ArneAlberts/Bachelorarbeit_Anhang/readme.md

Inhalt:
---------------------------------
Digitale Version der Arbeit
Großen Blockschaltbild
Technische Zeichnung der Platine
Diese Datei

Ordner:
---------------------------------
Schaltung/Layout
Datenblätter
Simulationen
Software
Sonstiges

Software:
---------------------------------
Test-Programm für den MXL7704
Python-Script um Referenzen von Kondensatoren und Widerstände unsichtbar zu schalten

Simulation:
---------------------------------
Eingangsfilter
OPV mit LDO
Schutzschaltungen

Sonstiges:
---------------------------------
Design Rules Multi Circuits Boards

Datenblätter:
---------------------------------
FPGA: User Guides: 470, 471, 475, 480, 482, 483, Foto: Pinout

Schaltkreise:
---------------------------------
USB-Hub: TUSB2046
Ethernet-Phy: KSZ8041
Mikrocontroller: MSP430F5510
FTDI: FT2232H
Current-limiter: TPS2042D
Flash-Speicher: S25FL128SA
DDR3-RAM: MT41K128M16JT
DAC: LTC2627
OPV: OPA2991
Referenzspannung: REF3120
ADC: ADS1115

Diskrete Halbleiter:
---------------------------------
PMOS: Si3421DV
NMOS: BSS127
NMOS: BSS138
Shunt-Regler: TL431
Zener-Diode: KDZVTR10B
HF-NMOS: AFT05MS003N
ESD-Diode: SN65220
BPT: BC847

Spannungsversorgung:
---------------------------------
PMIC: MXL7704
LDO: TPS74012
Boost-Konverter: ABXS002A3X41
LDO: LM1117
LDO: AP2303
LDO: TPS7A470x

Passive Bauteile:
---------------------------------
Sicherungen: NANOASMDCH050F/24-2, MF-USML350/12
Spulen: 74438367022, XEL4030-102, XEL4030-471
Ferrite: 74279224101, 742792043
Gleichtaktdrossel: 744237102

Mechanische Verbinder:
---------------------------------
Doppelte USB-A-Buchse: 61400826021
USB-B-Buchse: 61400416121
uSD-Karte: DM3AT-SF
Ethernet-Buchse: 7499011002
USB-C-Buchse: 632723300011
PCIE-Steckplatz: 10018783-10200TLF
Bias-verbinder: Samtec BSW-104-04-L-S
GPO/SMP: 60114102122403
Spannungsversorgung: TE_171826-4
Spy-By-Wire: TFM-104
Kühlkörper: PR19/20/SE
Buchse-Trigger-Eingang:TE 440054

Sonstiges:
---------------------------------
Takterzeugung: 
830207044109 (100 MHz)
ATS25ASM-1 (25 MHz)
ATS12ASM-1 (12 MHz)
ATS060SM-1 (6 MHz)
ATS040SM-1 (4 MHz)
ECS-.327-7-12-TR (32 kHz)
