ArneAlberts/Bachelorarbeit_Anhang/Datenblätter/Mechanische_Bauteile/PR19_20_SE.pdf

Type: PR19/20/SE | Spezialkühlkörper

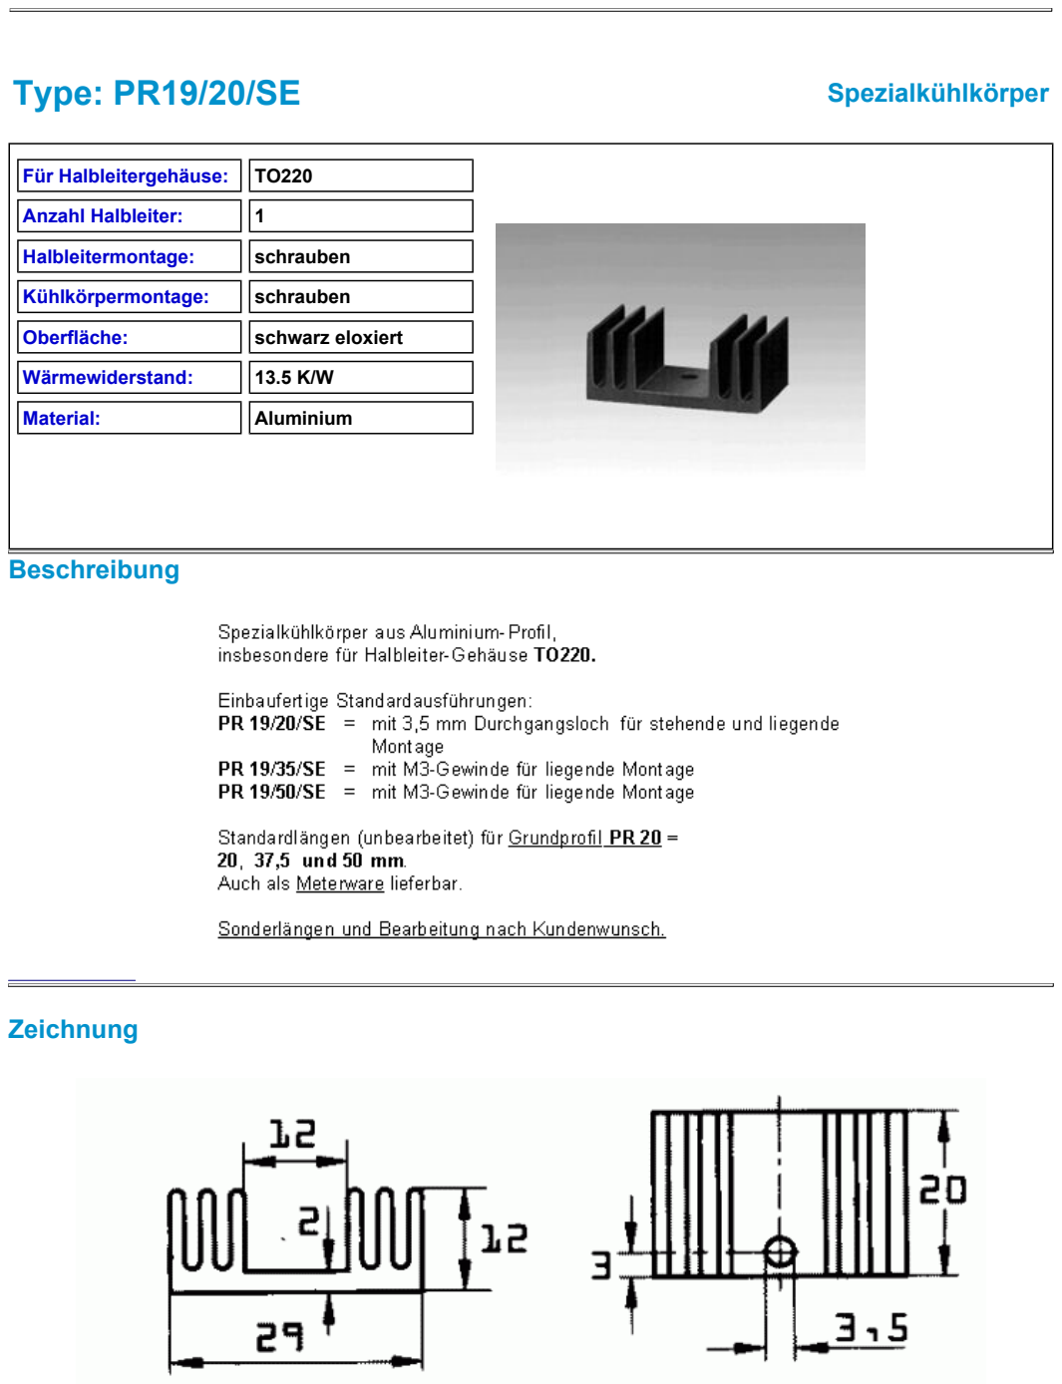
[picture p1: page 1]

## Zeichnung

Für Halbleitergehäuse: | TO220
Anzahl Halbleiter: | 1
Halbleitermontage: | schrauben
Kühlkörpermontage: | schrauben
Oberfläche: | schwarz eloxiert
Wärmewiderstand: | 13.5 K/W
Material: | Aluminium

## Beschreibung
