ArneAlberts/Bachelorarbeit_Anhang/Datenblätter/FPGA/FGG484_IO_OUT.PNG

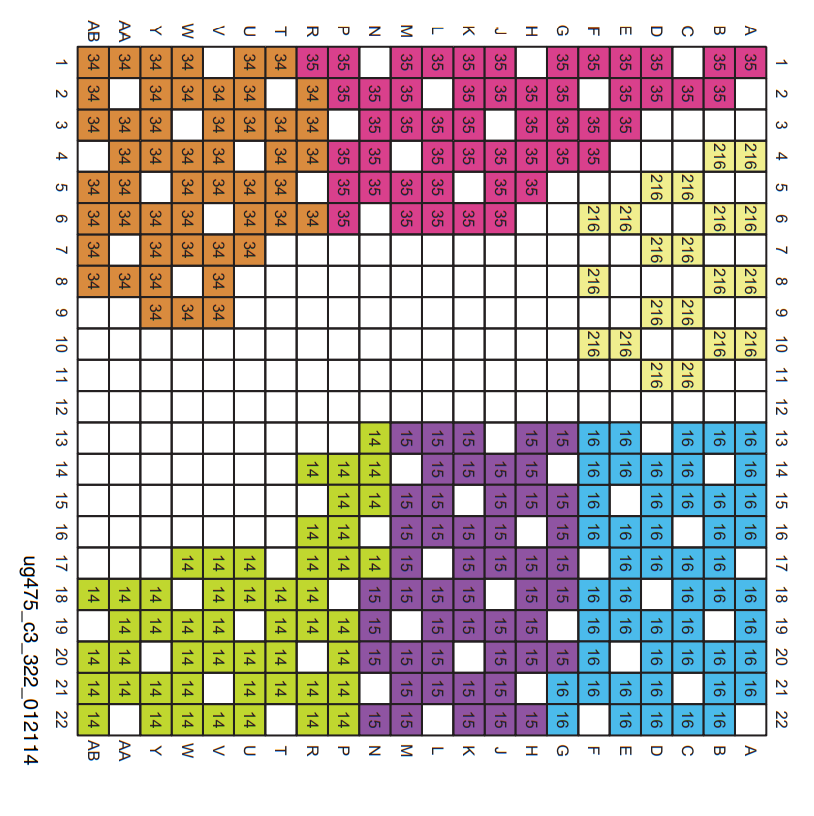
Datenblätter/FPGA/FGG484_IO_OUT.PNG
