ArneAlberts/Bachelorarbeit_Anhang/Schaltung_Layout/3dpackages/i3a_fullfeature_asm.stp

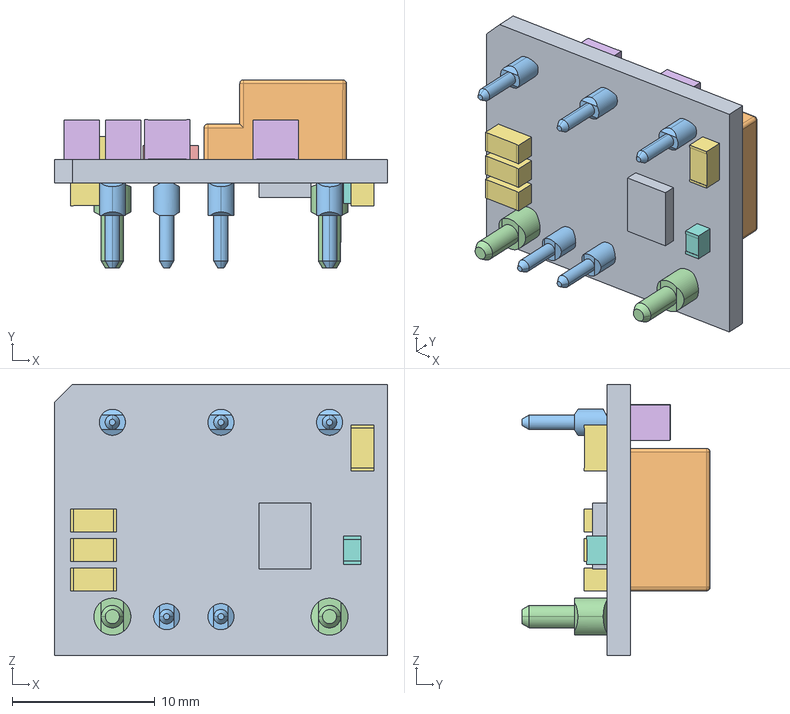
[picture p3: CAD file, 2021-09-20]
Schaltung_Layout/3dpackages/i3a_fullfeature_asm.stp
23.4 x 13.2 x 19.1 mm
I3A_PCB
I3A_OUTPUT_INDUCTOR
ZP00166_01- x 5
ZP00167_01- x 2
I6A_HIGH_SIDE_FET x 2
1210_CAP_COLOR x 4
1206_CAP_COLOR x 6
0805_CAP
I6A_CONTROL_IC2
