ArneAlberts/Bachelorarbeit_Anhang/Schaltung_Layout/3dpackages/modulator-Body_LWL_test.step

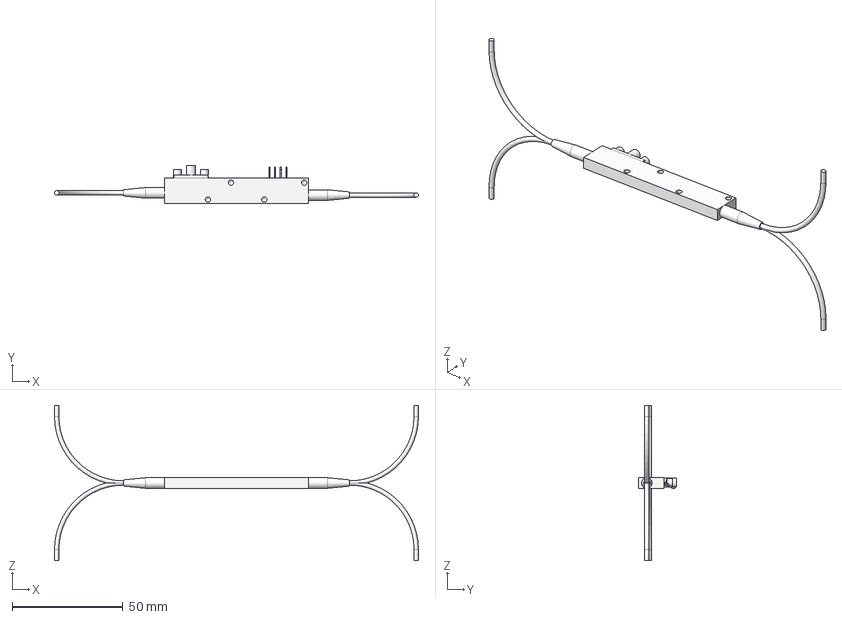
[picture p4: CAD file, 2021-09-20]
Schaltung_Layout/3dpackages/modulator-Body_LWL_test.step
164.0 x 17.2 x 70.0 mm
