ArneAlberts/Bachelorarbeit_Anhang/Schaltung_Layout/Adapter_Modulator/Adapter_Modulator/Adapter_Modulator.step

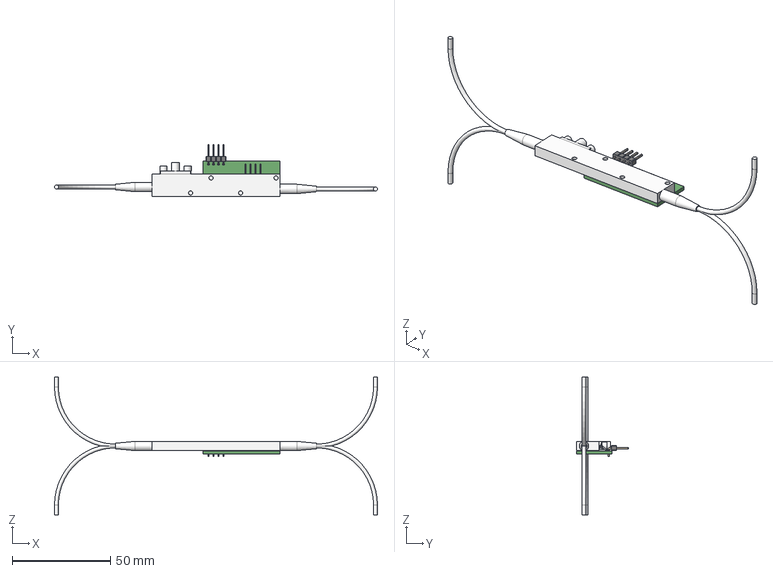
[picture p5: CAD file, 2021-09-20]
Schaltung_Layout/Adapter_Modulator/Adapter_Modulator/Adapter_Modulator.step
164.0 x 26.4 x 70.0 mm
