ArneAlberts/Bachelorarbeit_Anhang/Schaltung_Layout/3dpackages/XEL4030-122MEC.stp

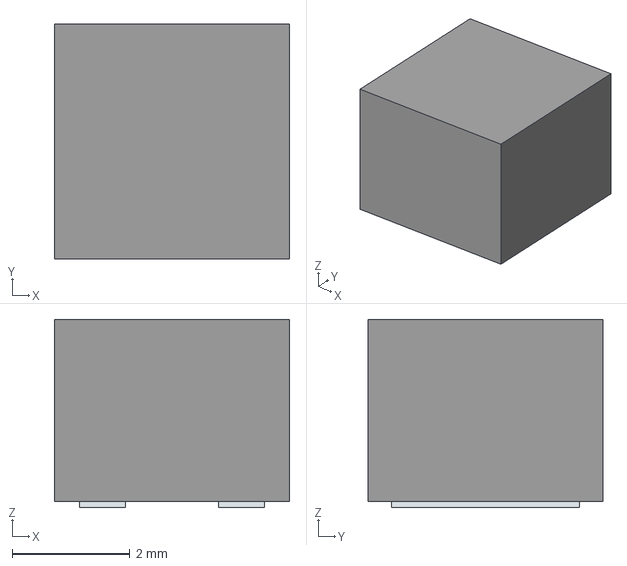
[picture p6: CAD file, 2021-09-20]
Schaltung_Layout/3dpackages/XEL4030-122MEC.stp
4.00 x 4.00 x 3.20 mm
Pins
