ArneAlberts/Bachelorarbeit_Anhang/Schaltung_Layout/3dpackages/ABXS002A3X41-SRZ.stp

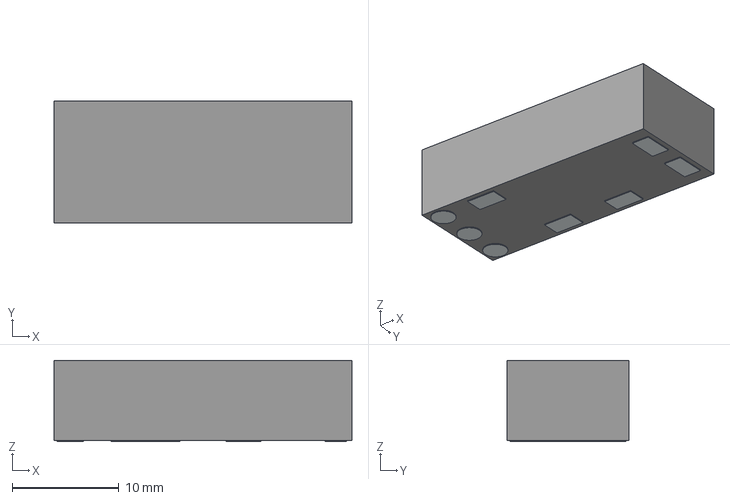
[picture p7: CAD file, 2021-09-20]
Schaltung_Layout/3dpackages/ABXS002A3X41-SRZ.stp
27.9 x 11.4 x 7.60 mm
Pins
