ArneAlberts/Bachelorarbeit_Anhang/Schaltung_Layout/3dpackages/WE-CMDC_744237xxx.stp

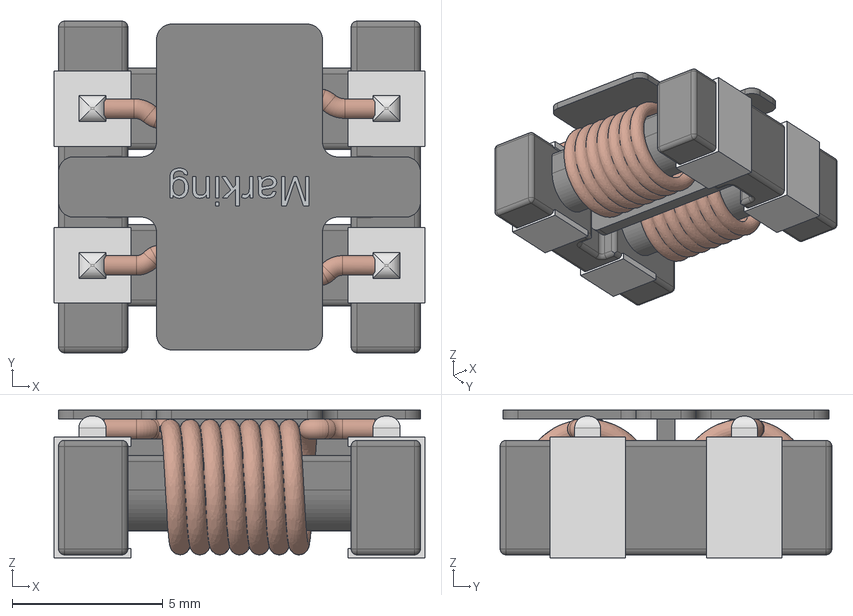
[picture p8: CAD file, 2021-09-20]
Schaltung_Layout/3dpackages/WE-CMDC_744237xxx.stp
12.3 x 11.0 x 4.90 mm
Cap
Ferrite
Coil
Coil_2
