ArneAlberts/Bachelorarbeit_Anhang/Schaltung_Layout/3dpackages/modulator-Body.stp

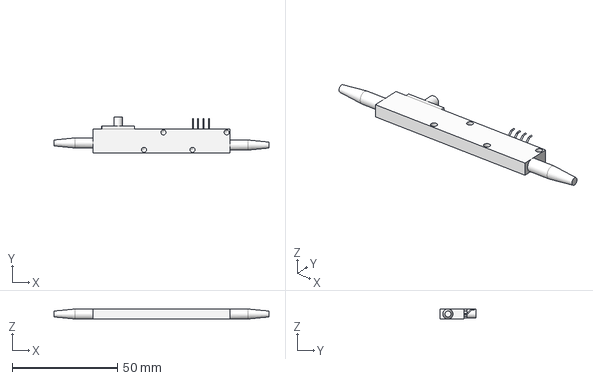
[picture p9: CAD file, 2021-09-20]
Schaltung_Layout/3dpackages/modulator-Body.stp
102.0 x 17.2 x 4.80 mm
