ArneAlberts/Bachelorarbeit_Anhang/Schaltung_Layout/3dpackages/BSW-104-X-X-S.step

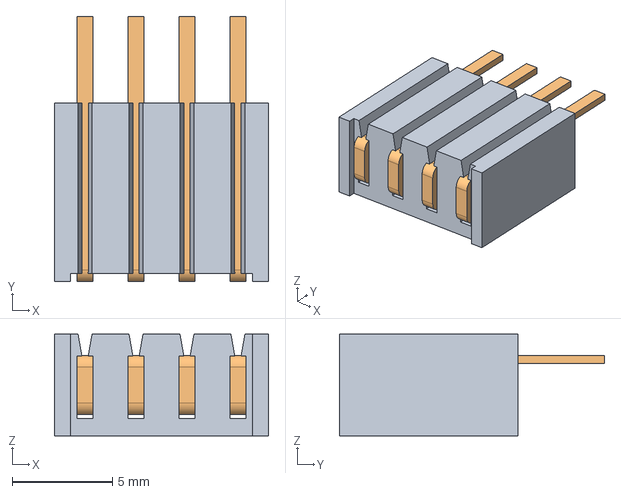
[picture p10: CAD file, 2021-09-20]
Schaltung_Layout/3dpackages/BSW-104-X-X-S.step
10.7 x 13.2 x 5.08 mm
_BSW-04-04-S_socket
_C-8-5-01-04-S
