ArneAlberts/Bachelorarbeit_Anhang/Schaltung_Layout/3dpackages/KK_V_4330_N.step

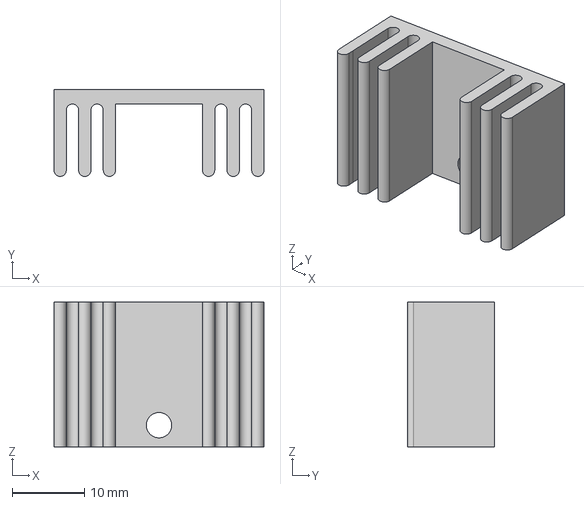
[picture p11: CAD file, 2021-09-20]
Schaltung_Layout/3dpackages/KK_V_4330_N.step
29.0 x 12.0 x 20.0 mm
