ArneAlberts/Bachelorarbeit_Anhang/Schaltung_Layout/3dpackages/CUI_DEVICES_HSE-B20254-035H-01.step

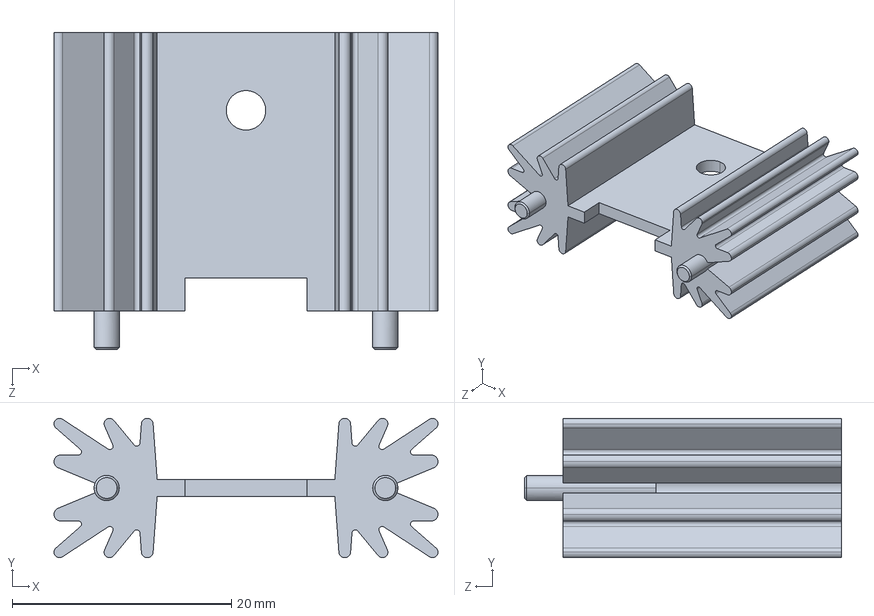
[picture p12: CAD file, 2021-09-20]
Schaltung_Layout/3dpackages/CUI_DEVICES_HSE-B20254-035H-01.step
35.0 x 12.7 x 28.9 mm
