ArneAlberts/Bachelorarbeit_Anhang/Schaltung_Layout/3dpackages/Amphenol_10018783_10200TLF.stp

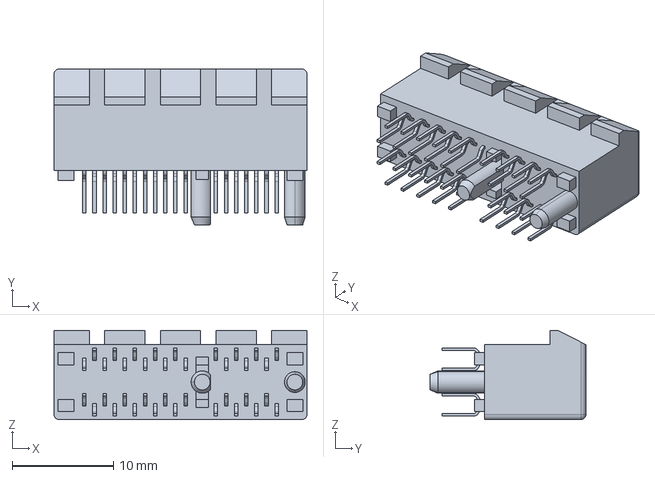
[picture p13: CAD file, 2021-09-20]
Schaltung_Layout/3dpackages/Amphenol_10018783_10200TLF.stp
25.0 x 15.4 x 8.80 mm
