ArneAlberts/Bachelorarbeit_Anhang/Schaltung_Layout/3dpackages/60124102122403.stp

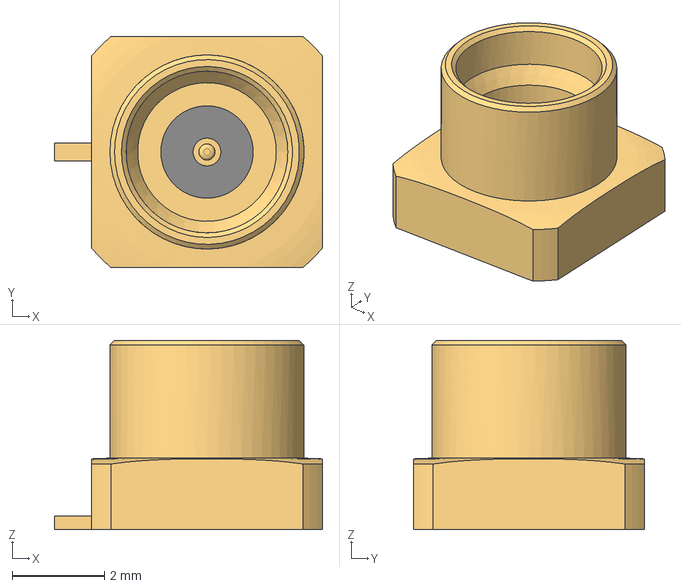
[picture p14: CAD file, 2021-09-20]
Schaltung_Layout/3dpackages/60124102122403.stp
5.80 x 5.00 x 4.10 mm
