ArneAlberts/Bachelorarbeit_Anhang/Schaltung_Layout/3dpackages/61400826021.stp

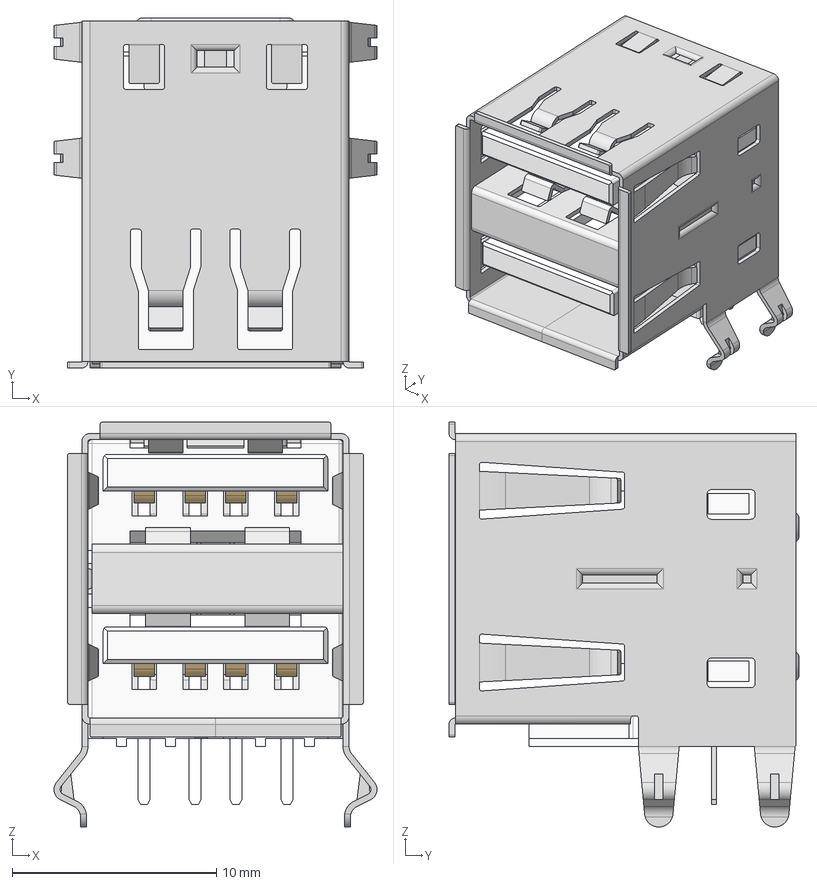
[picture p15: CAD file, 2021-09-20]
Schaltung_Layout/3dpackages/61400826021.stp
15.8 x 17.1 x 19.8 mm
61400826021_Shielding1
61400826021_Housing
61400826021_Shielding2
61400826021_Pin2 x 4
61400826021_Pin1 x 4
61400826021_Shielding3
