ArneAlberts/Bachelorarbeit_Anhang/Schaltung_Layout/3dpackages/171826-4.stp

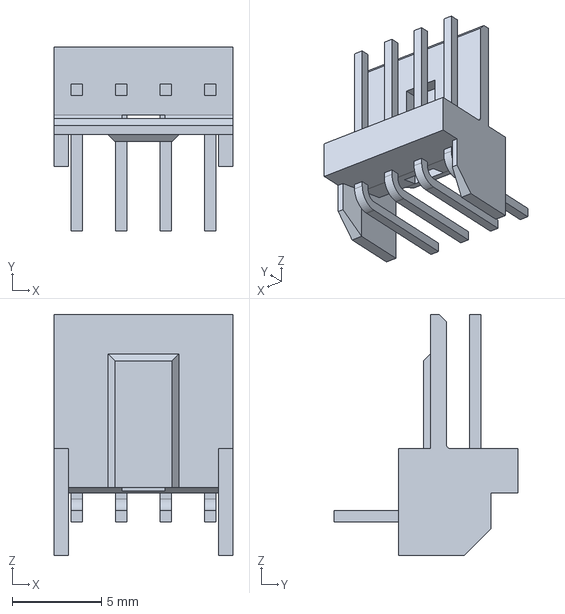
[picture p16: CAD file, 2021-09-20]
Schaltung_Layout/3dpackages/171826-4.stp
10.0 x 10.3 x 13.5 mm
