ArneAlberts/Bachelorarbeit_Anhang/Schaltung_Layout/3dpackages/174804-1.stp

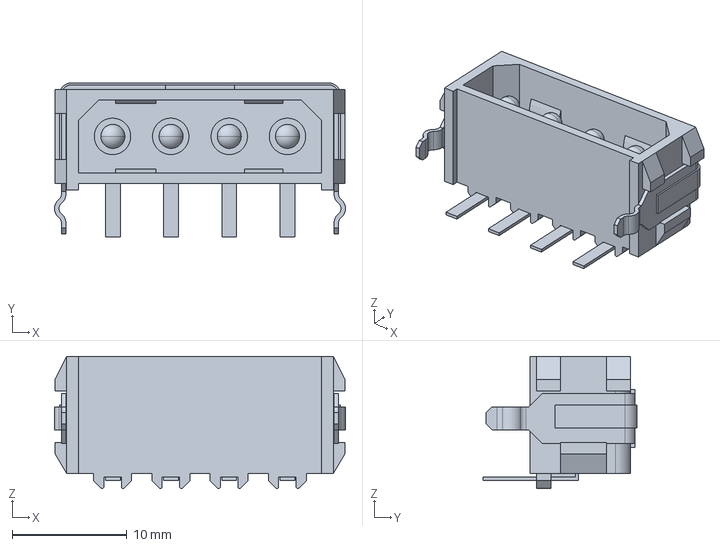
[picture p17: CAD file, 2021-09-20]
Schaltung_Layout/3dpackages/174804-1.stp
25.4 x 13.5 x 11.5 mm
