ArneAlberts/Bachelorarbeit_Anhang/(list of files, cad)

Other CAD files:
Schaltung_Layout/3dpackages/Adapter_Modulator.step
Schaltung_Layout/3dpackages/PR_19_20_SE.stp
Schaltung_Layout/3dpackages/modulator-Body_LWL.step
Schaltung_Layout/3dpackages/440054-2.stp
Schaltung_Layout/3dpackages/61400416121.stp
Schaltung_Layout/3dpackages/72309-8014BLFc.stp
Schaltung_Layout/3dpackages/74438367xxx.stp
Schaltung_Layout/3dpackages/7499011002A.stp
