ArneAlberts/Bachelorarbeit_Anhang/Datenblätter/Daten_Eval_ Boards/KSZ8041TL-FTL_v1.4_DP/Schematic/Eval Board/Board Revision 1.1/KSZ8041TL-FTL Eval Board Rev1.1 -- Schematic rev2.0.pdf

DATE | DESCRIPTION | REVISION *

# Table of Contents

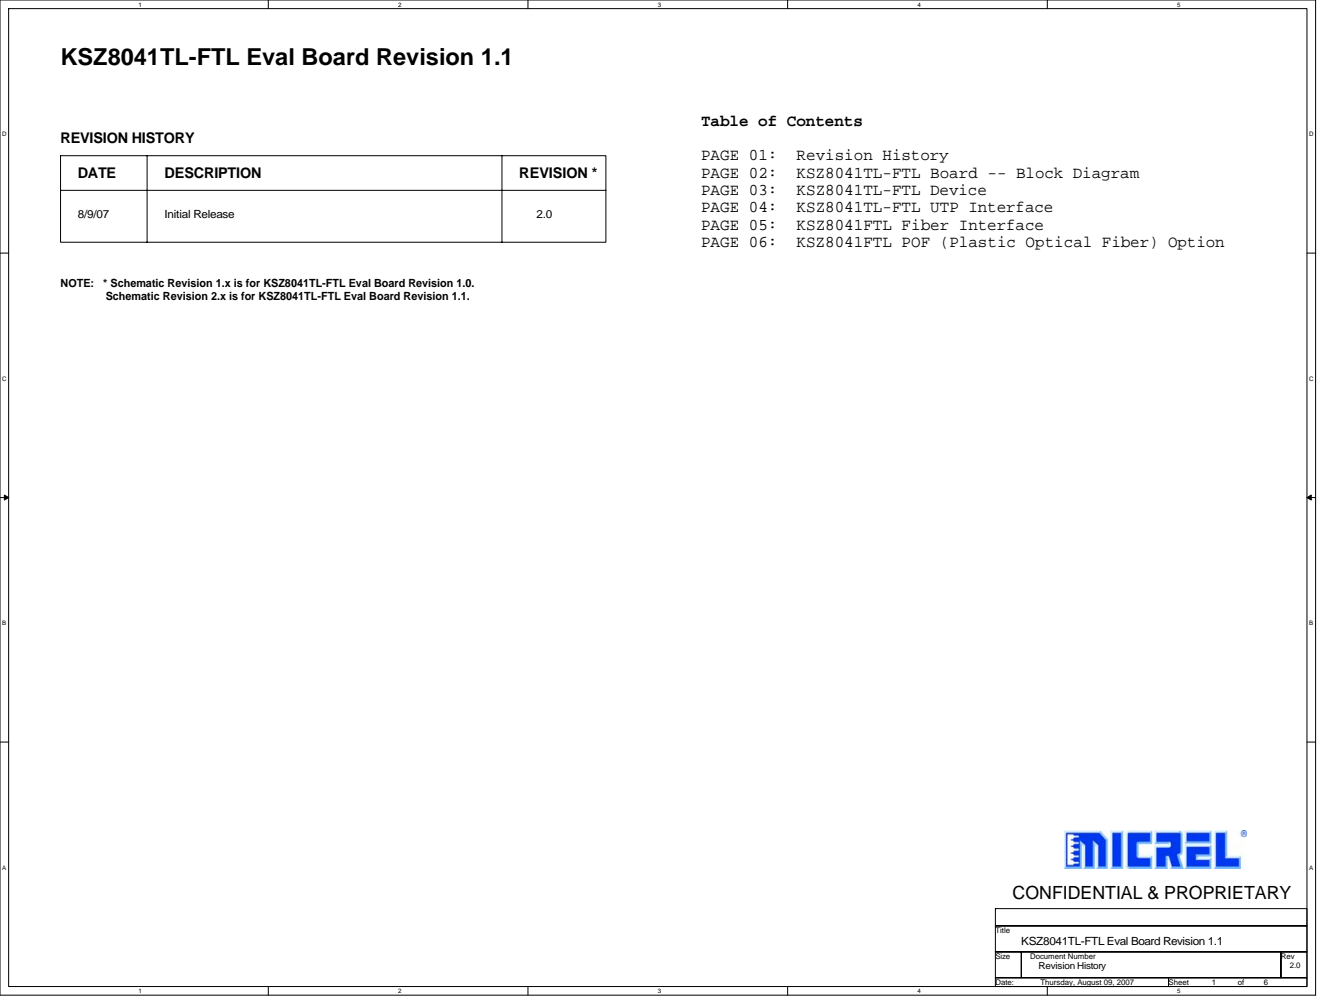
[picture p18: page 1]
CONFIDENTIAL & PROPRIETARY; REVISION HISTORY; Initial Release; PAGE 04: KSZ8041TL-FTL UTP Interface

KSZ8041TL-FTL Eval Board Revision 1.1

PAGE 01: Revision History
PAGE 02: KSZ8041TL-FTL Board -- Block Diagram
PAGE 03: KSZ8041TL-FTL Device
PAGE 05: KSZ8041FTL Fiber Interface
PAGE 06: KSZ8041FTL POF (Plastic Optical Fiber) Option

NOTE: * Schematic Revision 1.x is for KSZ8041TL-FTL Eval Board Revision 1.0.

Schematic Revision 2.x is for KSZ8041TL-FTL Eval Board Revision 1.1.

Title

Size | Document Number Revision History | Rev 2.0

Date: Thursday, August 09, 2007 | Sheet 1 of 6

# KSZ8041TL_FTL EVAL BOARD - BLOCK DIAGRAM

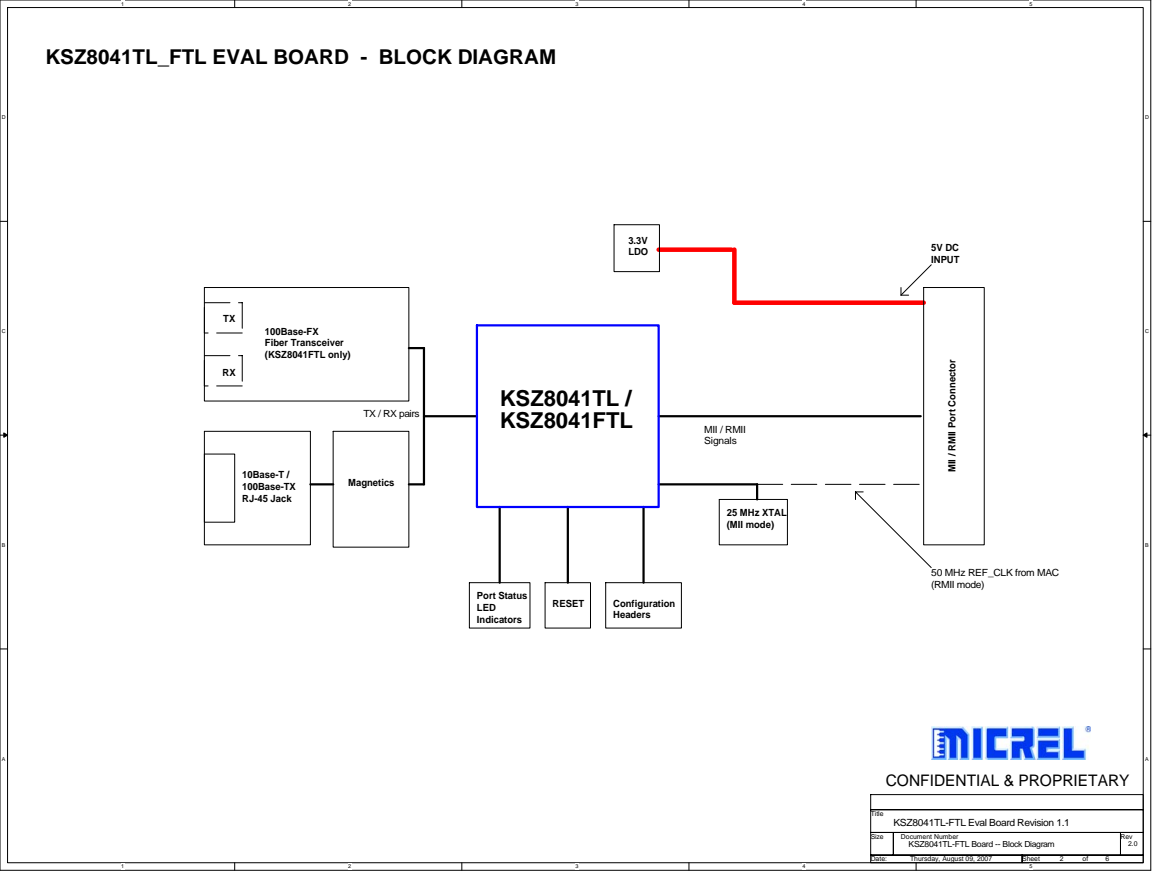
[picture p19: page 2]
Magnetics; RESET; 5V DC INPUT; Configuration Headers; 25 MHz XTAL (MII mode); KSZ8041TL / KSZ8041FTL; 100Base-FX Fiber Transceiver (KSZ8041FTL only); Port Status LED Indicators; 10Base-T / 100Base-TX RJ-45 Jack; 3.3V LDO; MII / RMII Signals; CONFIDENTIAL & PROPRIETARY

MII / RMII Port Connector

TX / RX pairs

50 MHz REF_CLK from MAC
(RMII mode)

Title
KSZ8041TL-FTL Eval Board Revision 1.1

KSZ8041TL-FTL Board -- Block Diagram | 2.0

Thursday, August 09, 2007 | 2 6

## Power_ON Reset

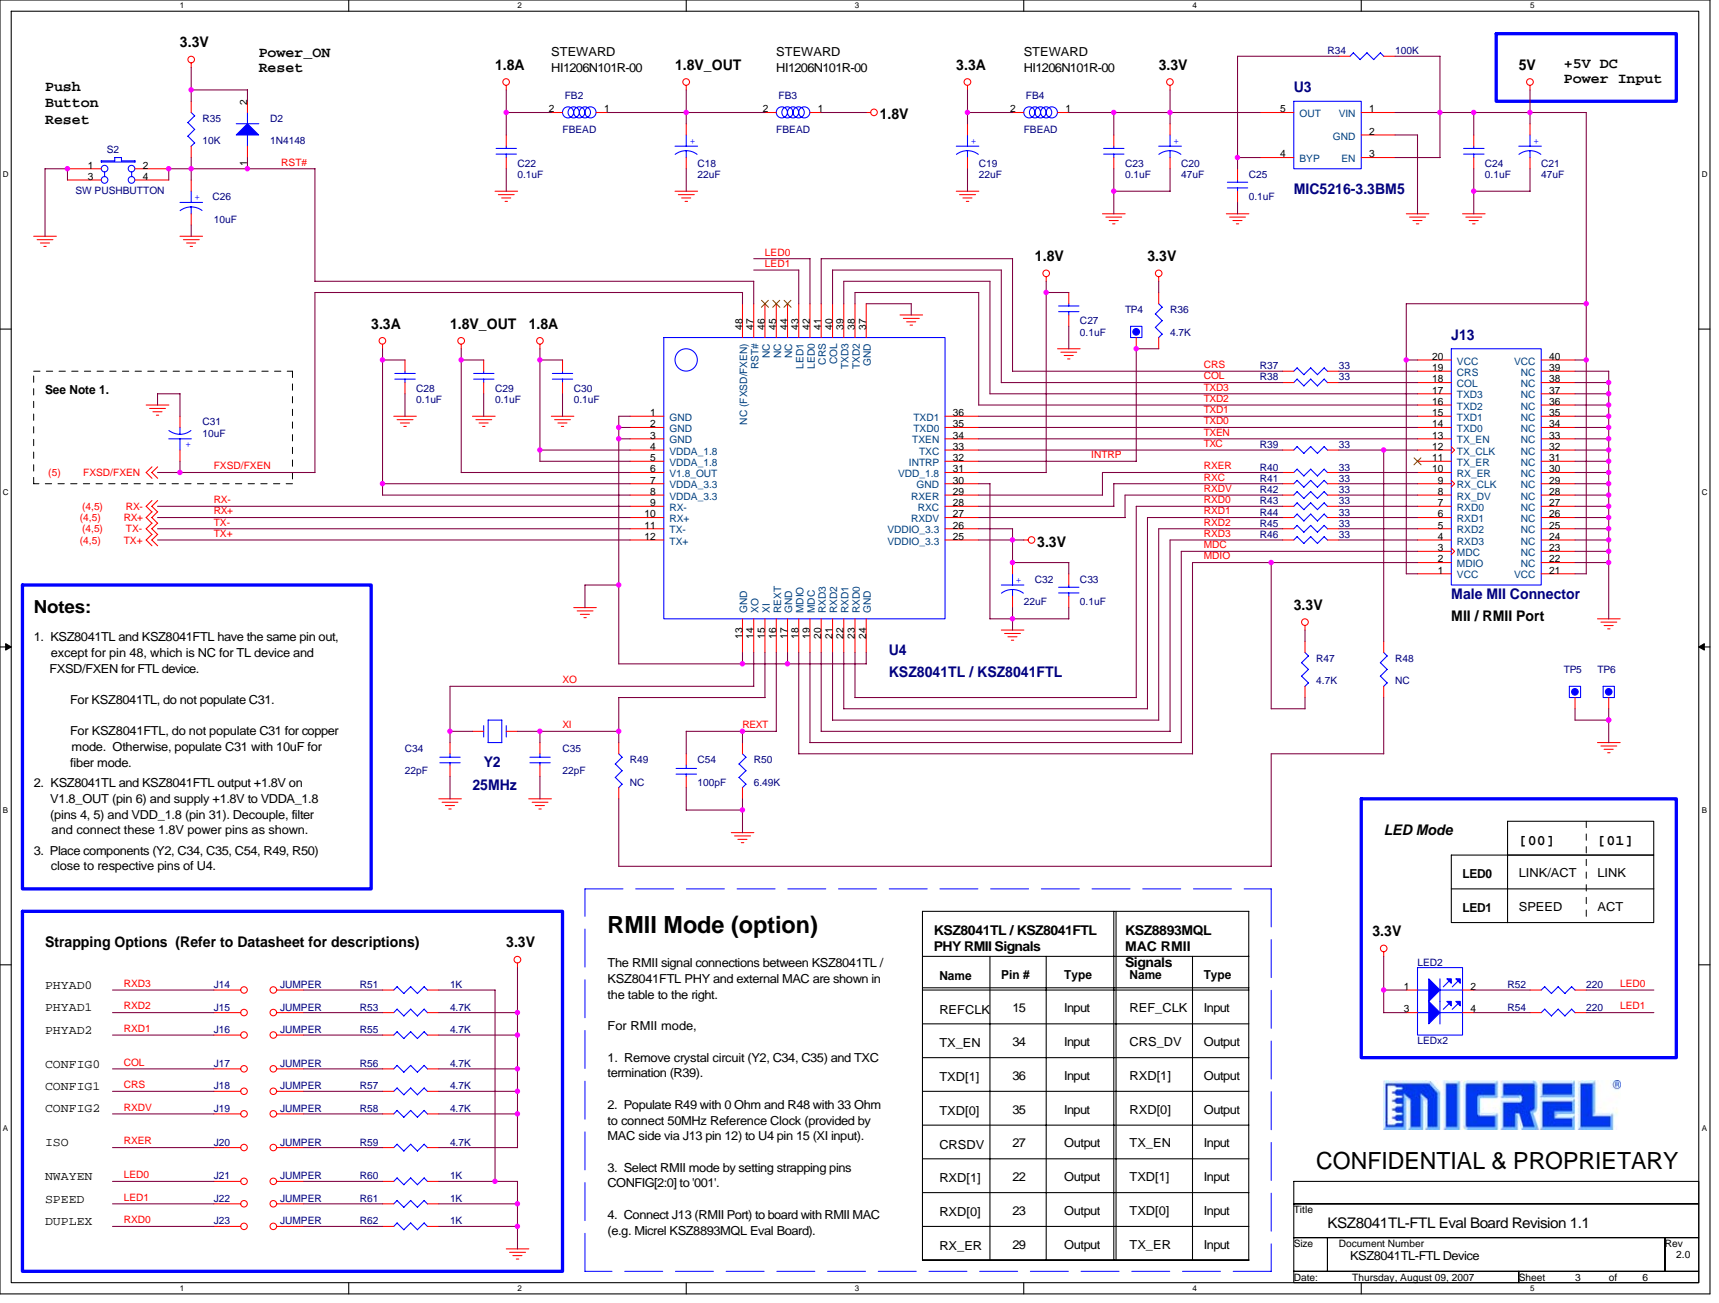
[picture p20: page 3]

1. KSZ8041TL and KSZ8041FTL have the same pin out,
except for pin 48, which is NC for TL device and
FXSD/FXEN for FTL device.

For KSZ8041TL, do not populate C31.

For KSZ8041FTL, do not populate C31 for copper
mode. Otherwise, populate C31 with 10uF for
fiber mode.
2. KSZ8041TL and KSZ8041FTL output +1.8V on
V1.8_OUT (pin 6) and supply +1.8V to VDDA_1.8
(pins 4, 5) and VDD_1.8 (pin 31). Decouple, filter
and connect these 1.8V power pins as shown.
3. Place components (Y2, C34, C35, C54, R49, R50)
close to respective pins of U4.

Strapping Options (Refer to Datasheet for descriptions)

The RMII signal connections between KSZ8041TL /
KSZ8041FTL PHY and external MAC are shown in
the table to the right.

Name | Pin # | Type | Signals Name | Type

REFCLK | 15 | Input | REF_CLK | Input

TX_EN | 34 | Input | CRS_DV | Output

1. Remove crystal circuit (Y2, C34, C35) and TXC
termination (R39).

TXD[1] | 36 | Input | RXD[1] | Output

2. Populate R49 with 0 Ohm and R48 with 33 Ohm
to connect 50MHz Reference Clock (provided by
MAC side via J13 pin 12) to U4 pin 15 (XI input).

TXD[0] | 35 | Input | RXD[0] | Output

CRSDV | 27 | Output | TX_EN | Input

3. Select RMII mode by setting strapping pins
CONFIG[2:0] to '001'.

RXD[1] | 22 | Output | TXD[1] | Input

RXD[0] | 23 | Output | TXD[0] | Input

Title
KSZ8041TL-FTL Eval Board Revision 1.1

4. Connect J13 (RMII Port) to board with RMII MAC
(e.g. Micrel KSZ8893MQL Eval Board).

RX_ER | | Output | TX_ER | Input

KSZ8041TL-FTL Device | 2.0

Thursday, August 09, 2007 | 3 6

## Place components in box below close to KSZ8041

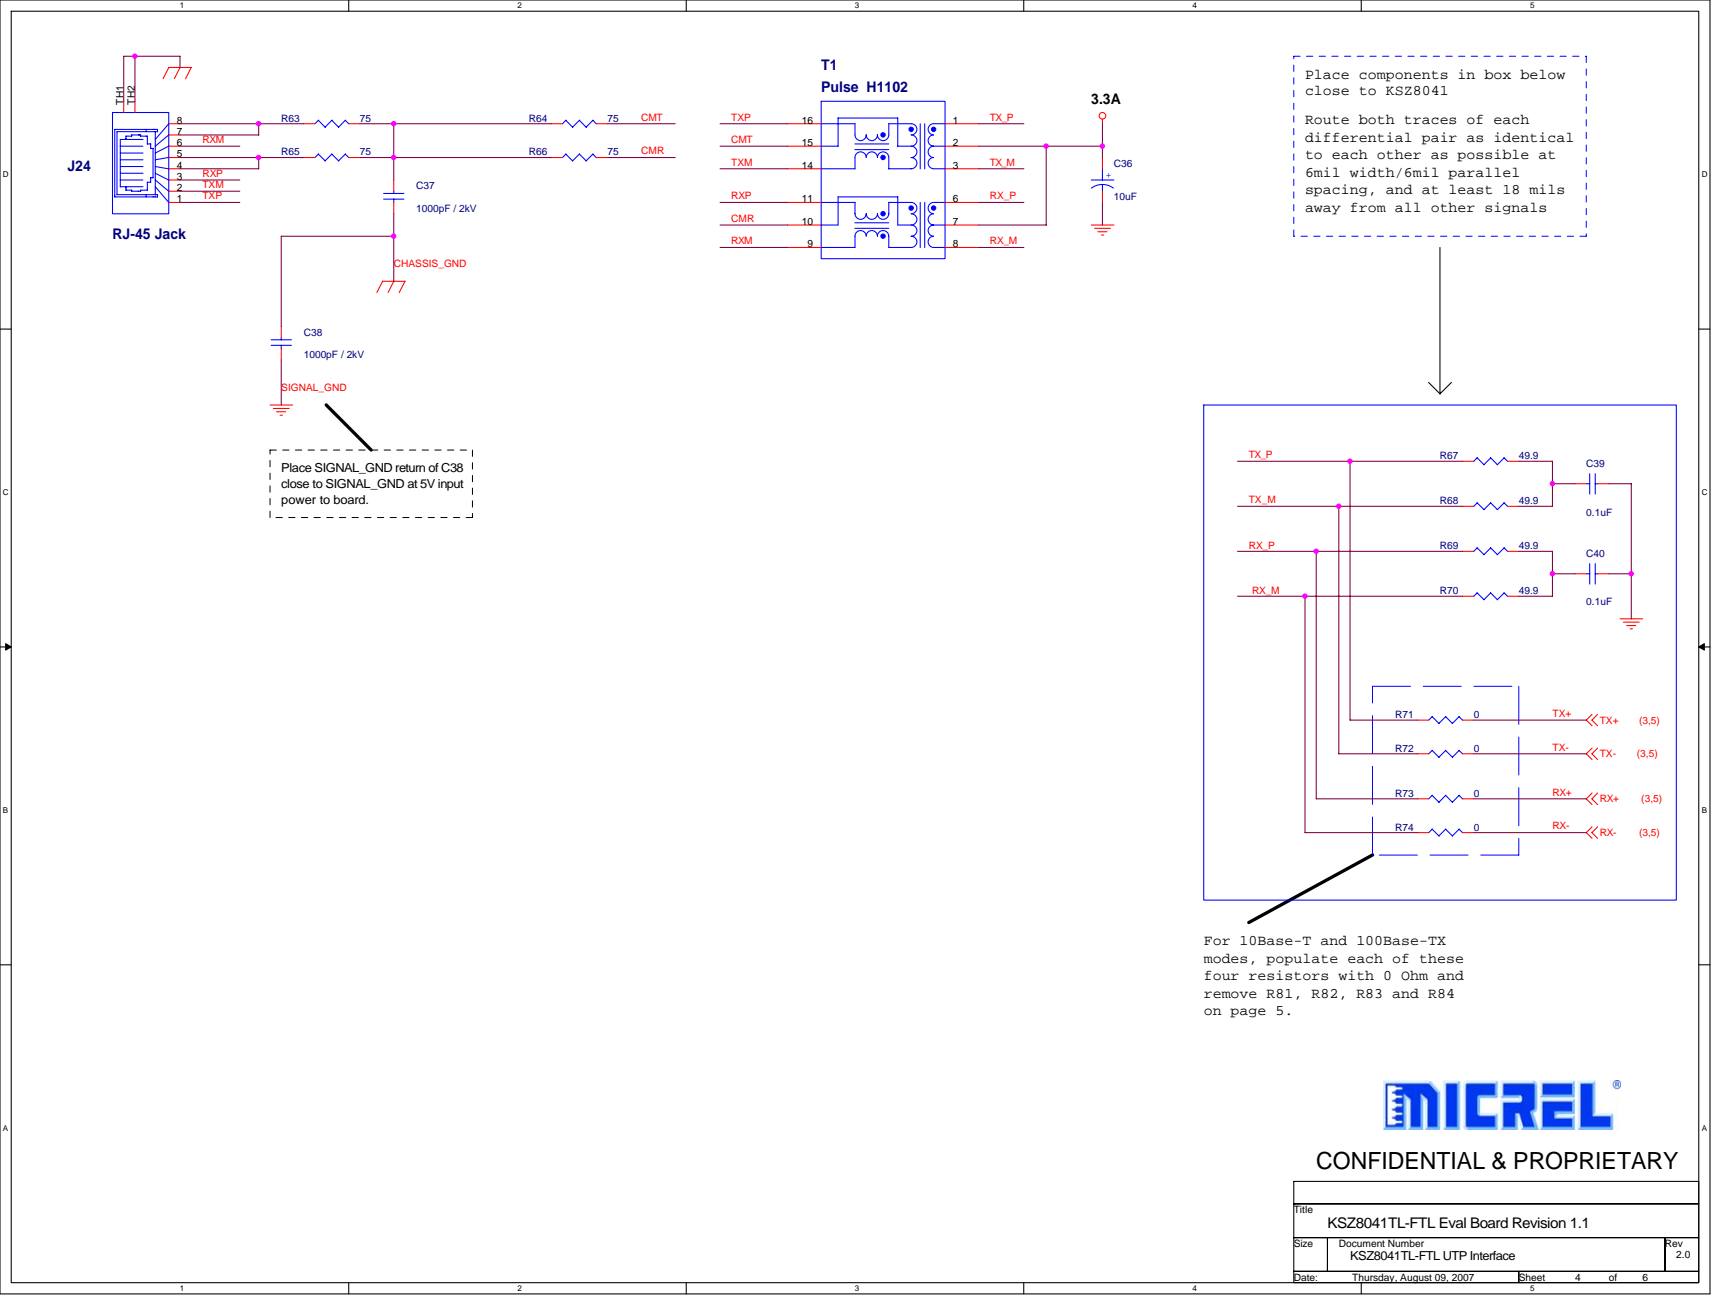
[picture p21: page 4]

Route both traces of each
differential pair as identical
to each other as possible at
6mil width/6mil parallel
spacing, and at least 18 mils
away from all other signals

Place SIGNAL_GND return of C38
close to SIGNAL_GND at 5V input
power to board.

For 10Base-T and 100Base-TX
modes, populate each of these
four resistors with 0 Ohm and
remove R81, R82, R83 and R84
on page 5.

Title
KSZ8041TL-FTL Eval Board Revision 1.1

KSZ8041TL-FTL UTP Interface | 2.0

Thursday, August 09, 2007 | 4 6

## Place components in dotted box close to

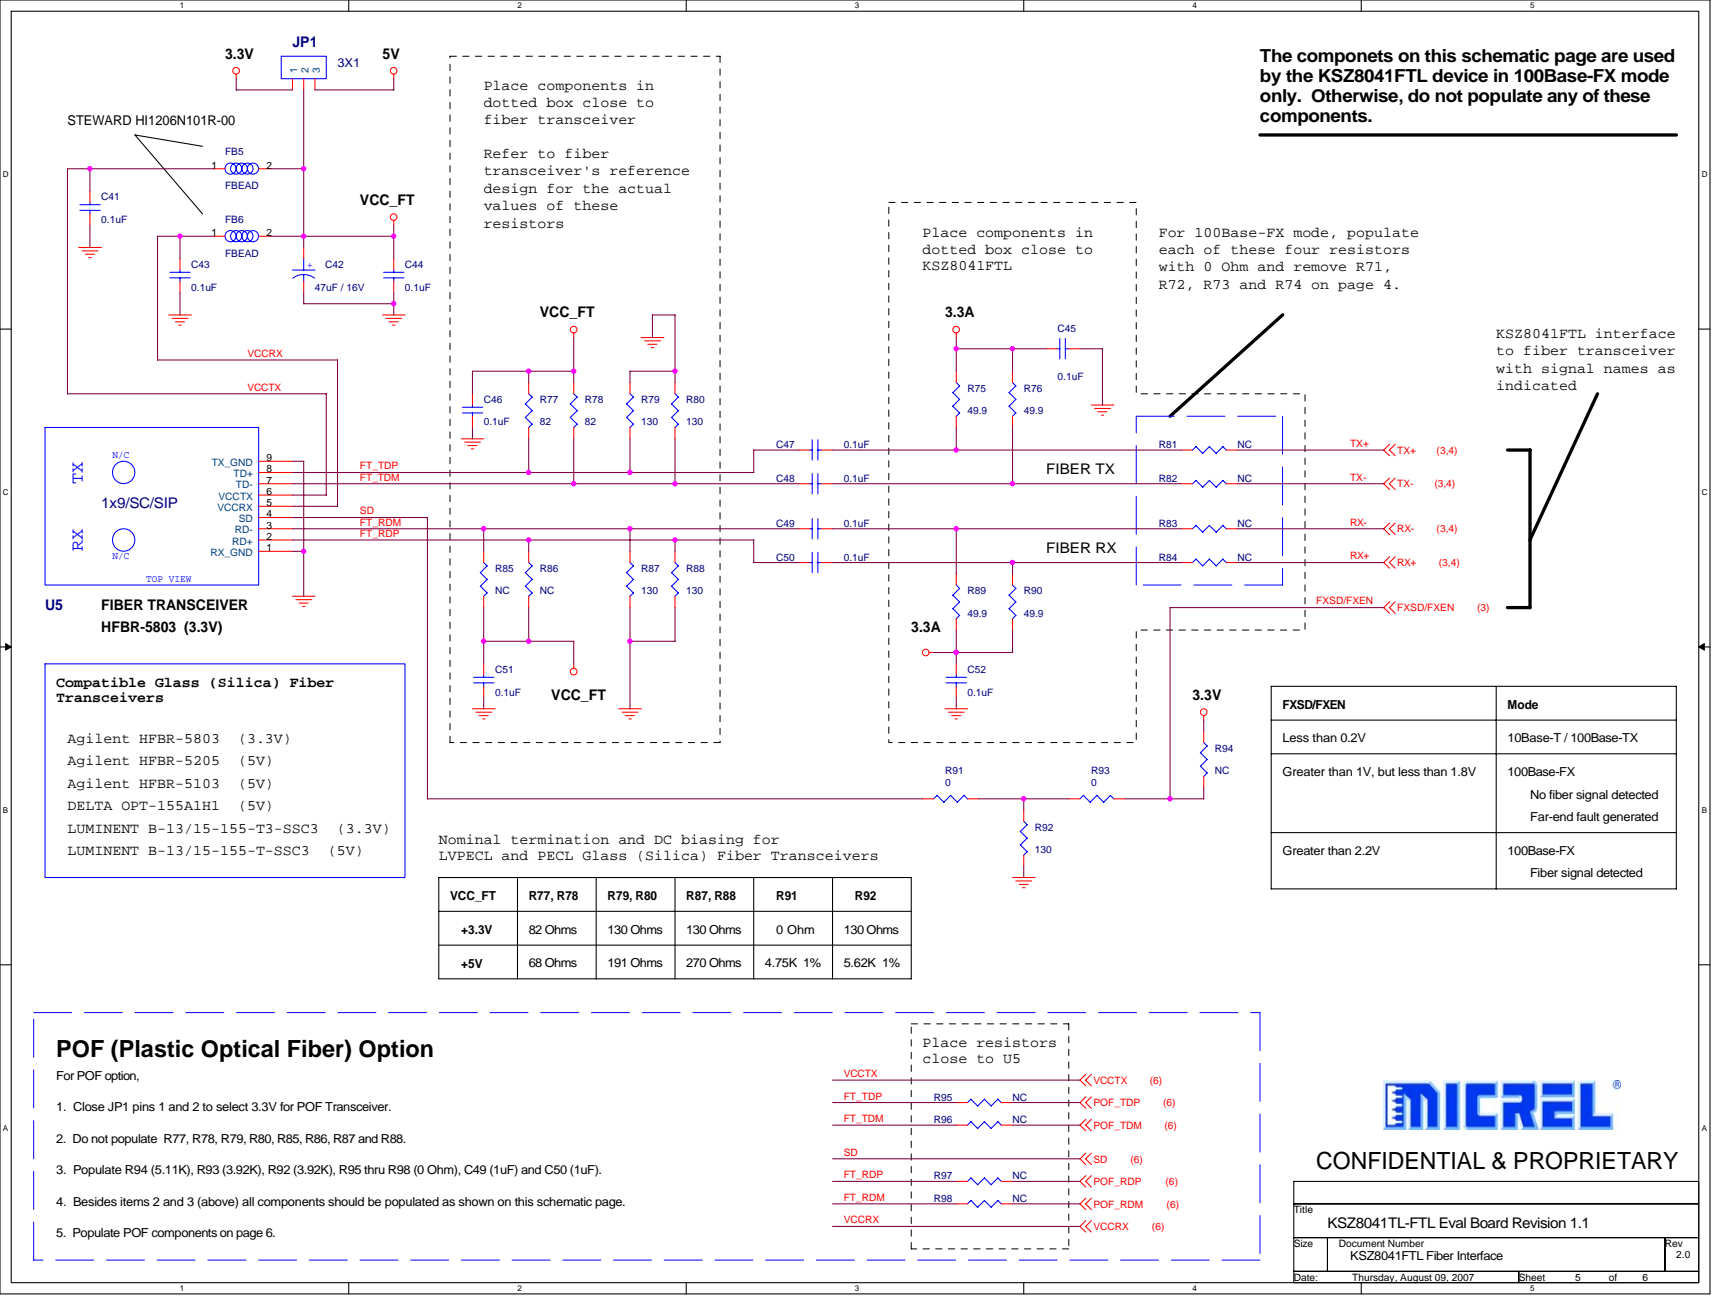
[picture p22: page 5]

The componets on this schematic page are used
by the KSZ8041FTL device in 100Base-FX mode
only. Otherwise, do not populate any of these
components.

Refer to fiber
transceiver's reference
design for the actual
values of these
resistors

Place components in
dotted box close to
KSZ8041FTL

For 100Base-FX mode, populate
each of these four resistors
with 0 Ohm and remove R71,
R72, R73 and R74 on page 4.

KSZ8041FTL interface
to fiber transceiver
with signal names as
indicated

Compatible Glass (Silica) Fiber
Transceivers

Greater than 1V, but less than 1.8V

100Base-FX
No fiber signal detected
Far-end fault generated

Nominal termination and DC biasing for
LVPECL and PECL Glass (Silica) Fiber Transceivers

VCC_FT | R77, R78 | R79, R80 | R87, R88 R91 | R92

+3.3V +5V | 82 Ohms 68 Ohms | 130 Ohms 191 Ohms | 130 Ohms 0 Ohm 270 Ohms | 130 Ohms 5.62K 1% 4.75K 1%

POF (Plastic Optical Fiber) Option

1. Close JP1 pins 1 and 2 to select 3.3V for POF Transceiver.

2. Do not populate R77, R78, R79, R80, R85, R86, R87 and R88.

3. Populate R94 (5.11K), R93 (3.92K), R92 (3.92K), R95 thru R98 (0 Ohm), C49 (1uF) and C50 (1uF).

4. Besides items 2 and 3 (above) all components should be populated as shown on this schematic page.

Title
KSZ8041TL-FTL Eval Board Revision 1.1

5. Populate POF components on page 6.

KSZ8041FTL Fiber Interface | 2.0

Thursday, August 09, 2007 | 5 6

# The componets on this schematic page are used by the KSZ8041FTL device in 100Base-FX mode

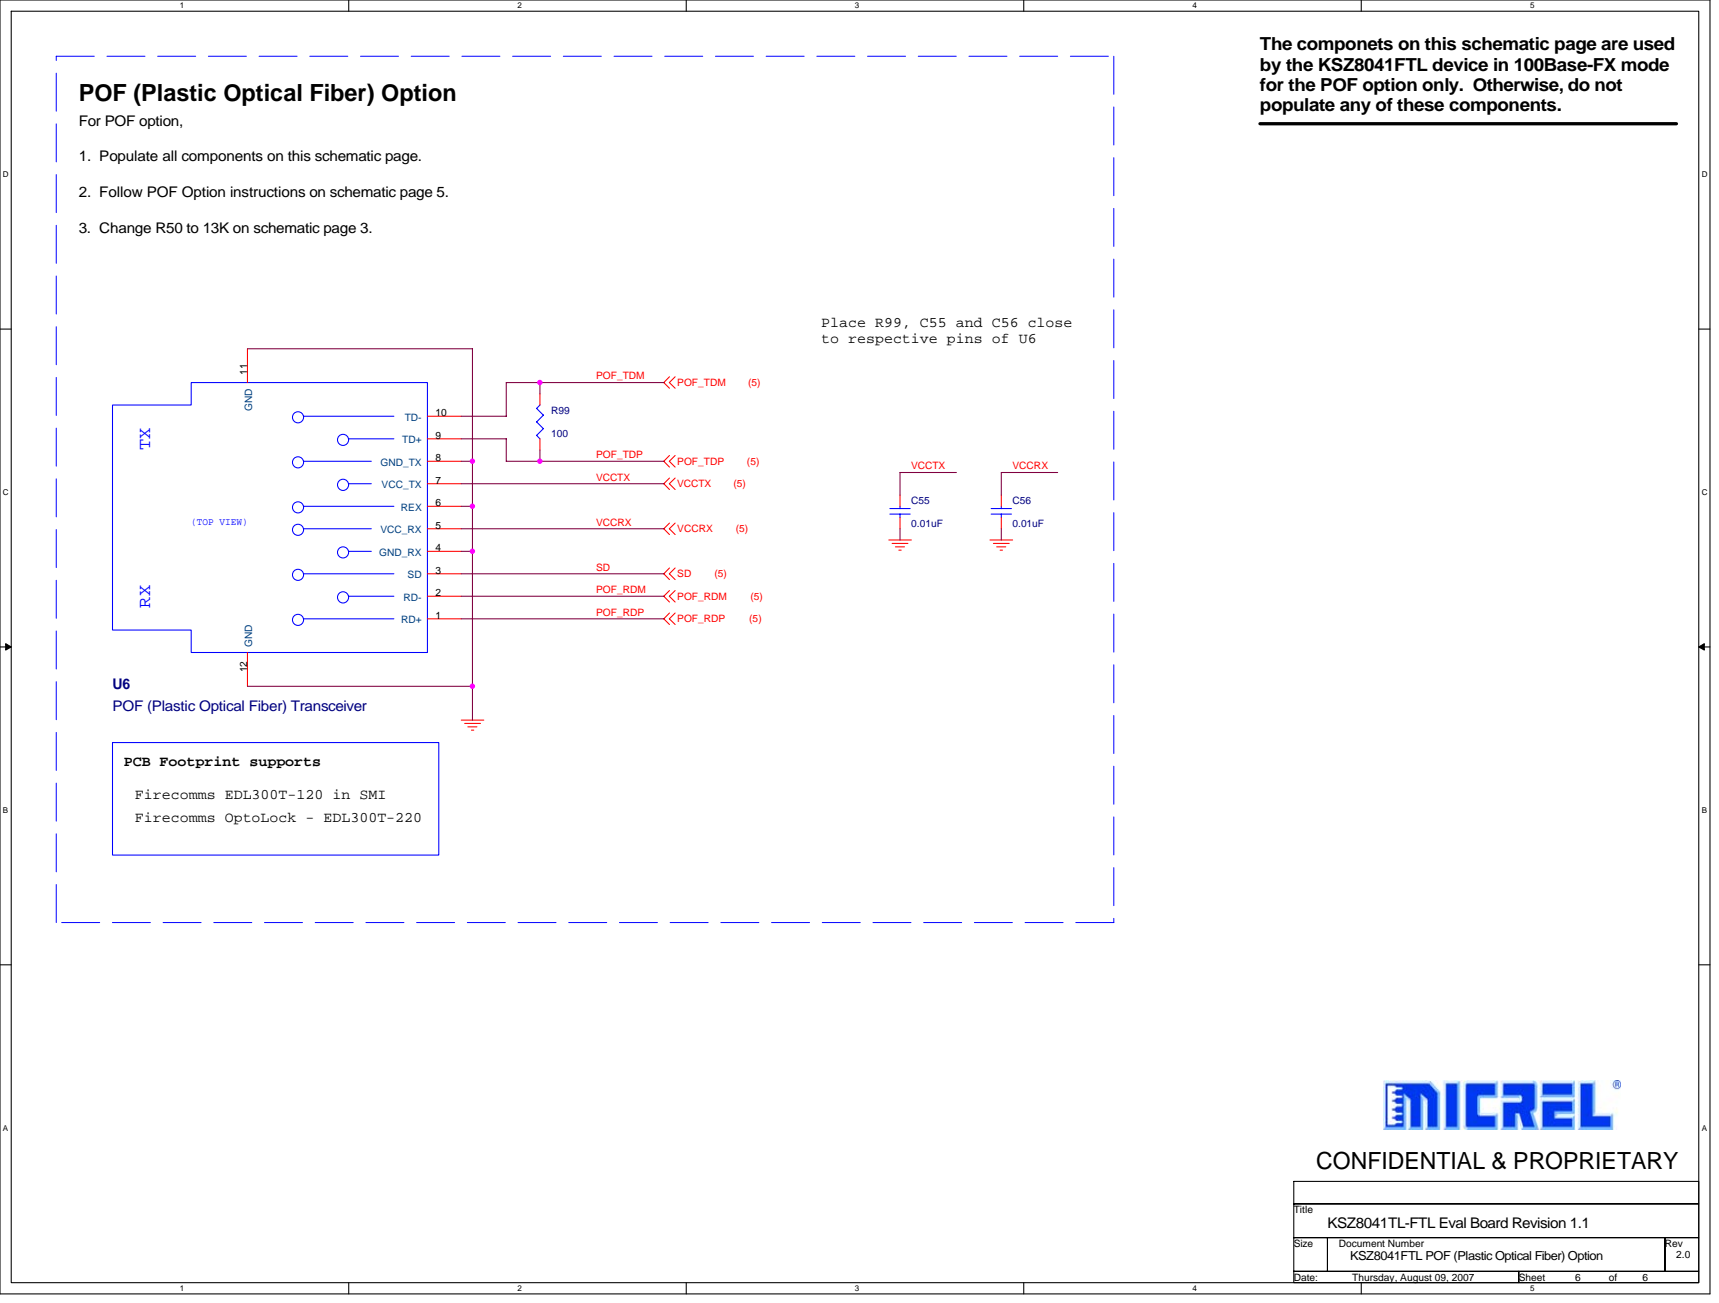
[picture p23: page 6]
CONFIDENTIAL & PROPRIETARY; POF_RDM; POF_RDP; VCCTX; VCCRX; POF_TDP; POF_TDM

for the POF option only. Otherwise, do not
populate any of these components.

POF (Plastic Optical Fiber) Option

For POF option,

1. Populate all components on this schematic page.

2. Follow POF Option instructions on schematic page 5.

3. Change R50 to 13K on schematic page 3.

Place R99, C55 and C56 close
to respective pins of U6

11 12 RD+ VCC_RX GND_RXSD RD- REX TD+ GND_TX VCC_TX TD- GND GND C55 0.01uF C56 0.01uF R99 100

RX TX (TOP VIEW)

POF (Plastic Optical Fiber) Transceiver

PCB Footprint supports

Firecomms EDL300T-120 in SMI
Firecomms OptoLock - EDL300T-220

Title
KSZ8041TL-FTL Eval Board Revision 1.1

KSZ8041FTL POF (Plastic Optical Fiber) Option | 2.0

Thursday, August 09, 2007 | 6 6
