ArneAlberts/Bachelorarbeit_Anhang/BA_FPGA_Board_BSB.pdf

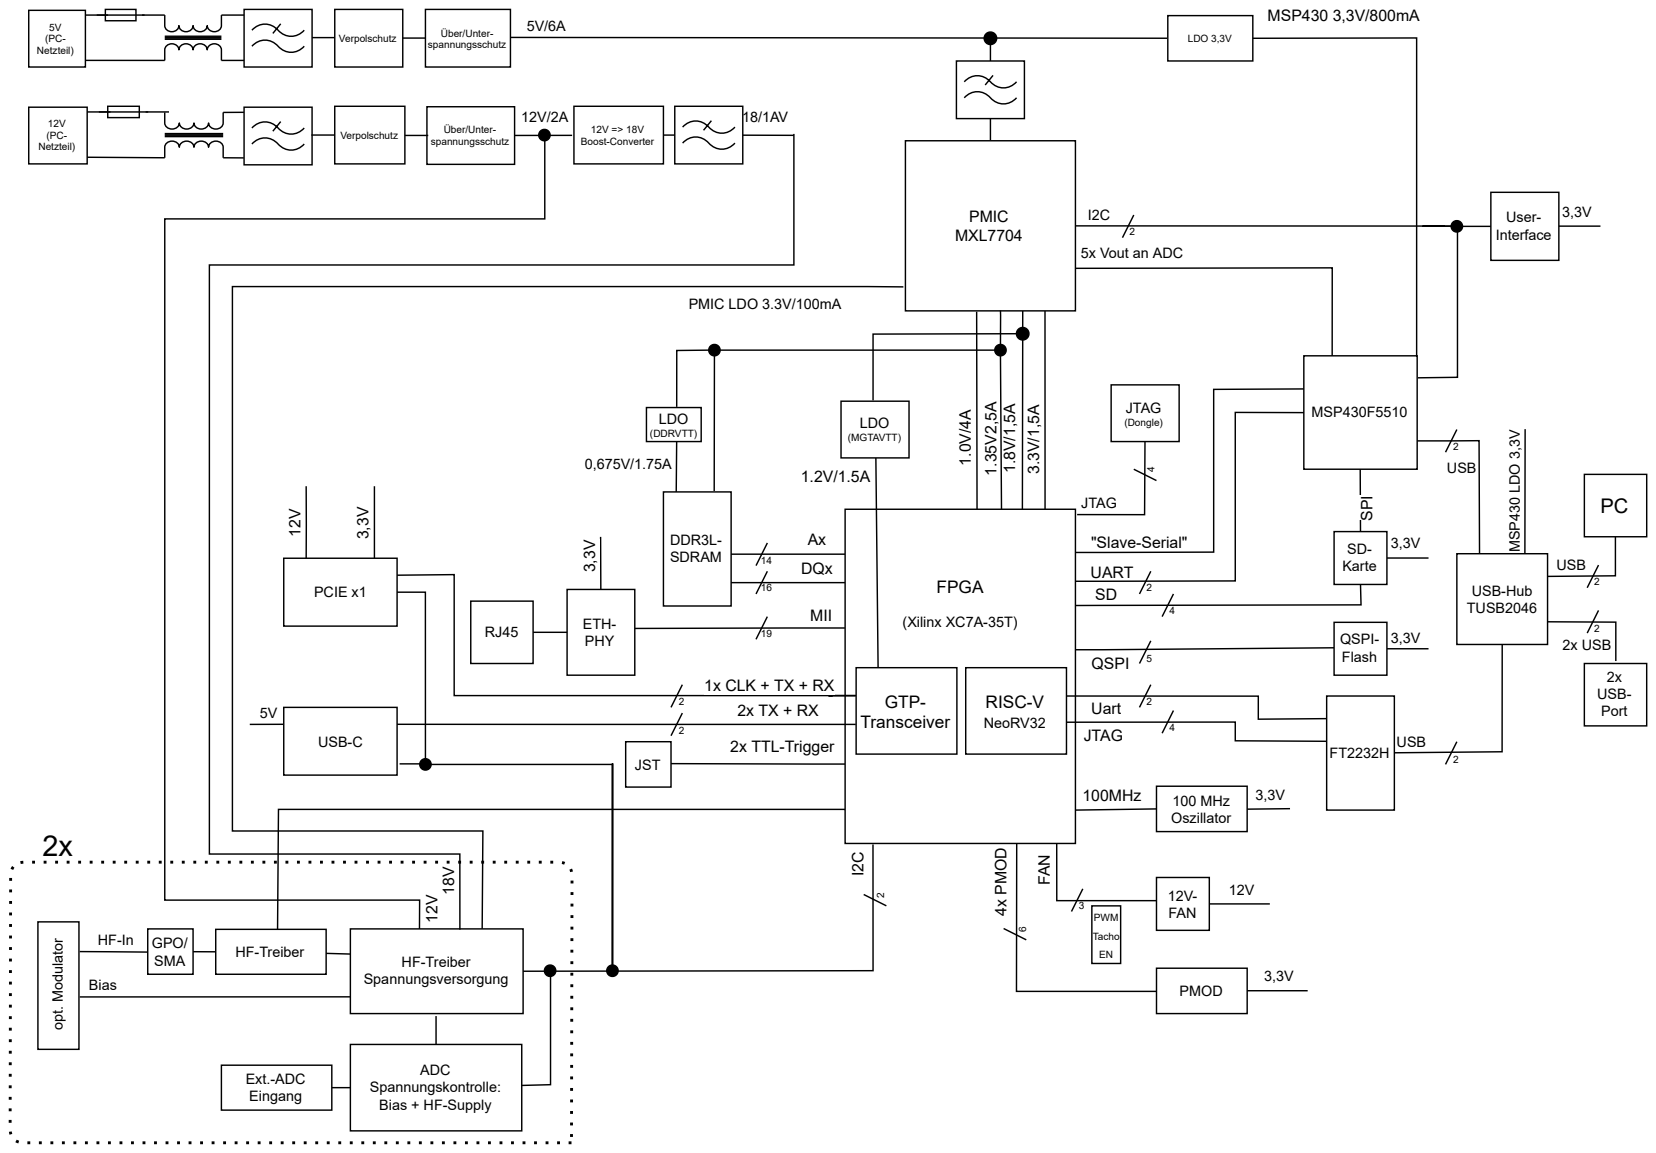
[picture p24: page 1]
"Slave-Serial"; QSPI; UART; MII; DQx; LDO; (MGTAVTT); FAN; PWM; Tacho; 2x TTL-Trigger; 2x HF-Output; 100MHz; Verpolschutz; Über/Unter-; spannungsschutz; 5V (PC- Netzteil); FPGA; (Xilinx XC7A-35T); RISC-V NeoRV32; GTP- Transceiver; PMIC LDO 3.3V/100mA; PMIC; MXL7704; LDO 3,3V; MSP430F5510; 4x PMOD; SPI; USB; MSP430 3,3V/800mA; 3,3V SD- Karte; JTAG; Uart; QSPI- 3,3V Flash; 2x USB; USB-Hub TUSB2046; MSP430 LDO 3,3V; 2x USB- Port; User- Interface; (Dongle); DDR3L- SDRAM; (DDRVTT); ETH-; PHY³,3V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

5x Vout an ADC

1x CLK + TX + RX

Spannungskontrolle:
Bias + HF-Supply
