ArneAlberts/Bachelorarbeit_Anhang/tec_draw_pcb.pdf

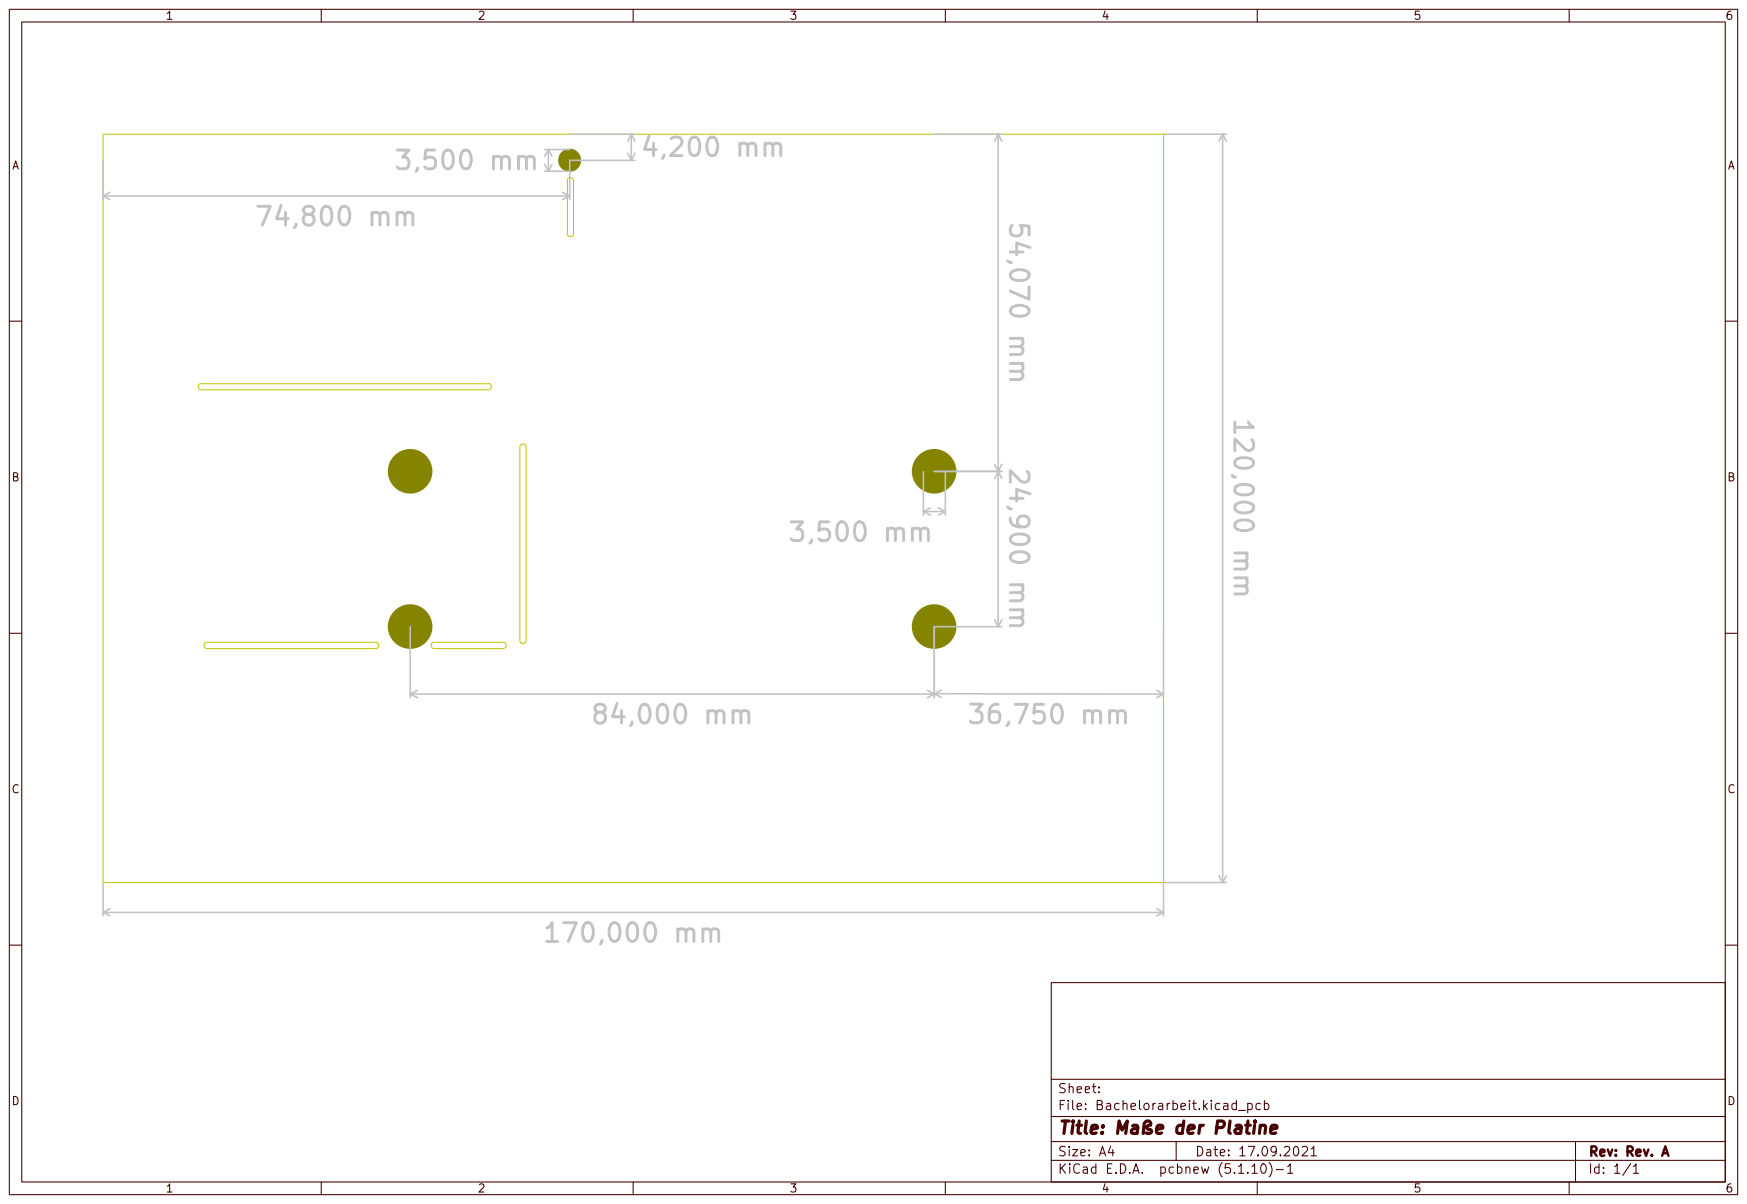
[picture p25: page 1]
