ArneAlberts/Bachelorarbeit_Anhang/Simulationen/Eingangsfilter/Eingangsfilter.asc

C2: cap; 4.7u; V=50 Irms=0 Rser=0.00278837 Lser=260.341p mfg="Würth Elektronik" pn="885012209048 WCAP-CSGP 1210" type="X7R"
L2: ind; 2.2u; Ipk=7.5 Rser=0.0237 Rpar=3200 Cpar=15p mfg="Würth Elektronik" pn="74438367022 WE-MAPI 5030"
L3: FerriteBead; 288n; Ipk=7 Rser=0.0033 Rpar=152 Cpar=78f mfg="Würth Elektronik" pn="74279224101 WE-MPSB 2220"
L4: ind; 2.2u; Ipk=7.5 Rser=0.0237 Rpar=3200 Cpar=15p mfg="Würth Elektronik" pn="74438367022 WE-MAPI 5030"
R1: res; 1k
R2: res; 1k
U1: WCAP-ASLI
U2: WCAP-ASLI
V1: voltage; ""; AC 1 0
V2: voltage; ""; AC 1 0
Named nets: 0, LC, LC_Ferrit
.ac dec 100 1k 500Meg
