ArneAlberts/Bachelorarbeit_Anhang/Simulationen/einstellbarer_LDO/LM317_InlineSpiceDirective.asc

LM317: Ureg
R1: EuropeanResistor; 220
R2: res; 50
R3: res; 29k
R4: res; 10k
R5: res; 1000
U1: LTC6244
V1: voltage; 18
V2: voltage; 2.048
V3: voltage; 12
Named nets: 0, +24V
.dc V2 0 2.048 0.001
.lib LM317_adj.lib
