ArneAlberts/Bachelorarbeit_Anhang/Simulationen/Schutzschaltungen/OV_Reverse_Protection.asc

C2: cap; 1n
D1: zener; KDZ10B
D2: zener; KDZ10B
D3: schottky; MBR745
R1: res; 10
R1A: res; 47k
R1B: res; 30k
R2: res; 50k
R2A: res; 10k
R2B: res; 10k
R5: res; 50k
R6: res; 100k
U1: TL431
U2: BSS127
U5: Si3421DV
U6: Si3421DV
V1: voltage; PWL(0s 0V 200m 20V 400m 0V 500m -10V)
Named nets: 0, U_in, U_out, Ref_TL431, Kat_TL431
Simulation zum Testen des Verpolschutzes und des Unter/Überspannungsschutzes
.tran 0 500m 0 10u startup uic
Info:
Model vom TL431: https://www.ti.com/product/TL431
BSS127 aus Dev-Board-Doku vom TL431 (https://www.ti.com/lit/ug/tiduay1/tiduay1.pdf)
Modell vom BSS127 komt von der Infineon-Webseite (https://www.infineon.com/cms/de/product/power/mosfet/-250v-600v-small-signal-small-power-mosfet/bss127/)
 
Zener-Dioden reduzieren Ugs
Reverse Protection
Load
Over- and Undervoltage Protection
Verpolschutz funktioniert nicht mit Si3421DV, muss gebrückt werden.
Problem: Simulation bleibt bei einem Punkt stehen und rechnet sich tod.
Grund:Wahrscheinlich ist im Modell des Si3421 die Bulk-Diode nicht(korrekt) eingebaut
