ArneAlberts/Bachelorarbeit_Anhang/(list of files, drawings)

Other design files:
Datenblätter/Daten_Eval_ Boards/KSZ8041TL-FTL_v1.4_DP/Schematic/Eval Board/Board Revision 1.0/KSZ8041TL-FTL Eval Board Rev1.0 -- Schematic rev1.1.dsn
