ArneAlberts/Bachelorarbeit_Anhang/Schaltung_Layout/DA_Wandler.sch

## KiCad design Schaltung_Layout/DA_Wandler.sch (2021-09-20)

Schematic: DA_Wandler.sch

Parts:
C1501, C1502, C1503, C1504: 100n/0603/16V
C1505, C1506: 100n/0603/35V
C1507, C1508: C
C1509, C1510: 470n/0603/16V
NT1501, NT1502: Net-Tie_2
R1501, R1505: 30k/0603
R1502, R1504, R1506, R1508: 10k/0603
R1503, R1507: 70k/0603
R1509, R1510: R
U1501, U1502: LTC2627; DFN-12-1EP_3x4mm_P0.5mm_EP1.7x3.3mm
U1503, U1504: OPA2991
U1505, U1506: REF3220AMDBVREP; SOT-23-6

Notes on the sheet:
RC-Netzwerk um Ref-Spannung verzoegert einschzuschalten. Wir evtl. nicht benoetigt.
I2C-Adresse: 0x10
Vcc noch mit Ferrit-Bead filtern?
Ausgangsspannung: 0V - 8.192V Verstaerkung: 4
Ausgangsspannung: 0V - ?? V Verstaerkung: 8
Fragen: -DAC-Out mit C filtern?
I2C-Adresse: 0x11
DAC0
DAC1
