ArneAlberts/Bachelorarbeit_Anhang/Schaltung_Layout/DA_Wandler_0.sch

## KiCad design Schaltung_Layout/DA_Wandler_0.sch (2021-09-20)

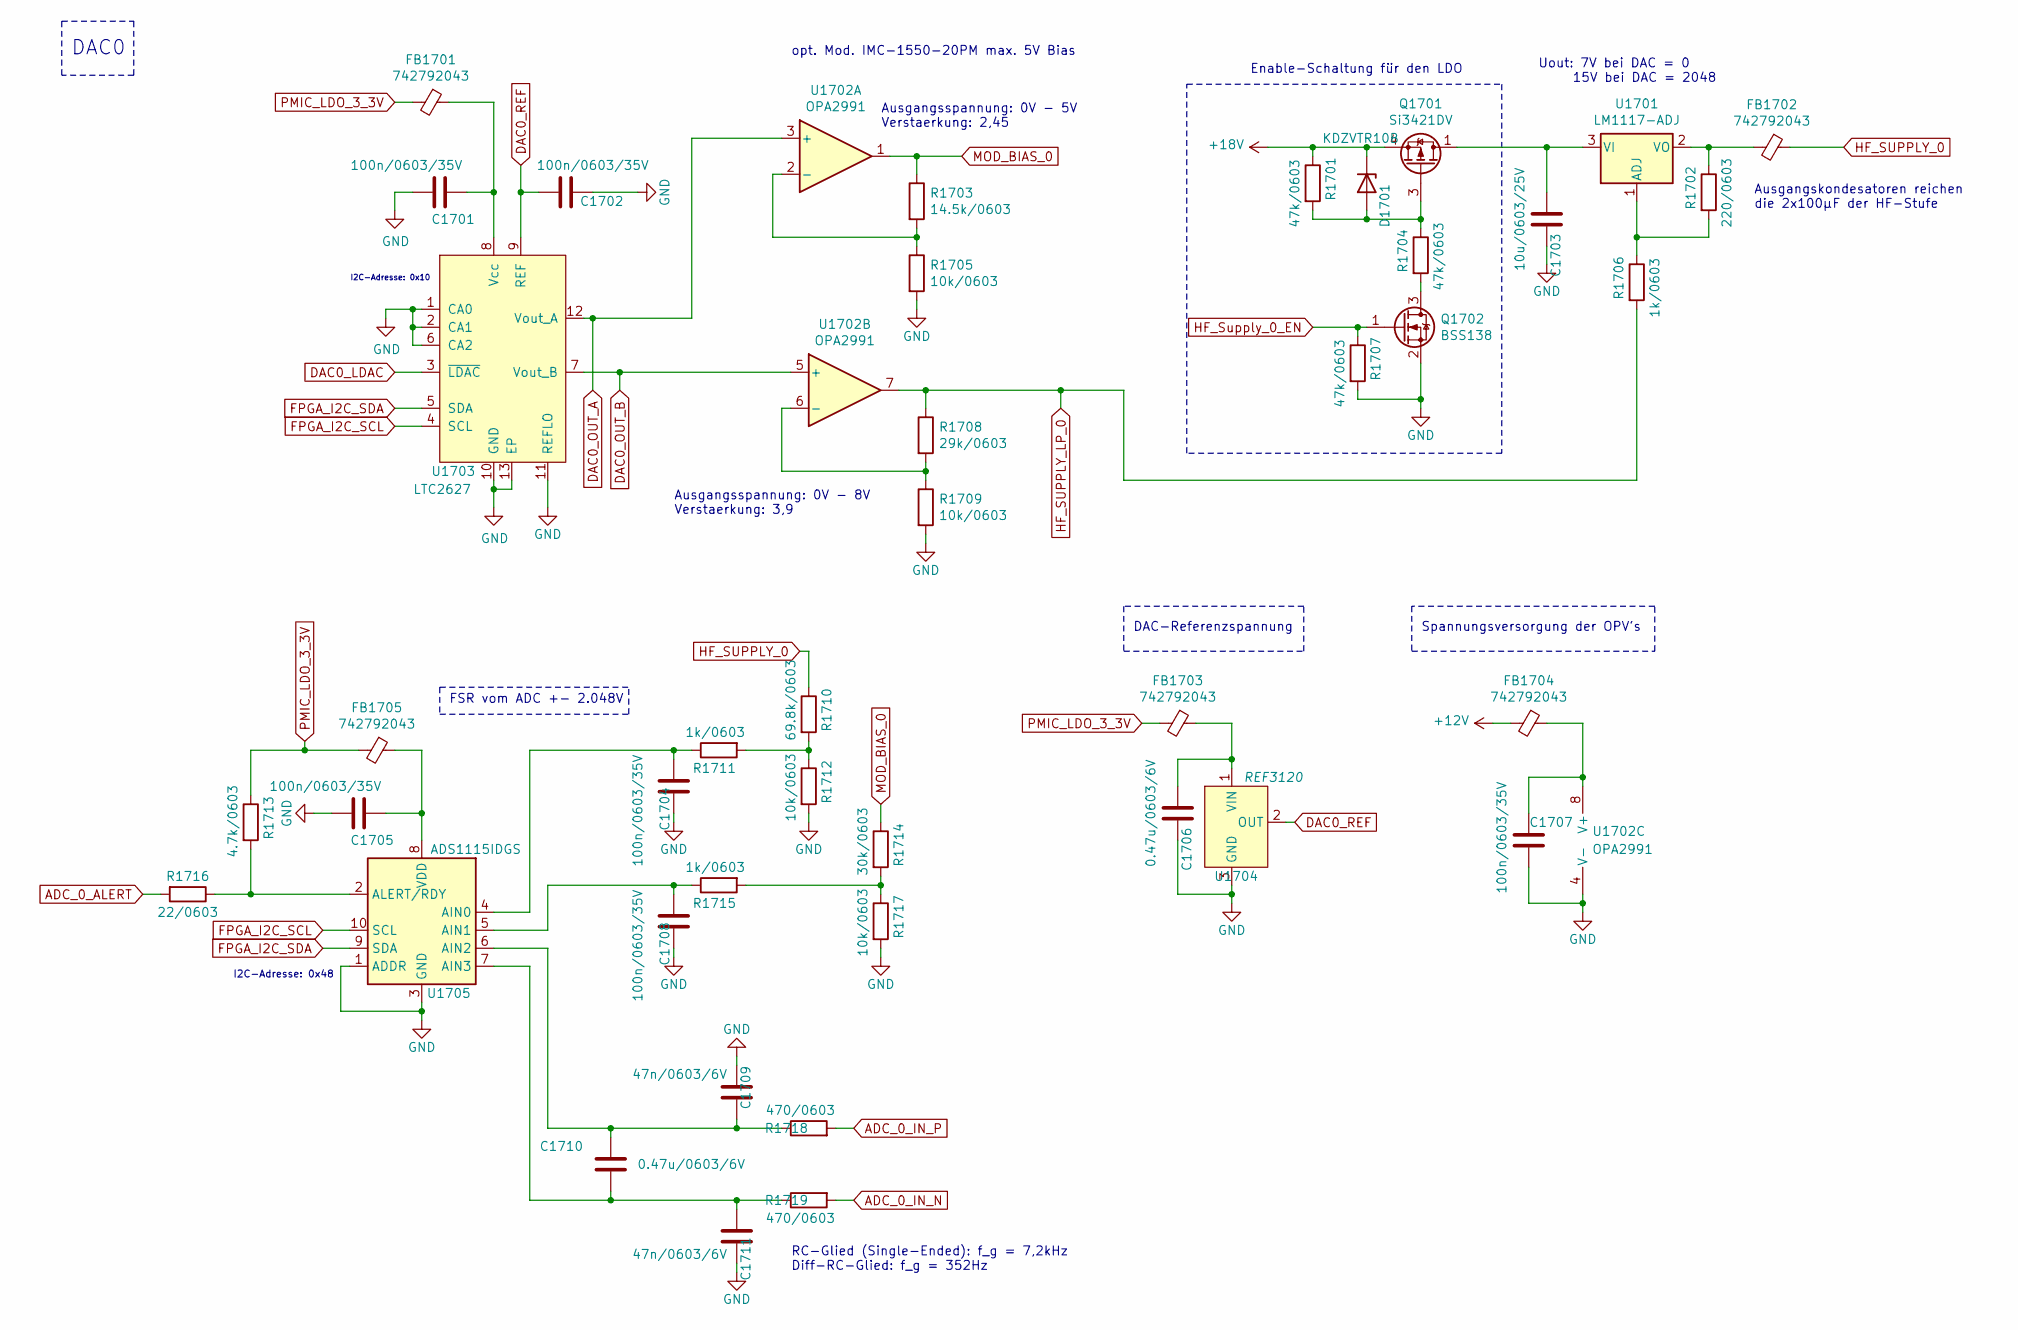
[picture p26: schematic DA_Wandler_0.sch]

Parts:
C1701, C1702, C1704, C1705, C1707, C1708: 100n/0603/35V; C_0603_1608Metric
C1703: 10u/0603/25V; C_0603_1608Metric
C1706, C1710: 0.47u/0603/6V; C_0603_1608Metric
C1709, C1711: 47n/0603/6V; C_0603_1608Metric
D1701: KDZVTR10B; D_SOD-123F
FB1701, FB1702, FB1703, FB1704, FB1705: 742792043; C_0805_2012Metric
Q1701: Si3421DV; TSOP-6_Si3421
Q1702: BSS138; SOT-23
R1701, R1704, R1707: 47k/0603; R_0603_1608Metric
R1702: 220/0603; R_0603_1608Metric
R1703: 14.5k/0603; R_0603_1608Metric
R1705, R1709, R1712, R1717: 10k/0603; R_0603_1608Metric
R1706, R1711, R1715: 1k/0603; R_0603_1608Metric
R1708: 29k/0603; R_0603_1608Metric
R1710: 69.8k/0603; R_0603_1608Metric
R1713: 4.7k/0603; R_0603_1608Metric
R1714: 30k/0603; R_0603_1608Metric
R1716: 22/0603; R_0603_1608Metric
R1718, R1719: 470/0603; R_0603_1608Metric
U1701: LM1117-ADJ; TO-220-3_Vertical
U1702: OPA2991; VSSOP-8_3.0x3.0mm_P0.65mm
U1703: LTC2627; DFN-12-1EP_3x4mm_P0.5mm_EP1.7x3.3mm
U1704: REF3120; SOT-23
U1705: ADS1115IDGS; TSSOP-10_3x3mm_P0.5mm

Connections:
+12V: FB1704.2
+18V: D1701.1 (K), Q1701.4 (S), R1701.1
ADC_0_ALERT: R1716.2
ADC_0_IN_N: R1719.2
ADC_0_IN_P: R1718.2
DAC0_LDAC: U1703.3 (~LDAC)
DAC0_OUT_A: U1702.3 (+), U1703.12 (Vout_A)
DAC0_OUT_B: U1702.5 (+), U1703.7 (Vout_B)
DAC0_REF: C1702.2, U1703.9 (REF), U1704.2 (OUT)
FPGA_I2C_SCL: U1703.4 (SCL), U1705.10 (SCL)
FPGA_I2C_SDA: U1703.5 (SDA), U1705.9 (SDA)
GND: C1701.1, C1702.1, C1703.2, C1704.1, C1705.1, C1706.2, C1707.2, C1708.1, C1709.1, C1711.1, Q1702.2 (S), R1705.2, R1707.2, R1709.2, R1712.2, R1717.2, U1702.4 (V-), U1703.1 (CA0), U1703.2 (CA1), U1703.6 (CA2), U1703.10 (GND), U1703.11 (REFLO), U1703.13 (EP), U1704.3 (GND), U1705.1 (ADDR), U1705.3 (GND)
HF_SUPPLY_0: FB1702.1, R1710.1
HF_SUPPLY_LP_0: R1706.2, R1708.1, U1702.7
HF_Supply_0_EN: Q1702.1 (G), R1707.1
MOD_BIAS_0: R1703.1, R1714.1, U1702.1
unnamed: C1701.2, FB1701.1, U1703.8 (Vcc)
unnamed: C1703.1, Q1701.1 (D), U1701.3 (VI)
unnamed: C1704.2, R1711.1, U1705.4 (AIN0)
unnamed: C1705.2, FB1705.1, U1705.8 (VDD)
unnamed: C1706.1, FB1703.1, U1704.1 (VIN)
unnamed: C1707.1, FB1704.1, U1702.8 (V+)
unnamed: C1708.2, R1715.1, U1705.5 (AIN1)
unnamed: C1709.2, C1710.1, R1718.1, U1705.6 (AIN2)
unnamed: C1710.2, C1711.2, R1719.1, U1705.7 (AIN3)
unnamed: D1701.2 (A), Q1701.3 (G), R1701.2, R1704.1
unnamed: FB1702.2, R1702.1, U1701.2 (VO)
unnamed: Q1702.3 (D), R1704.2
unnamed: R1702.2, R1706.1, U1701.1 (ADJ)
unnamed: R1703.2, R1705.1, U1702.2 (-)
unnamed: R1708.2, R1709.1, U1702.6 (-)
unnamed: R1710.2, R1711.2, R1712.1
unnamed: R1713.2, R1716.1, U1705.2 (ALERT/RDY)
unnamed: R1714.2, R1715.2, R1717.1
PMIC_LDO_3_3V: FB1701.2, FB1703.2, FB1705.2, R1713.1

Notes on the sheet:
Ausgangsspannung: 0V - 8V Verstaerkung: 3,9
Enable-Schaltung für den LDO
Spannungsversorgung der OPV's
DAC0
Ausgangsspannung: 0V - 5V Verstaerkung: 2,45
I2C-Adresse: 0x10
DAC-Referenzspannung
I2C-Adresse: 0x48
FSR vom ADC +- 2.048V
RC-Glied (Single-Ended): f_g = 7,2kHz Diff-RC-Glied: f_g = 352Hz
Ausgangskondesatoren reichen die 2x100µF der HF-Stufe
opt. Mod. IMC-1550-20PM max. 5V Bias
Uout: 7V bei DAC = 0 15V bei DAC = 2048
