ArneAlberts/Bachelorarbeit_Anhang/Schaltung_Layout/DA_Wandler_1.sch

## KiCad design Schaltung_Layout/DA_Wandler_1.sch (2021-09-20)

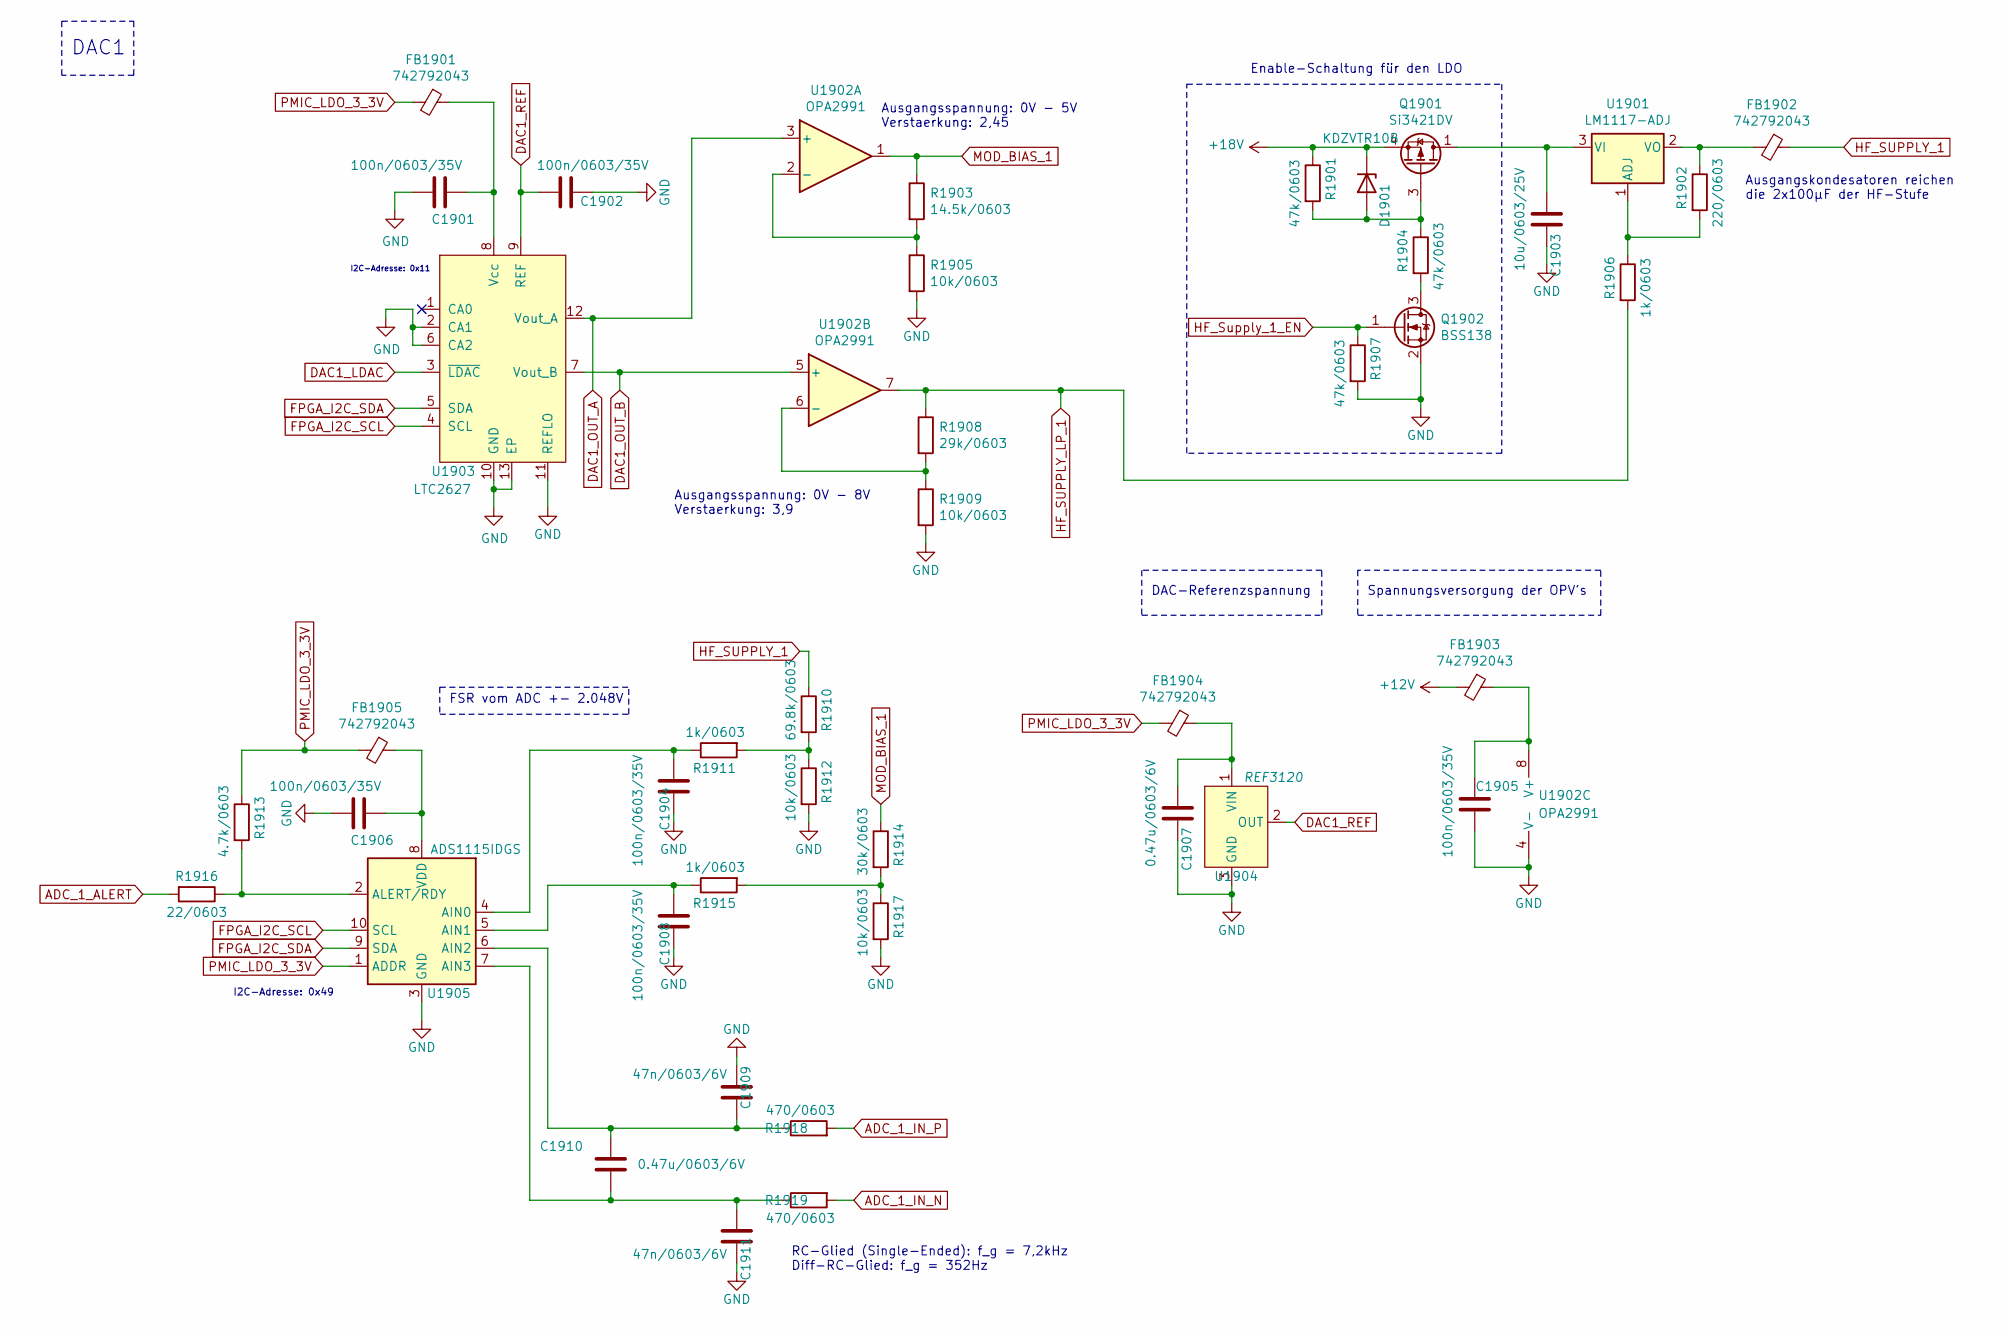
[picture p27: schematic DA_Wandler_1.sch]

Parts:
C1901, C1902, C1904, C1905, C1906, C1908: 100n/0603/35V; C_0603_1608Metric
C1903: 10u/0603/25V; C_0603_1608Metric
C1907, C1910: 0.47u/0603/6V; C_0603_1608Metric
C1909, C1911: 47n/0603/6V; C_0603_1608Metric
D1901: KDZVTR10B; D_SOD-123F
FB1901, FB1902, FB1903, FB1904, FB1905: 742792043; C_0805_2012Metric
Q1901: Si3421DV; TSOP-6_Si3421
Q1902: BSS138; SOT-23
R1901, R1904, R1907: 47k/0603; R_0603_1608Metric
R1902: 220/0603; R_0603_1608Metric
R1903: 14.5k/0603; R_0603_1608Metric
R1905, R1909, R1912, R1917: 10k/0603; R_0603_1608Metric
R1906, R1911, R1915: 1k/0603; R_0603_1608Metric
R1908: 29k/0603; R_0603_1608Metric
R1910: 69.8k/0603; R_0603_1608Metric
R1913: 4.7k/0603; R_0603_1608Metric
R1914: 30k/0603; R_0603_1608Metric
R1916: 22/0603; R_0603_1608Metric
R1918, R1919: 470/0603; R_0603_1608Metric
U1901: LM1117-ADJ; TO-220-3_Vertical
U1902: OPA2991; VSSOP-8_3.0x3.0mm_P0.65mm
U1903: LTC2627; DFN-12-1EP_3x4mm_P0.5mm_EP1.7x3.3mm
U1904: REF3120; SOT-23
U1905: ADS1115IDGS; TSSOP-10_3x3mm_P0.5mm

Connections:
+12V: FB1903.2
+18V: D1901.1 (K), Q1901.4 (S), R1901.1
ADC_1_ALERT: R1916.2
ADC_1_IN_N: R1919.2
ADC_1_IN_P: R1918.2
DAC1_LDAC: U1903.3 (~LDAC)
DAC1_OUT_A: U1902.3 (+), U1903.12 (Vout_A)
DAC1_OUT_B: U1902.5 (+), U1903.7 (Vout_B)
DAC1_REF: C1902.2, U1903.9 (REF), U1904.2 (OUT)
FPGA_I2C_SCL: U1903.4 (SCL), U1905.10 (SCL)
FPGA_I2C_SDA: U1903.5 (SDA), U1905.9 (SDA)
GND: C1901.1, C1902.1, C1903.2, C1904.1, C1905.2, C1906.1, C1907.2, C1908.1, C1909.1, C1911.1, Q1902.2 (S), R1905.2, R1907.2, R1909.2, R1912.2, R1917.2, U1902.4 (V-), U1903.2 (CA1), U1903.6 (CA2), U1903.10 (GND), U1903.11 (REFLO), U1903.13 (EP), U1904.3 (GND), U1905.3 (GND)
HF_SUPPLY_1: FB1902.1, R1910.1
HF_SUPPLY_LP_1: R1906.2, R1908.1, U1902.7
HF_Supply_1_EN: Q1902.1 (G), R1907.1
MOD_BIAS_1: R1903.1, R1914.1, U1902.1
unnamed: C1901.2, FB1901.1, U1903.8 (Vcc)
unnamed: C1903.1, Q1901.1 (D), U1901.3 (VI)
unnamed: C1904.2, R1911.1, U1905.4 (AIN0)
unnamed: C1905.1, FB1903.1, U1902.8 (V+)
unnamed: C1906.2, FB1905.1, U1905.8 (VDD)
unnamed: C1907.1, FB1904.1, U1904.1 (VIN)
unnamed: C1908.2, R1915.1, U1905.5 (AIN1)
unnamed: C1909.2, C1910.1, R1918.1, U1905.6 (AIN2)
unnamed: C1910.2, C1911.2, R1919.1, U1905.7 (AIN3)
unnamed: D1901.2 (A), Q1901.3 (G), R1901.2, R1904.1
unnamed: FB1902.2, R1902.1, U1901.2 (VO)
unnamed: Q1902.3 (D), R1904.2
unnamed: R1902.2, R1906.1, U1901.1 (ADJ)
unnamed: R1903.2, R1905.1, U1902.2 (-)
unnamed: R1908.2, R1909.1, U1902.6 (-)
unnamed: R1910.2, R1911.2, R1912.1
unnamed: R1913.2, R1916.1, U1905.2 (ALERT/RDY)
unnamed: R1914.2, R1915.2, R1917.1
PMIC_LDO_3_3V: FB1901.2, FB1904.2, FB1905.2, R1913.1, U1905.1 (ADDR)

Notes on the sheet:
Ausgangsspannung: 0V - 8V Verstaerkung: 3,9
Enable-Schaltung für den LDO
DAC-Referenzspannung
Spannungsversorgung der OPV's
DAC1
Ausgangsspannung: 0V - 5V Verstaerkung: 2,45
I2C-Adresse: 0x11
I2C-Adresse: 0x49
FSR vom ADC +- 2.048V
RC-Glied (Single-Ended): f_g = 7,2kHz Diff-RC-Glied: f_g = 352Hz
Ausgangskondesatoren reichen die 2x100µF der HF-Stufe
