ArneAlberts/Bachelorarbeit_Anhang/Schaltung_Layout/DDR3_RAM.sch

## KiCad design Schaltung_Layout/DDR3_RAM.sch (2021-09-20)

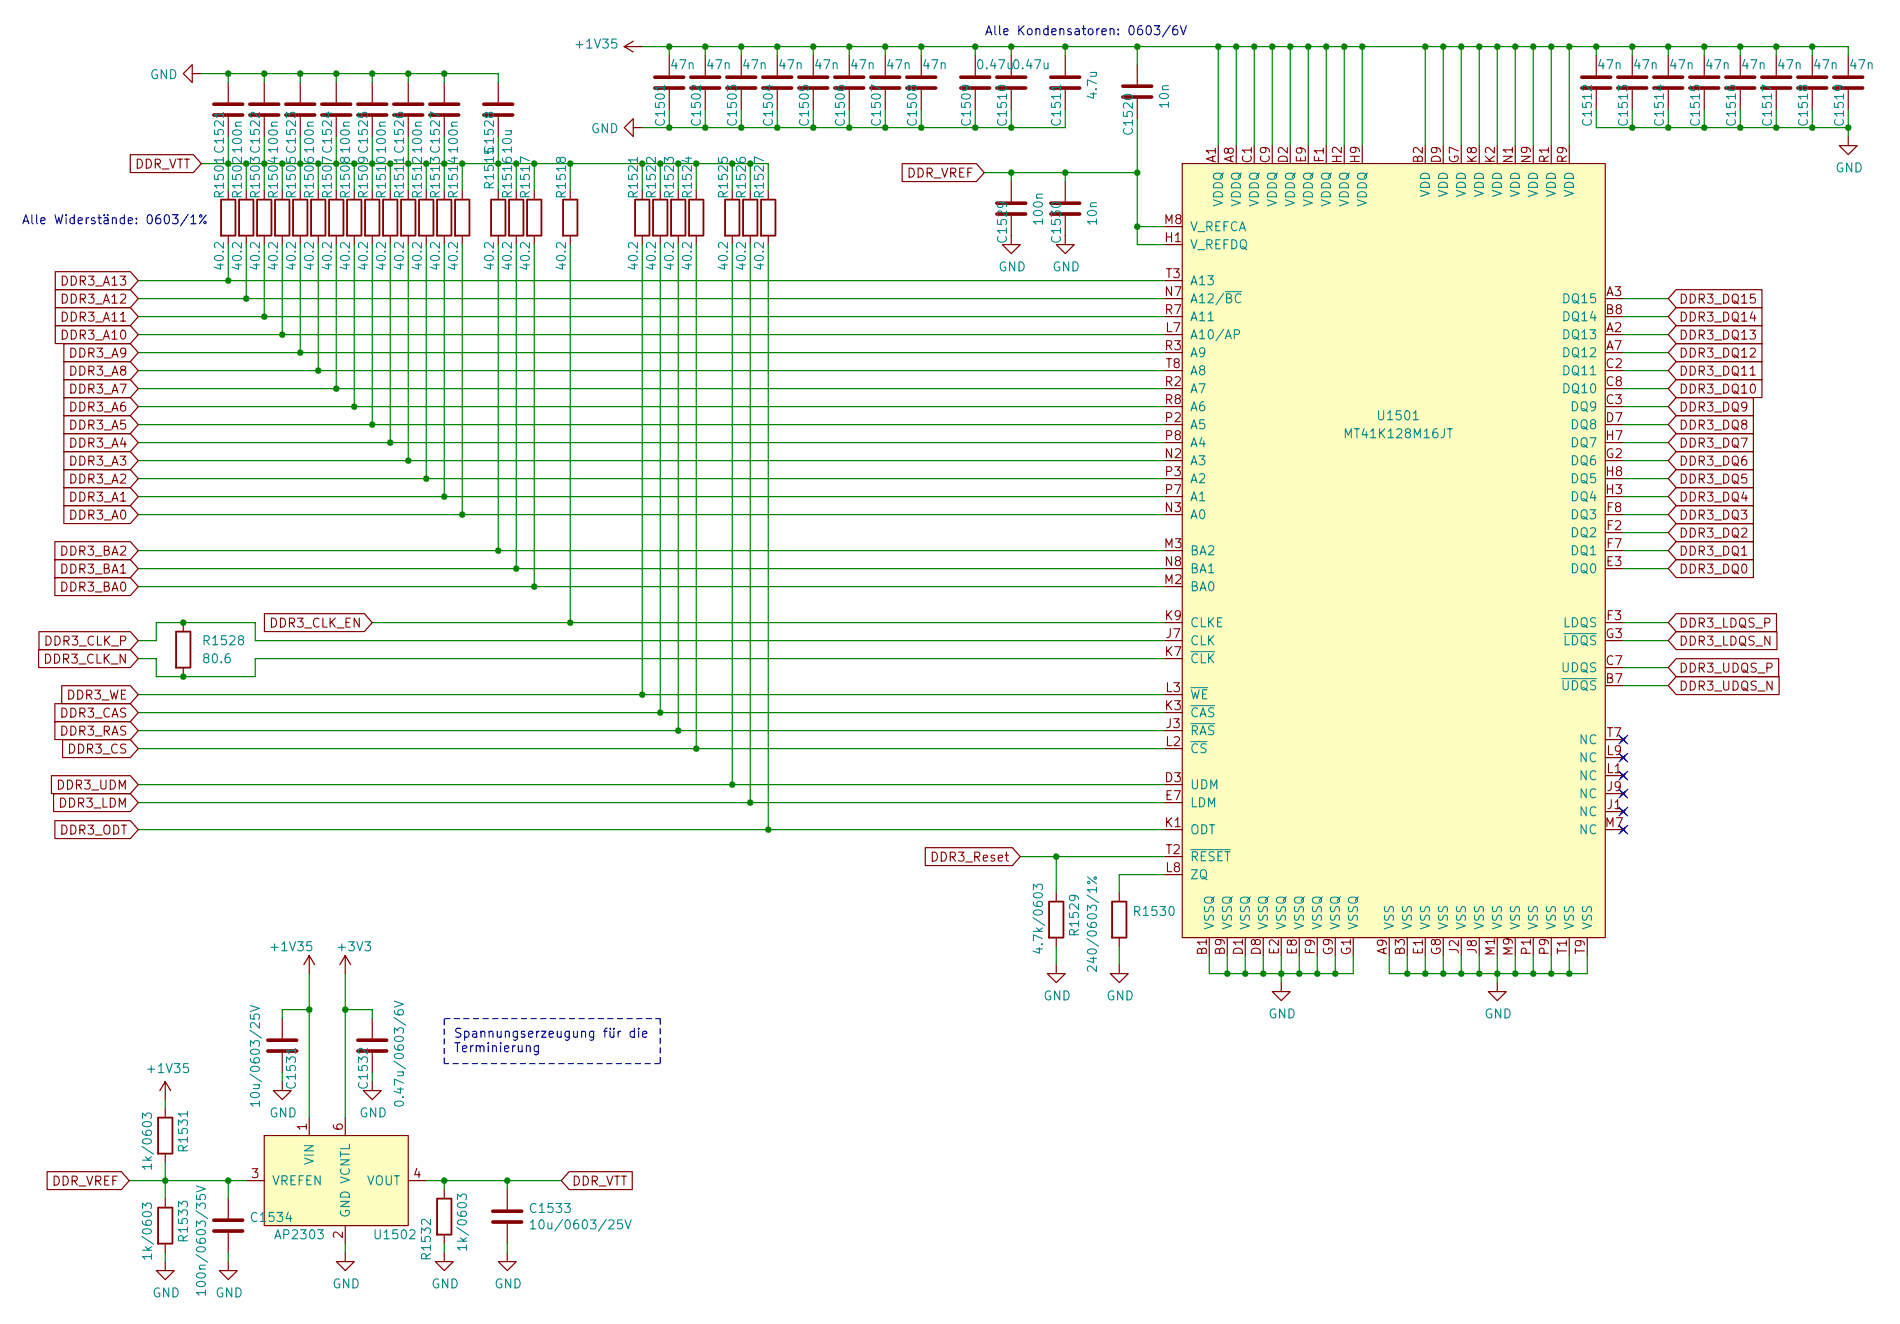
[picture p28: schematic DDR3_RAM.sch]

Parts:
C1501, C1502, C1503, C1504, C1505, C1506, C1507, C1508, C1512, C1513, C1514, C1515, C1516, C1517, C1518, C1519: 47n; C_0603_1608Metric
C1509, C1510: 0.47u; C_0603_1608Metric
C1511: 4.7u; C_0603_1608Metric
C1520, C1530: 10n; C_0603_1608Metric
C1521, C1522, C1523, C1524, C1525, C1526, C1527, C1529: 100n; C_0603_1608Metric
C1528: 10u; C_0603_1608Metric
C1531, C1533: 10u/0603/25V; C_0603_1608Metric
C1532: 0.47u/0603/6V; C_0603_1608Metric
C1534: 100n/0603/35V; C_0603_1608Metric
R1501, R1502, R1503, R1504, R1505, R1506, R1507, R1508, R1509, R1510, R1511, R1512, R1513, R1514, R1515, R1516, R1517, R1518, R1521, R1522, R1523, R1524, R1525, R1526, R1527: 40.2; R_0603_1608Metric
R1528: 80.6; R_0603_1608Metric
R1529: 4.7k/0603; R_0603_1608Metric
R1530: 240/0603/1%; R_0603_1608Metric
R1531, R1532, R1533: 1k/0603; R_0603_1608Metric
U1501: MT41K128M16JT; BGA-96_8.0x14.0mm_Layout2x3x16_P0.8mm
U1502: AP2303; SOIC-8_3.9x4.9mm_P1.27mm

Connections:
+1V35: C1501.1, C1502.1, C1503.1, C1504.1, C1505.1, C1506.1, C1507.1, C1508.1, C1509.1, C1510.1, C1511.1, C1512.1, C1513.1, C1514.1, C1515.1, C1516.1, C1517.1, C1518.1, C1519.1, C1520.1, C1531.1, R1531.1, U1501.A1 (VDDQ), U1501.A8 (VDDQ), U1501.B2 (VDD), U1501.C1 (VDDQ), U1501.C9 (VDDQ), U1501.D2 (VDDQ), U1501.D9 (VDD), U1501.E9 (VDDQ), U1501.F1 (VDDQ), U1501.G7 (VDD), U1501.H2 (VDDQ), U1501.H9 (VDDQ), U1501.K2 (VDD), U1501.K8 (VDD), U1501.N1 (VDD), U1501.N9 (VDD), U1501.R1 (VDD), U1501.R9 (VDD), U1502.1 (VIN)
+3V3: C1532.1, U1502.6 (VCNTL)
DDR3_A0: R1514.2, U1501.N3 (A0)
DDR3_A1: R1513.2, U1501.P7 (A1)
DDR3_A2: R1512.2, U1501.P3 (A2)
DDR3_A3: R1511.2, U1501.N2 (A3)
DDR3_A4: R1510.2, U1501.P8 (A4)
DDR3_A5: R1509.2, U1501.P2 (A5)
DDR3_A6: R1508.2, U1501.R8 (A6)
DDR3_A7: R1507.2, U1501.R2 (A7)
DDR3_A8: R1506.2, U1501.T8 (A8)
DDR3_A9: R1505.2, U1501.R3 (A9)
DDR3_A10: R1504.2, U1501.L7 (A10/AP)
DDR3_A11: R1503.2, U1501.R7 (A11)
DDR3_A12: R1502.2, U1501.N7 (A12/~BC)
DDR3_A13: R1501.2, U1501.T3 (A13)
DDR3_BA0: R1517.2, U1501.M2 (BA0)
DDR3_BA1: R1516.2, U1501.N8 (BA1)
DDR3_BA2: R1515.2, U1501.M3 (BA2)
DDR3_CAS: R1522.2, U1501.K3 (~CAS)
DDR3_CLK_EN: R1518.2, U1501.K9 (CLKE)
DDR3_CLK_N: R1528.2, U1501.K7 (~CLK)
DDR3_CLK_P: R1528.1, U1501.J7 (CLK)
DDR3_CS: R1524.2, U1501.L2 (~CS)
DDR3_DQ0: U1501.E3 (DQ0)
DDR3_DQ1: U1501.F7 (DQ1)
DDR3_DQ2: U1501.F2 (DQ2)
DDR3_DQ3: U1501.F8 (DQ3)
DDR3_DQ4: U1501.H3 (DQ4)
DDR3_DQ5: U1501.H8 (DQ5)
DDR3_DQ6: U1501.G2 (DQ6)
DDR3_DQ7: U1501.H7 (DQ7)
DDR3_DQ8: U1501.D7 (DQ8)
DDR3_DQ9: U1501.C3 (DQ9)
DDR3_DQ10: U1501.C8 (DQ10)
DDR3_DQ11: U1501.C2 (DQ11)
DDR3_DQ12: U1501.A7 (DQ12)
DDR3_DQ13: U1501.A2 (DQ13)
DDR3_DQ14: U1501.B8 (DQ14)
DDR3_DQ15: U1501.A3 (DQ15)
DDR3_LDM: R1526.2, U1501.E7 (LDM)
DDR3_LDQS_N: U1501.G3 (~LDQS)
DDR3_LDQS_P: U1501.F3 (LDQS)
DDR3_ODT: R1527.2, U1501.K1 (ODT)
DDR3_RAS: R1523.2, U1501.J3 (~RAS)
DDR3_Reset: R1529.1, U1501.T2 (~RESET)
DDR3_UDM: R1525.2, U1501.D3 (UDM)
DDR3_UDQS_N: U1501.B7 (~UDQS)
DDR3_UDQS_P: U1501.C7 (UDQS)
DDR3_WE: R1521.2, U1501.L3 (~WE)
DDR_VREF: C1520.2, C1529.1, C1530.1, C1534.1, R1531.2, R1533.1, U1501.H1 (V_REFDQ), U1501.M8 (V_REFCA), U1502.3 (VREFEN)
DDR_VTT: C1521.2, C1522.2, C1523.2, C1524.2, C1525.2, C1526.2, C1527.2, C1528.2, C1533.1, R1501.1, R1502.1, R1503.1, R1504.1, R1505.1, R1506.1, R1507.1, R1508.1, R1509.1, R1510.1, R1511.1, R1512.1, R1513.1, R1514.1, R1515.1, R1516.1, R1517.1, R1518.1, R1521.1, R1522.1, R1523.1, R1524.1, R1525.1, R1526.1, R1527.1, R1532.1, U1502.4 (VOUT)
GND: C1501.2, C1502.2, C1503.2, C1504.2, C1505.2, C1506.2, C1507.2, C1508.2, C1509.2, C1510.2, C1511.2, C1512.2, C1513.2, C1514.2, C1515.2, C1516.2, C1517.2, C1518.2, C1519.2, C1521.1, C1522.1, C1523.1, C1524.1, C1525.1, C1526.1, C1527.1, C1528.1, C1529.2, C1530.2, C1531.2, C1532.2, C1533.2, C1534.2, R1529.2, R1530.2, R1532.2, R1533.2, U1501.A9 (VSS), U1501.B1 (VSSQ), U1501.B3 (VSS), U1501.B9 (VSSQ), U1501.D1 (VSSQ), U1501.D8 (VSSQ), U1501.E1 (VSS), U1501.E2 (VSSQ), U1501.E8 (VSSQ), U1501.F9 (VSSQ), U1501.G1 (VSSQ), U1501.G8 (VSS), U1501.G9 (VSSQ), U1501.J2 (VSS), U1501.J8 (VSS), U1501.M1 (VSS), U1501.M9 (VSS), U1501.P1 (VSS), U1501.P9 (VSS), U1501.T1 (VSS), U1501.T9 (VSS), U1502.2 (GND)
unnamed: R1530.1, U1501.L8 (ZQ)

Notes on the sheet:
Spannungserzeugung für die Terminierung
Alle Kondensatoren: 0603/6V
Alle Widerstände: 0603/1%
