ArneAlberts/Bachelorarbeit_Anhang/Schaltung_Layout/FPGA_AUX_GND.sch

## KiCad design Schaltung_Layout/FPGA_AUX_GND.sch (2021-09-20)

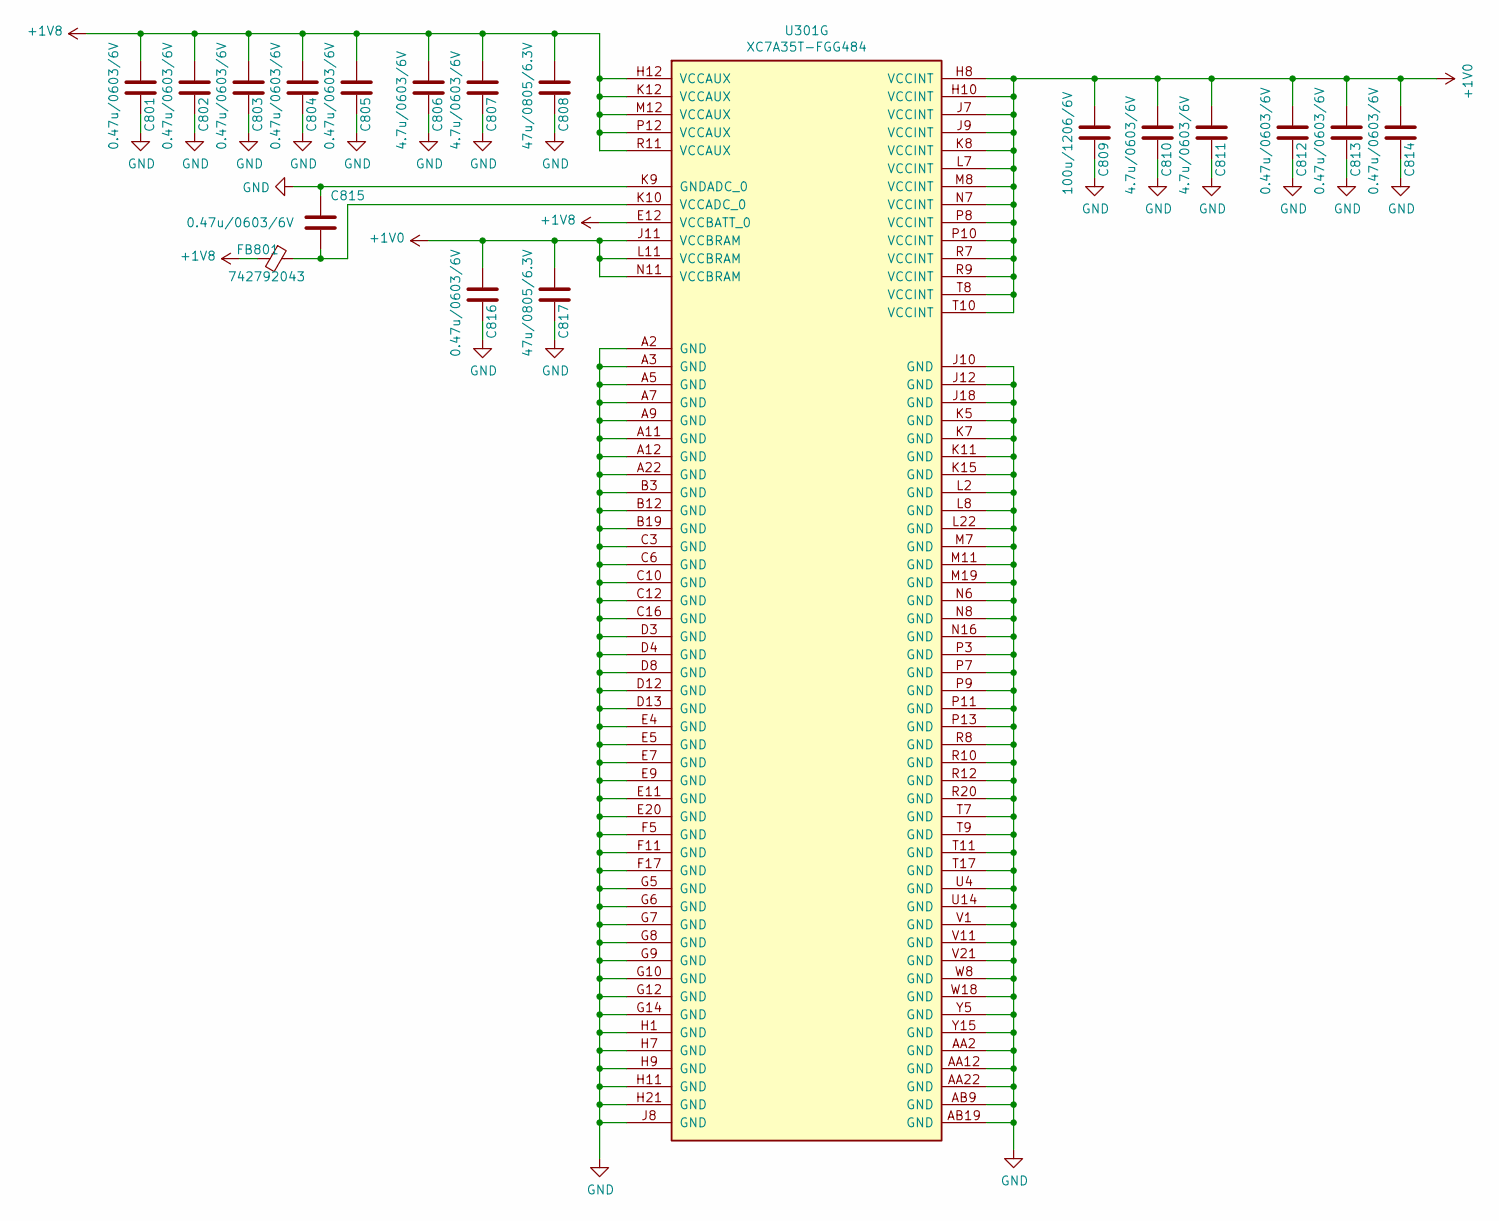
[picture p29: schematic FPGA_AUX_GND.sch]

Parts:
C801, C802, C803, C804, C805, C812, C813, C814, C815, C816: 0.47u/0603/6V; C_0603_1608Metric
C806, C807, C810, C811: 4.7u/0603/6V; C_0603_1608Metric
C808, C817: 47u/0805/6.3V; C_0805_2012Metric
C809: 100u/1206/6V; C_1206_3216Metric
FB801: 742792043; C_0805_2012Metric
U301: XC7A35T-FGG484; Xilinx_FGG484

Connections:
+1V0: C809.1, C810.1, C811.1, C812.1, C813.1, C814.1, C816.1, C817.1, U301.H8 (VCCINT), U301.H10 (VCCINT), U301.J7 (VCCINT), U301.J9 (VCCINT), U301.J11 (VCCBRAM), U301.K8 (VCCINT), U301.L7 (VCCINT), U301.L11 (VCCBRAM), U301.M8 (VCCINT), U301.N7 (VCCINT), U301.N11 (VCCBRAM), U301.P8 (VCCINT), U301.P10 (VCCINT), U301.R7 (VCCINT), U301.R9 (VCCINT), U301.T8 (VCCINT), U301.T10 (VCCINT)
+1V8: C801.1, C802.1, C803.1, C804.1, C805.1, C806.1, C807.1, C808.1, FB801.2, U301.E12 (VCCBATT_0), U301.H12 (VCCAUX), U301.K12 (VCCAUX), U301.M12 (VCCAUX), U301.P12 (VCCAUX), U301.R11 (VCCAUX)
GND: C801.2, C802.2, C803.2, C804.2, C805.2, C806.2, C807.2, C808.2, C809.2, C810.2, C811.2, C812.2, C813.2, C814.2, C815.1, C816.2, C817.2, U301.A2 (GND), U301.A3 (GND), U301.A5 (GND), U301.A7 (GND), U301.A9 (GND), U301.A11 (GND), U301.A12 (GND), U301.A22 (GND), U301.AA2 (GND), U301.AA12 (GND), U301.AA22 (GND), U301.AB9 (GND), U301.AB19 (GND), U301.B3 (GND), U301.B12 (GND), U301.B19 (GND), U301.C3 (GND), U301.C6 (GND), U301.C10 (GND), U301.C12 (GND), U301.C16 (GND), U301.D3 (GND), U301.D4 (GND), U301.D8 (GND), U301.D12 (GND), U301.D13 (GND), U301.E4 (GND), U301.E5 (GND), U301.E7 (GND), U301.E9 (GND), U301.E11 (GND), U301.E20 (GND), U301.F5 (GND), U301.F11 (GND), U301.F17 (GND), U301.G5 (GND), U301.G6 (GND), U301.G7 (GND), U301.G8 (GND), U301.G9 (GND), U301.G10 (GND), U301.G12 (GND), U301.G14 (GND), U301.H1 (GND), U301.H7 (GND), U301.H9 (GND), U301.H11 (GND), U301.H21 (GND), U301.J8 (GND), U301.J10 (GND), U301.J12 (GND), U301.J18 (GND), U301.K5 (GND), U301.K7 (GND), U301.K9 (GNDADC_0), U301.K11 (GND), U301.K15 (GND), U301.L2 (GND), U301.L8 (GND), U301.L22 (GND), U301.M7 (GND), U301.M11 (GND), U301.M19 (GND), U301.N6 (GND), U301.N8 (GND), U301.N16 (GND), U301.P3 (GND), U301.P7 (GND), U301.P9 (GND), U301.P11 (GND), U301.P13 (GND), U301.R8 (GND), U301.R10 (GND), U301.R12 (GND), U301.R20 (GND), U301.T7 (GND), U301.T9 (GND), U301.T11 (GND), U301.T17 (GND), U301.U4 (GND), U301.U14 (GND), U301.V1 (GND), U301.V11 (GND), U301.V21 (GND), U301.W8 (GND), U301.W18 (GND), U301.Y5 (GND), U301.Y15 (GND)
unnamed: C815.2, FB801.1, U301.K10 (VCCADC_0)
