ArneAlberts/Bachelorarbeit_Anhang/Schaltung_Layout/FPGA_D.sch

## KiCad design Schaltung_Layout/FPGA_D.sch (2021-09-20)

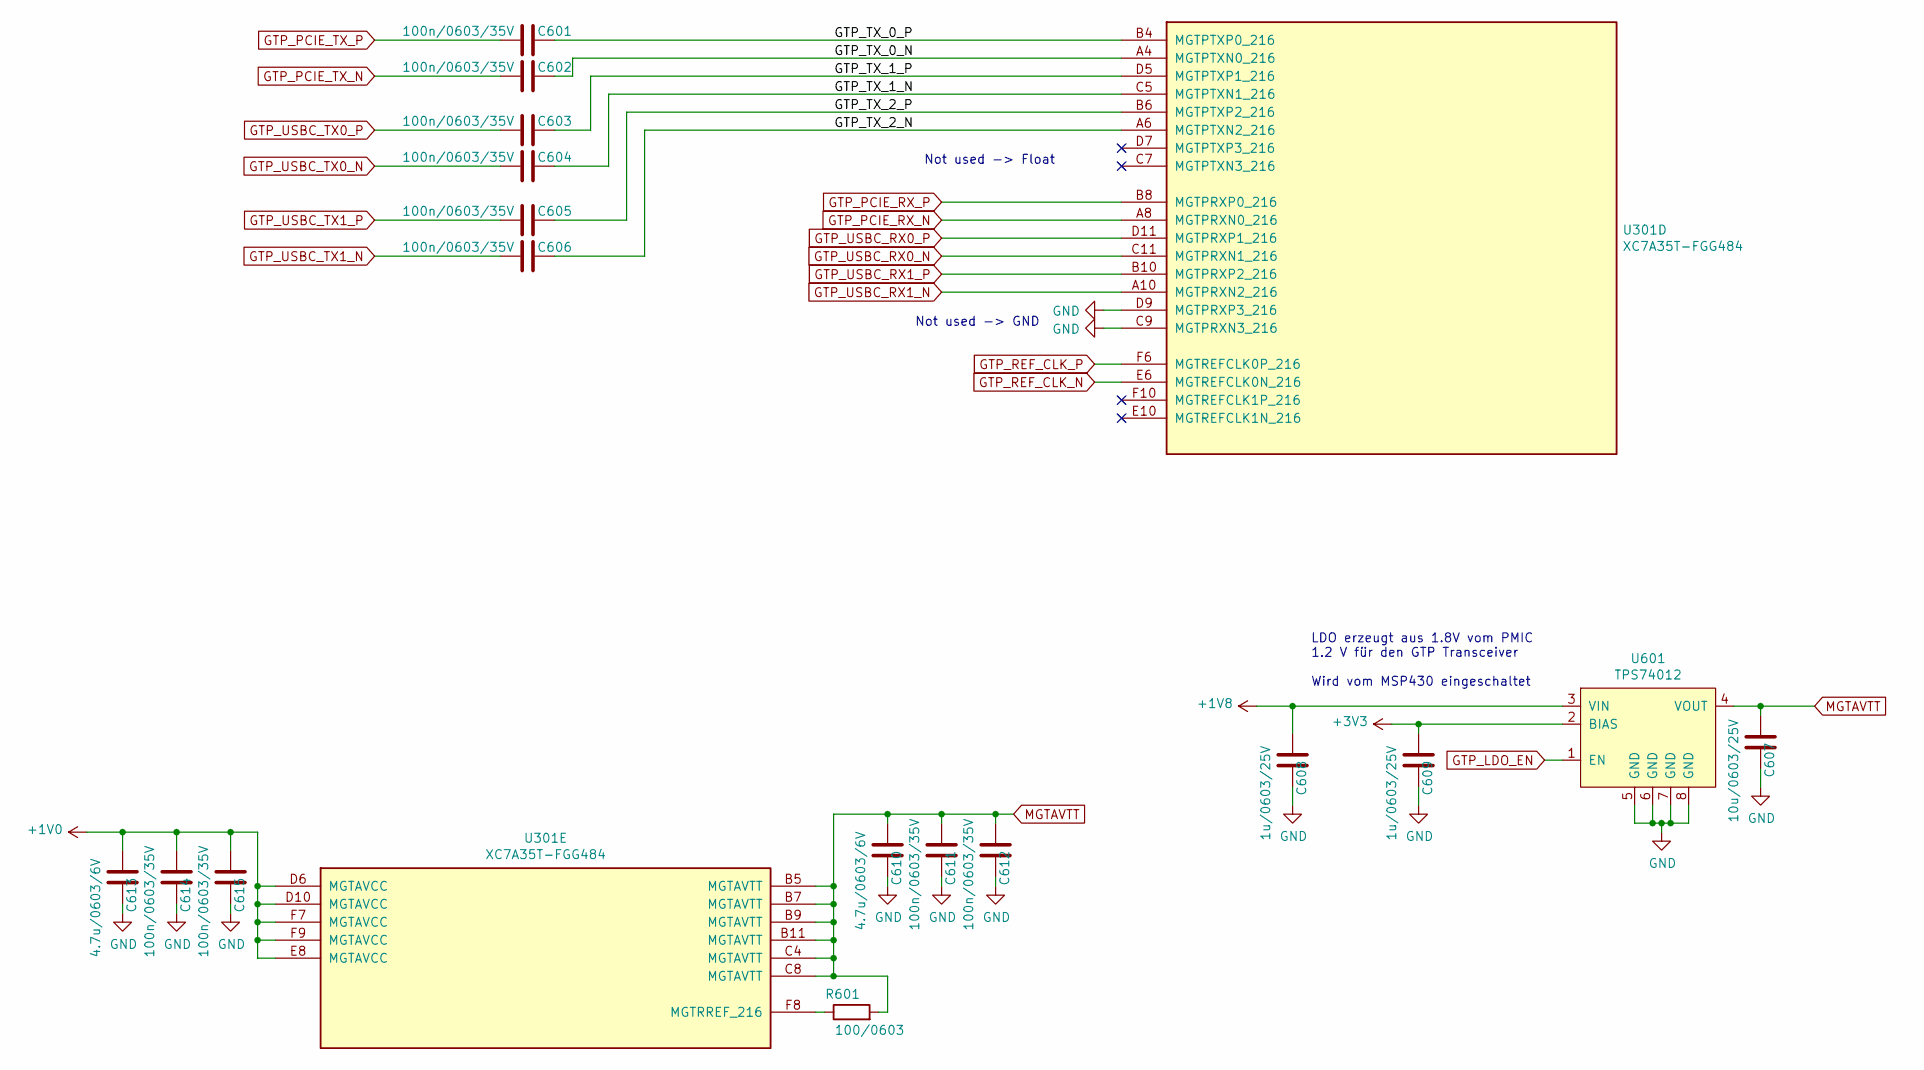
[picture p30: schematic FPGA_D.sch]

Parts:
C601, C602, C603, C604, C605, C606, C611, C612, C614, C615: 100n/0603/35V; C_0603_1608Metric
C607: 10u/0603/25V; C_0603_1608Metric
C608, C609: 1u/0603/25V; C_0603_1608Metric
C610, C613: 4.7u/0603/6V; C_0603_1608Metric
R601: 100/0603; R_0603_1608Metric
U301: XC7A35T-FGG484; Xilinx_FGG484
U601: TPS74012; MSOP-8_3x3mm_P0.65mm

Connections:
+1V0: C613.1, C614.1, C615.1, U301.D6 (MGTAVCC), U301.D10 (MGTAVCC), U301.E8 (MGTAVCC), U301.F7 (MGTAVCC), U301.F9 (MGTAVCC)
+1V8: C608.1, U601.3 (VIN)
+3V3: C609.1, U601.2 (BIAS)
GND: C607.2, C608.2, C609.2, C610.2, C611.2, C612.2, C613.2, C614.2, C615.2, U301.C9 (MGTPRXN3_216), U301.D9 (MGTPRXP3_216), U601.5 (GND), U601.6 (GND), U601.7 (GND), U601.8 (GND)
GTP_LDO_EN: U601.1 (EN)
GTP_PCIE_RX_N: U301.A8 (MGTPRXN0_216)
GTP_PCIE_RX_P: U301.B8 (MGTPRXP0_216)
GTP_PCIE_TX_N: C602.2
GTP_PCIE_TX_P: C601.2
GTP_REF_CLK_N: U301.E6 (MGTREFCLK0N_216)
GTP_REF_CLK_P: U301.F6 (MGTREFCLK0P_216)
GTP_TX_0_N: C602.1, U301.A4 (MGTPTXN0_216)
GTP_TX_0_P: C601.1, U301.B4 (MGTPTXP0_216)
GTP_TX_1_N: C604.1, U301.C5 (MGTPTXN1_216)
GTP_TX_1_P: C603.1, U301.D5 (MGTPTXP1_216)
GTP_TX_2_N: C606.1, U301.A6 (MGTPTXN2_216)
GTP_TX_2_P: C605.1, U301.B6 (MGTPTXP2_216)
GTP_USBC_RX0_N: U301.C11 (MGTPRXN1_216)
GTP_USBC_RX0_P: U301.D11 (MGTPRXP1_216)
GTP_USBC_RX1_N: U301.A10 (MGTPRXN2_216)
GTP_USBC_RX1_P: U301.B10 (MGTPRXP2_216)
GTP_USBC_TX0_N: C604.2
GTP_USBC_TX0_P: C603.2
GTP_USBC_TX1_N: C606.2
GTP_USBC_TX1_P: C605.2
MGTAVTT: C607.1, C610.1, C611.1, C612.1, R601.2, U301.B5 (MGTAVTT), U301.B7 (MGTAVTT), U301.B9 (MGTAVTT), U301.B11 (MGTAVTT), U301.C4 (MGTAVTT), U301.C8 (MGTAVTT), U601.4 (VOUT)
unnamed: R601.1, U301.F8 (MGTRREF_216)

Notes on the sheet:
LDO erzeugt aus 1.8V vom PMIC 1.2 V für den GTP Transceiver Wird vom MSP430 eingeschaltet
Not used -> GND
Not used -> Float
