ArneAlberts/Bachelorarbeit_Anhang/Schaltung_Layout/FPGA_F.sch

## KiCad design Schaltung_Layout/FPGA_F.sch (2021-09-20)

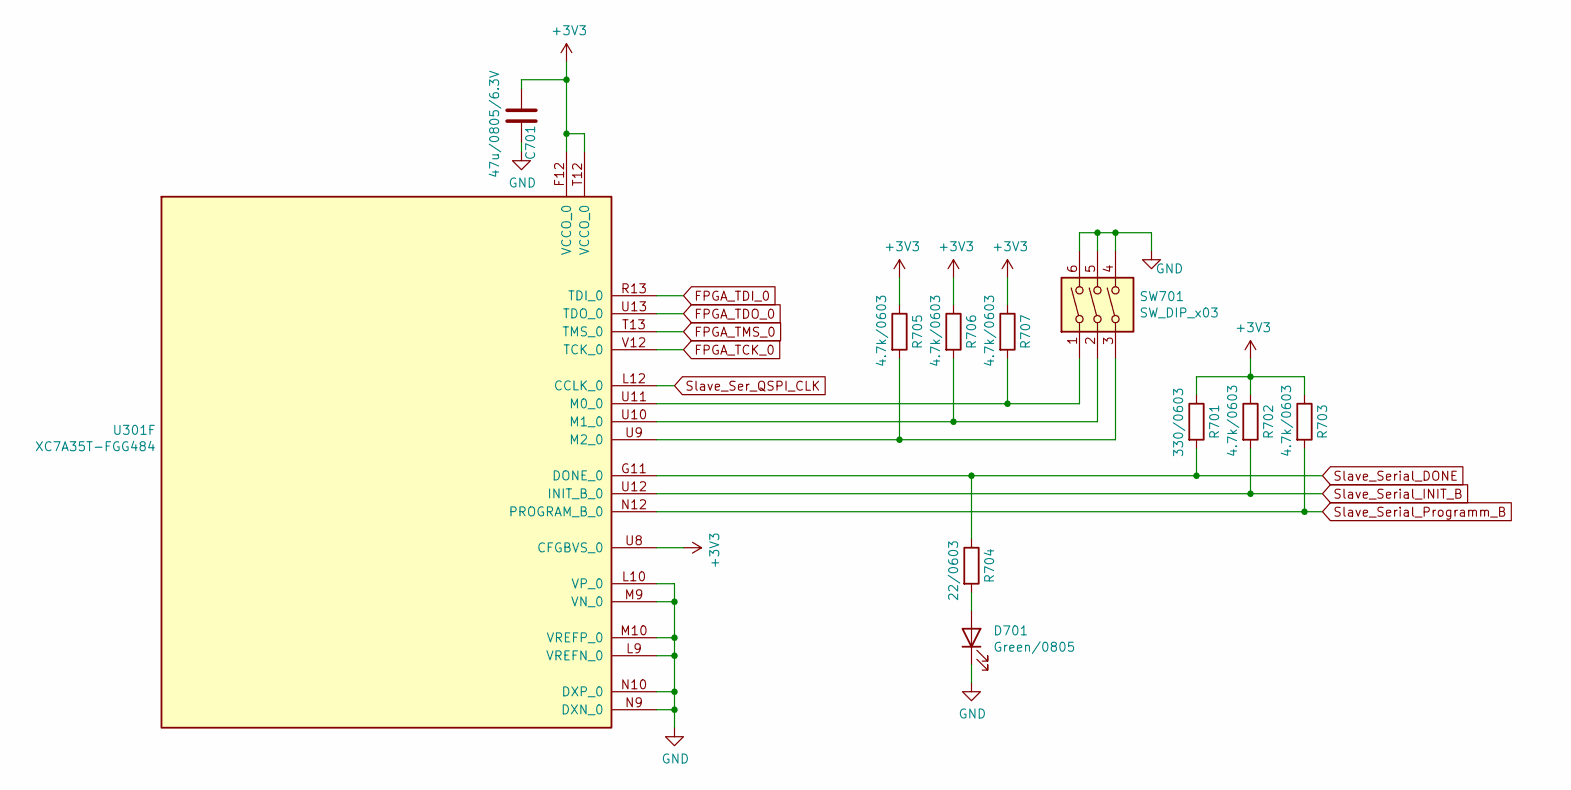
[picture p31: schematic FPGA_F.sch]

Parts:
C701: 47u/0805/6.3V; C_0805_2012Metric
D701: Green/0805; LED_0805_2012Metric
R701: 330/0603; R_0603_1608Metric
R702, R703, R705, R706, R707: 4.7k/0603; R_0603_1608Metric
R704: 22/0603; R_0603_1608Metric
SW701: SW_DIP_x03; SW_DIP_SPSTx03_Slide_9.78x9.8mm_W7.62mm_P2.54mm
U301: XC7A35T-FGG484; Xilinx_FGG484

Connections:
+3V3: C701.1, R701.1, R702.1, R703.1, R705.1, R706.1, R707.1, U301.F12 (VCCO_0), U301.T12 (VCCO_0), U301.U8 (CFGBVS_0)
FPGA_TCK_0: U301.V12 (TCK_0)
FPGA_TDI_0: U301.R13 (TDI_0)
FPGA_TDO_0: U301.U13 (TDO_0)
FPGA_TMS_0: U301.T13 (TMS_0)
GND: C701.2, D701.1 (K), SW701.4, SW701.5, SW701.6, U301.L9 (VREFN_0), U301.L10 (VP_0), U301.M9 (VN_0), U301.M10 (VREFP_0), U301.N9 (DXN_0), U301.N10 (DXP_0)
unnamed: D701.2 (A), R704.2
unnamed: R705.2, SW701.3, U301.U9 (M2_0)
unnamed: R706.2, SW701.2, U301.U10 (M1_0)
unnamed: R707.2, SW701.1, U301.U11 (M0_0)
Slave_Ser_QSPI_CLK: U301.L12 (CCLK_0)
Slave_Serial_DONE: R701.2, R704.1, U301.G11 (DONE_0)
Slave_Serial_INIT_B: R702.2, U301.U12 (INIT_B_0)
Slave_Serial_Programm_B: R703.2, U301.N12 (PROGRAM_B_0)
