ArneAlberts/Bachelorarbeit_Anhang/Schaltung_Layout/FPGA_IO_A.sch

## KiCad design Schaltung_Layout/FPGA_IO_A.sch (2021-09-20)

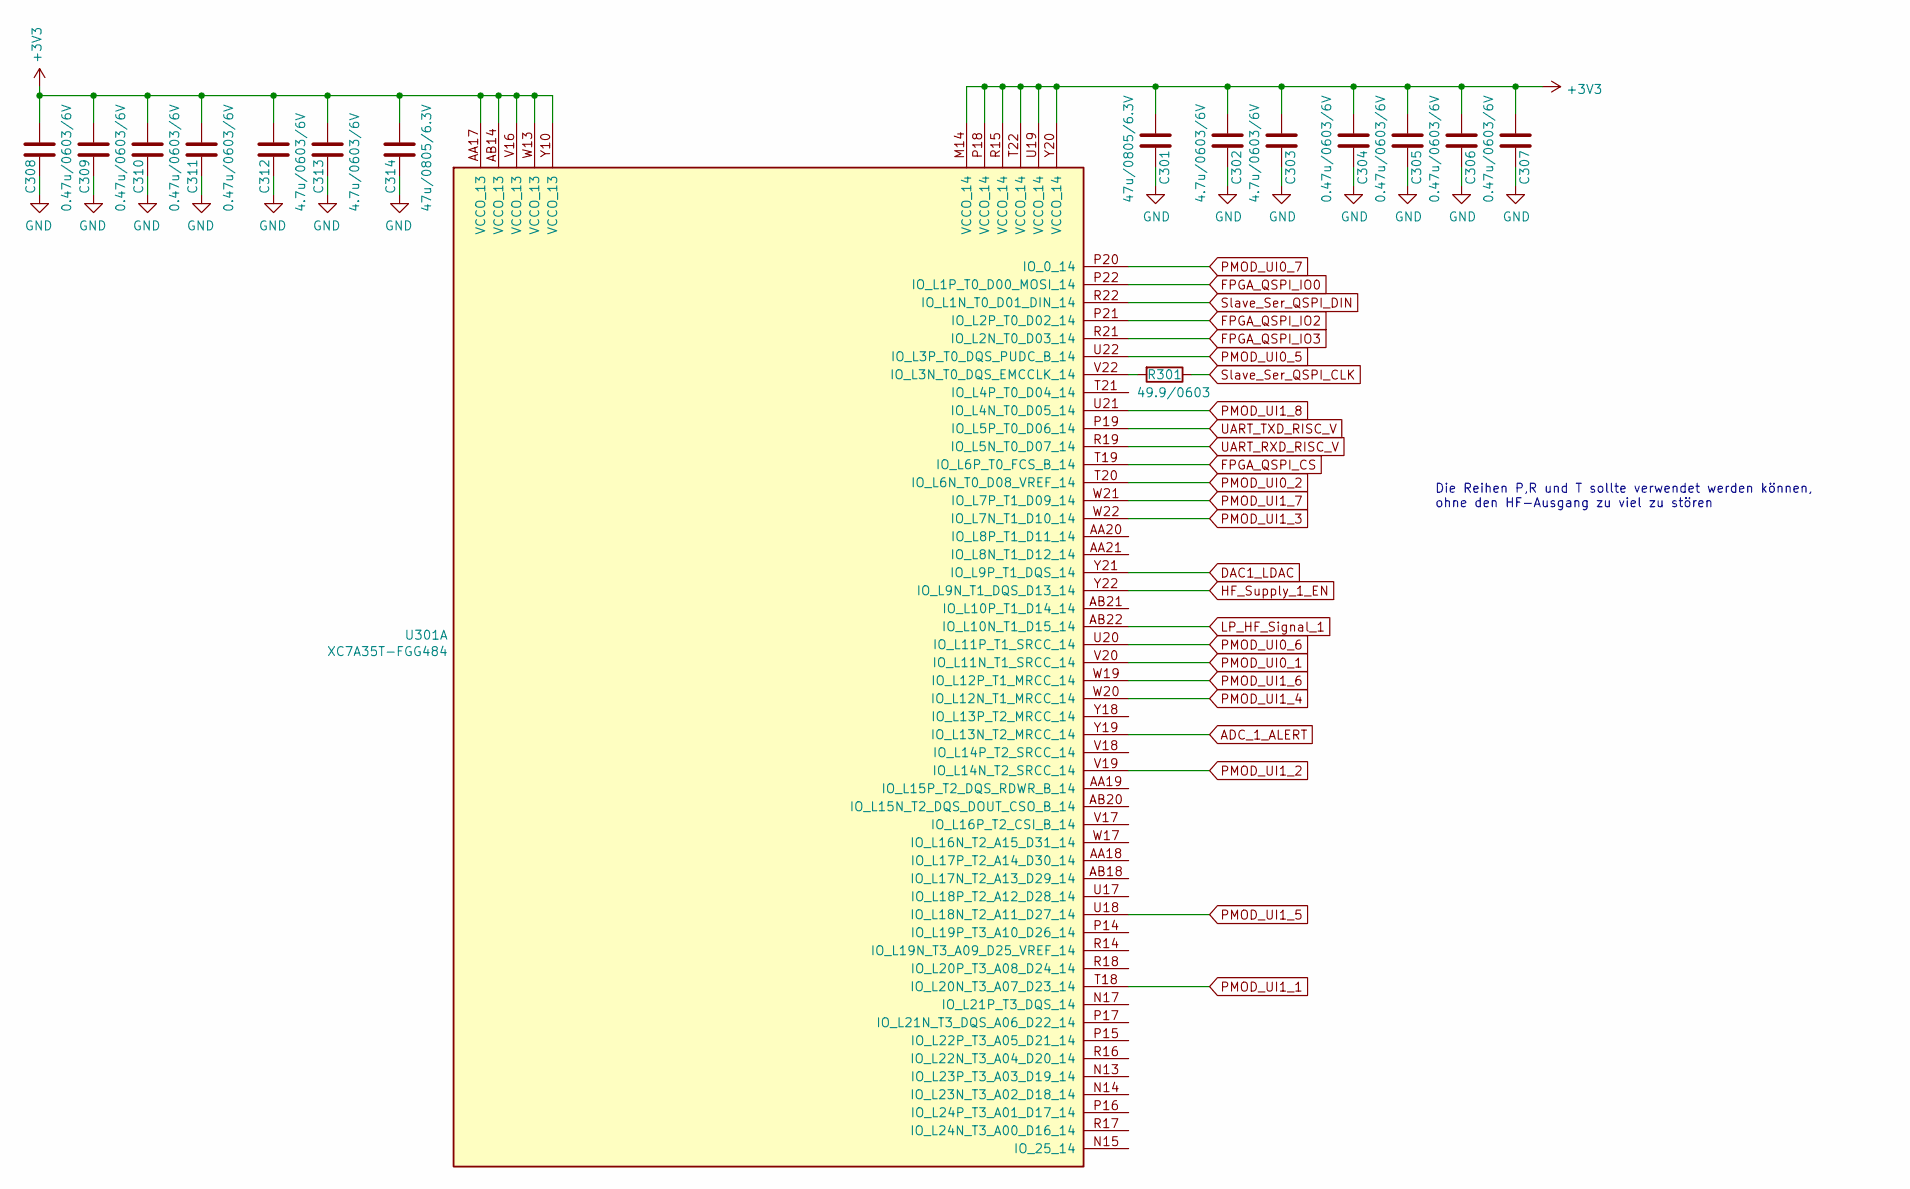
[picture p32: schematic FPGA_IO_A.sch]

Parts:
C301, C314: 47u/0805/6.3V; C_0805_2012Metric
C302, C303, C312, C313: 4.7u/0603/6V; C_0603_1608Metric
C304, C305, C306, C307, C308, C309, C310, C311: 0.47u/0603/6V; C_0603_1608Metric
R301: 49.9/0603; R_0603_1608Metric
U301: XC7A35T-FGG484; Xilinx_FGG484

Connections:
+3V3: C301.1, C302.1, C303.1, C304.1, C305.1, C306.1, C307.1, C308.1, C309.1, C310.1, C311.1, C312.1, C313.1, C314.1, U301.AA17 (VCCO_13), U301.AB14 (VCCO_13), U301.M14 (VCCO_14), U301.P18 (VCCO_14), U301.R15 (VCCO_14), U301.T22 (VCCO_14), U301.U19 (VCCO_14), U301.V16 (VCCO_13), U301.W13 (VCCO_13), U301.Y10 (VCCO_13), U301.Y20 (VCCO_14)
ADC_1_ALERT: U301.Y19 (IO_L13N_T2_MRCC_14)
DAC1_LDAC: U301.Y21 (IO_L9P_T1_DQS_14)
FPGA_QSPI_CS: U301.T19 (IO_L6P_T0_FCS_B_14)
FPGA_QSPI_IO0: U301.P22 (IO_L1P_T0_D00_MOSI_14)
FPGA_QSPI_IO2: U301.P21 (IO_L2P_T0_D02_14)
FPGA_QSPI_IO3: U301.R21 (IO_L2N_T0_D03_14)
GND: C301.2, C302.2, C303.2, C304.2, C305.2, C306.2, C307.2, C308.2, C309.2, C310.2, C311.2, C312.2, C313.2, C314.2
HF_Supply_1_EN: U301.Y22 (IO_L9N_T1_DQS_D13_14)
LP_HF_Signal_1: U301.AB22 (IO_L10N_T1_D15_14)
unnamed: R301.2, U301.V22 (IO_L3N_T0_DQS_EMCCLK_14)
PMOD_UI0_1: U301.V20 (IO_L11N_T1_SRCC_14)
PMOD_UI0_2: U301.T20 (IO_L6N_T0_D08_VREF_14)
PMOD_UI0_5: U301.U22 (IO_L3P_T0_DQS_PUDC_B_14)
PMOD_UI0_6: U301.U20 (IO_L11P_T1_SRCC_14)
PMOD_UI0_7: U301.P20 (IO_0_14)
PMOD_UI1_1: U301.T18 (IO_L20N_T3_A07_D23_14)
PMOD_UI1_2: U301.V19 (IO_L14N_T2_SRCC_14)
PMOD_UI1_3: U301.W22 (IO_L7N_T1_D10_14)
PMOD_UI1_4: U301.W20 (IO_L12N_T1_MRCC_14)
PMOD_UI1_5: U301.U18 (IO_L18N_T2_A11_D27_14)
PMOD_UI1_6: U301.W19 (IO_L12P_T1_MRCC_14)
PMOD_UI1_7: U301.W21 (IO_L7P_T1_D09_14)
PMOD_UI1_8: U301.U21 (IO_L4N_T0_D05_14)
Slave_Ser_QSPI_CLK: R301.1
Slave_Ser_QSPI_DIN: U301.R22 (IO_L1N_T0_D01_DIN_14)
UART_RXD_RISC_V: U301.R19 (IO_L5N_T0_D07_14)
UART_TXD_RISC_V: U301.P19 (IO_L5P_T0_D06_14)

Notes on the sheet:
Die Reihen P,R und T sollte verwendet werden können, ohne den HF-Ausgang zu viel zu stören
