ArneAlberts/Bachelorarbeit_Anhang/Schaltung_Layout/FPGA_IO_B.sch

## KiCad design Schaltung_Layout/FPGA_IO_B.sch (2021-09-20)

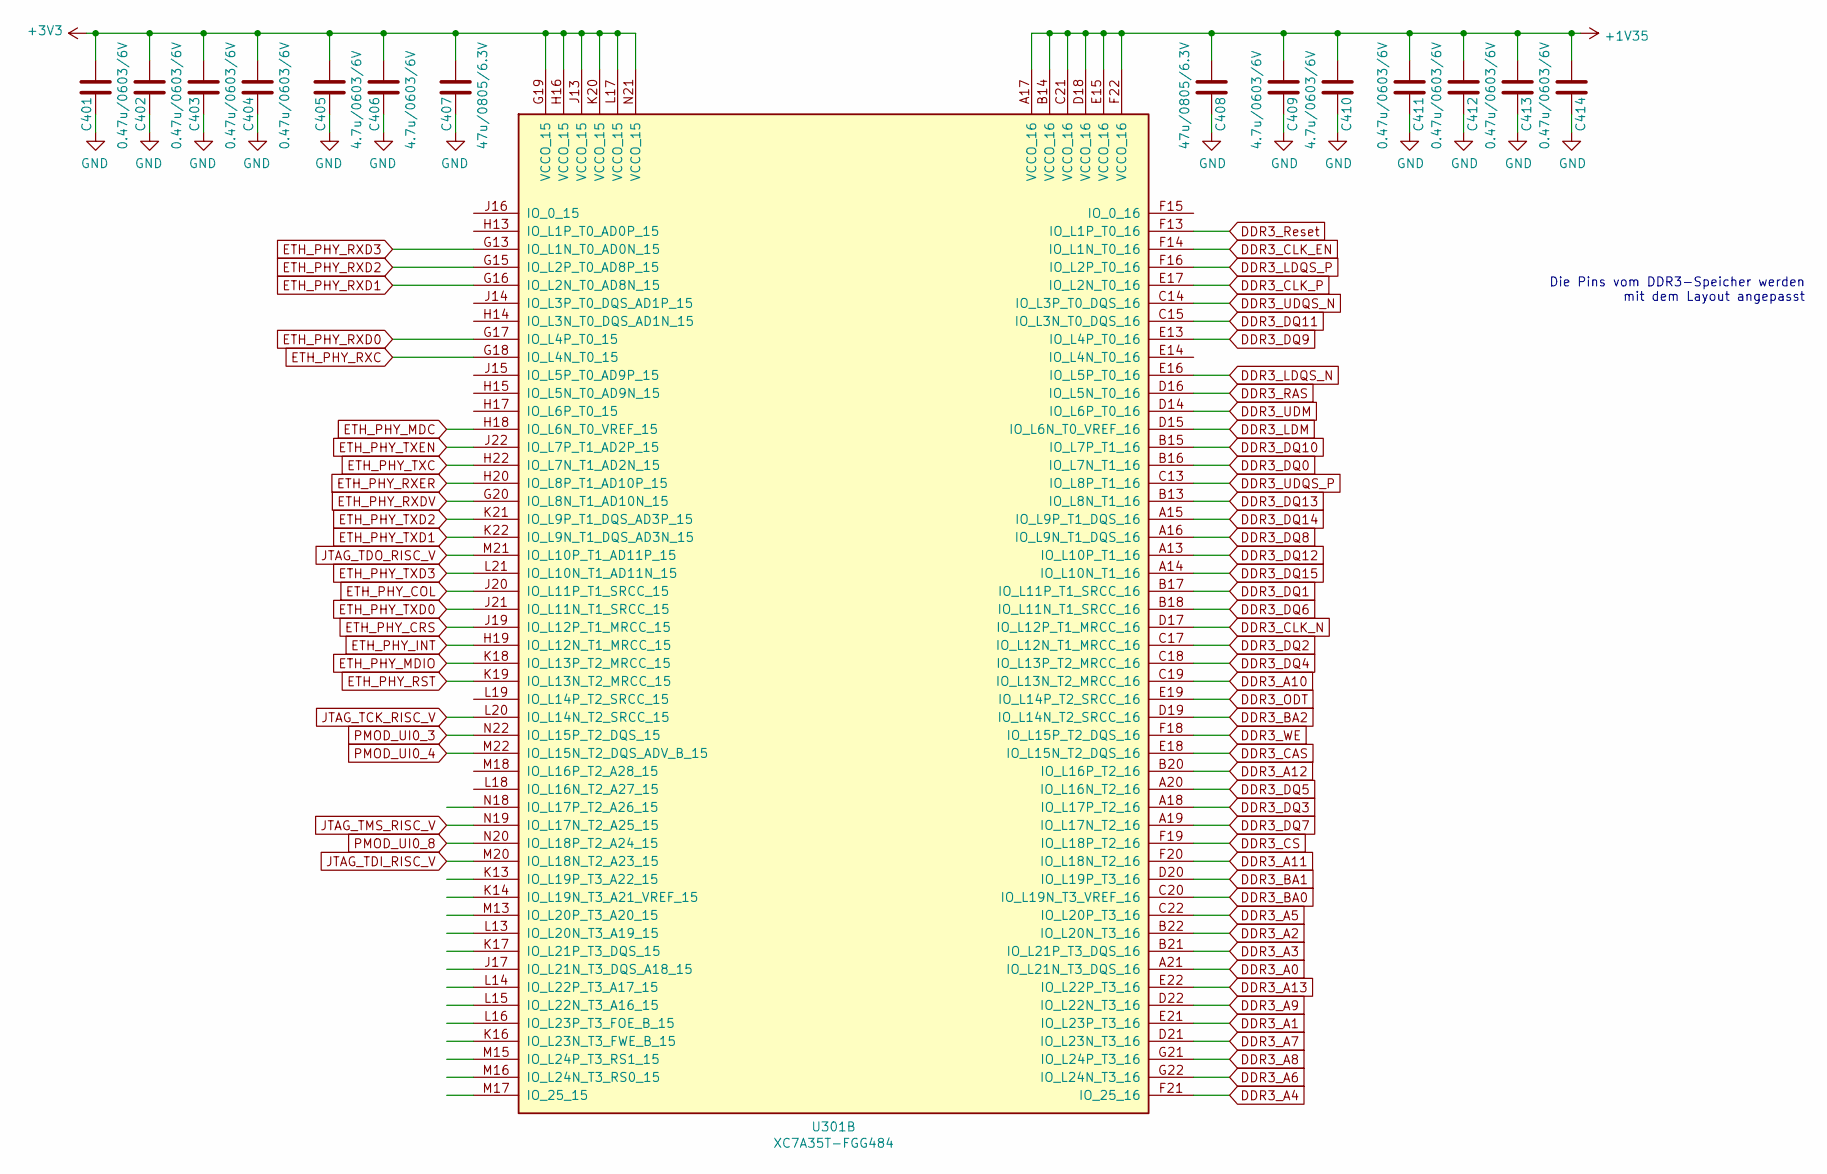
[picture p33: schematic FPGA_IO_B.sch]

Parts:
C401, C402, C403, C404, C411, C412, C413, C414: 0.47u/0603/6V; C_0603_1608Metric
C405, C406, C409, C410: 4.7u/0603/6V; C_0603_1608Metric
C407, C408: 47u/0805/6.3V; C_0805_2012Metric
U301: XC7A35T-FGG484; Xilinx_FGG484

Connections:
+1V35: C408.1, C409.1, C410.1, C411.1, C412.1, C413.1, C414.1, U301.A17 (VCCO_16), U301.B14 (VCCO_16), U301.C21 (VCCO_16), U301.D18 (VCCO_16), U301.E15 (VCCO_16), U301.F22 (VCCO_16)
+3V3: C401.1, C402.1, C403.1, C404.1, C405.1, C406.1, C407.1, U301.G19 (VCCO_15), U301.H16 (VCCO_15), U301.J13 (VCCO_15), U301.K20 (VCCO_15), U301.L17 (VCCO_15), U301.N21 (VCCO_15)
DDR3_A0: U301.A21 (IO_L21N_T3_DQS_16)
DDR3_A1: U301.E21 (IO_L23P_T3_16)
DDR3_A2: U301.B22 (IO_L20N_T3_16)
DDR3_A3: U301.B21 (IO_L21P_T3_DQS_16)
DDR3_A4: U301.F21 (IO_25_16)
DDR3_A5: U301.C22 (IO_L20P_T3_16)
DDR3_A6: U301.G22 (IO_L24N_T3_16)
DDR3_A7: U301.D21 (IO_L23N_T3_16)
DDR3_A8: U301.G21 (IO_L24P_T3_16)
DDR3_A9: U301.D22 (IO_L22N_T3_16)
DDR3_A10: U301.C19 (IO_L13N_T2_MRCC_16)
DDR3_A11: U301.F20 (IO_L18N_T2_16)
DDR3_A12: U301.B20 (IO_L16P_T2_16)
DDR3_A13: U301.E22 (IO_L22P_T3_16)
DDR3_BA0: U301.C20 (IO_L19N_T3_VREF_16)
DDR3_BA1: U301.D20 (IO_L19P_T3_16)
DDR3_BA2: U301.D19 (IO_L14N_T2_SRCC_16)
DDR3_CAS: U301.E18 (IO_L15N_T2_DQS_16)
DDR3_CLK_EN: U301.F14 (IO_L1N_T0_16)
DDR3_CLK_N: U301.D17 (IO_L12P_T1_MRCC_16)
DDR3_CLK_P: U301.E17 (IO_L2N_T0_16)
DDR3_CS: U301.F19 (IO_L18P_T2_16)
DDR3_DQ0: U301.B16 (IO_L7N_T1_16)
DDR3_DQ1: U301.B17 (IO_L11P_T1_SRCC_16)
DDR3_DQ2: U301.C17 (IO_L12N_T1_MRCC_16)
DDR3_DQ3: U301.A18 (IO_L17P_T2_16)
DDR3_DQ4: U301.C18 (IO_L13P_T2_MRCC_16)
DDR3_DQ5: U301.A20 (IO_L16N_T2_16)
DDR3_DQ6: U301.B18 (IO_L11N_T1_SRCC_16)
DDR3_DQ7: U301.A19 (IO_L17N_T2_16)
DDR3_DQ8: U301.A16 (IO_L9N_T1_DQS_16)
DDR3_DQ9: U301.E13 (IO_L4P_T0_16)
DDR3_DQ10: U301.B15 (IO_L7P_T1_16)
DDR3_DQ11: U301.C15 (IO_L3N_T0_DQS_16)
DDR3_DQ12: U301.A13 (IO_L10P_T1_16)
DDR3_DQ13: U301.B13 (IO_L8N_T1_16)
DDR3_DQ14: U301.A15 (IO_L9P_T1_DQS_16)
DDR3_DQ15: U301.A14 (IO_L10N_T1_16)
DDR3_LDM: U301.D15 (IO_L6N_T0_VREF_16)
DDR3_LDQS_N: U301.E16 (IO_L5P_T0_16)
DDR3_LDQS_P: U301.F16 (IO_L2P_T0_16)
DDR3_ODT: U301.E19 (IO_L14P_T2_SRCC_16)
DDR3_RAS: U301.D16 (IO_L5N_T0_16)
DDR3_Reset: U301.F13 (IO_L1P_T0_16)
DDR3_UDM: U301.D14 (IO_L6P_T0_16)
DDR3_UDQS_N: U301.C14 (IO_L3P_T0_DQS_16)
DDR3_UDQS_P: U301.C13 (IO_L8P_T1_16)
DDR3_WE: U301.F18 (IO_L15P_T2_DQS_16)
ETH_PHY_COL: U301.J20 (IO_L11P_T1_SRCC_15)
ETH_PHY_CRS: U301.J19 (IO_L12P_T1_MRCC_15)
ETH_PHY_INT: U301.H19 (IO_L12N_T1_MRCC_15)
ETH_PHY_MDC: U301.H18 (IO_L6N_T0_VREF_15)
ETH_PHY_MDIO: U301.K18 (IO_L13P_T2_MRCC_15)
ETH_PHY_RST: U301.K19 (IO_L13N_T2_MRCC_15)
ETH_PHY_RXC: U301.G18 (IO_L4N_T0_15)
ETH_PHY_RXD0: U301.G17 (IO_L4P_T0_15)
ETH_PHY_RXD1: U301.G16 (IO_L2N_T0_AD8N_15)
ETH_PHY_RXD2: U301.G15 (IO_L2P_T0_AD8P_15)
ETH_PHY_RXD3: U301.G13 (IO_L1N_T0_AD0N_15)
ETH_PHY_RXDV: U301.G20 (IO_L8N_T1_AD10N_15)
ETH_PHY_RXER: U301.H20 (IO_L8P_T1_AD10P_15)
ETH_PHY_TXC: U301.H22 (IO_L7N_T1_AD2N_15)
ETH_PHY_TXD0: U301.J21 (IO_L11N_T1_SRCC_15)
ETH_PHY_TXD1: U301.K22 (IO_L9N_T1_DQS_AD3N_15)
ETH_PHY_TXD2: U301.K21 (IO_L9P_T1_DQS_AD3P_15)
ETH_PHY_TXD3: U301.L21 (IO_L10N_T1_AD11N_15)
ETH_PHY_TXEN: U301.J22 (IO_L7P_T1_AD2P_15)
GND: C401.2, C402.2, C403.2, C404.2, C405.2, C406.2, C407.2, C408.2, C409.2, C410.2, C411.2, C412.2, C413.2, C414.2
JTAG_TCK_RISC_V: U301.L20 (IO_L14N_T2_SRCC_15)
JTAG_TDI_RISC_V: U301.M20 (IO_L18N_T2_A23_15)
JTAG_TDO_RISC_V: U301.M21 (IO_L10P_T1_AD11P_15)
JTAG_TMS_RISC_V: U301.N19 (IO_L17N_T2_A25_15)
PMOD_UI0_3: U301.N22 (IO_L15P_T2_DQS_15)
PMOD_UI0_4: U301.M22 (IO_L15N_T2_DQS_ADV_B_15)
PMOD_UI0_8: U301.N20 (IO_L18P_T2_A24_15)

Notes on the sheet:
Die Pins vom DDR3-Speicher werden mit dem Layout angepasst
