ArneAlberts/Bachelorarbeit_Anhang/Schaltung_Layout/FPGA_IO_C.sch

## KiCad design Schaltung_Layout/FPGA_IO_C.sch (2021-09-20)

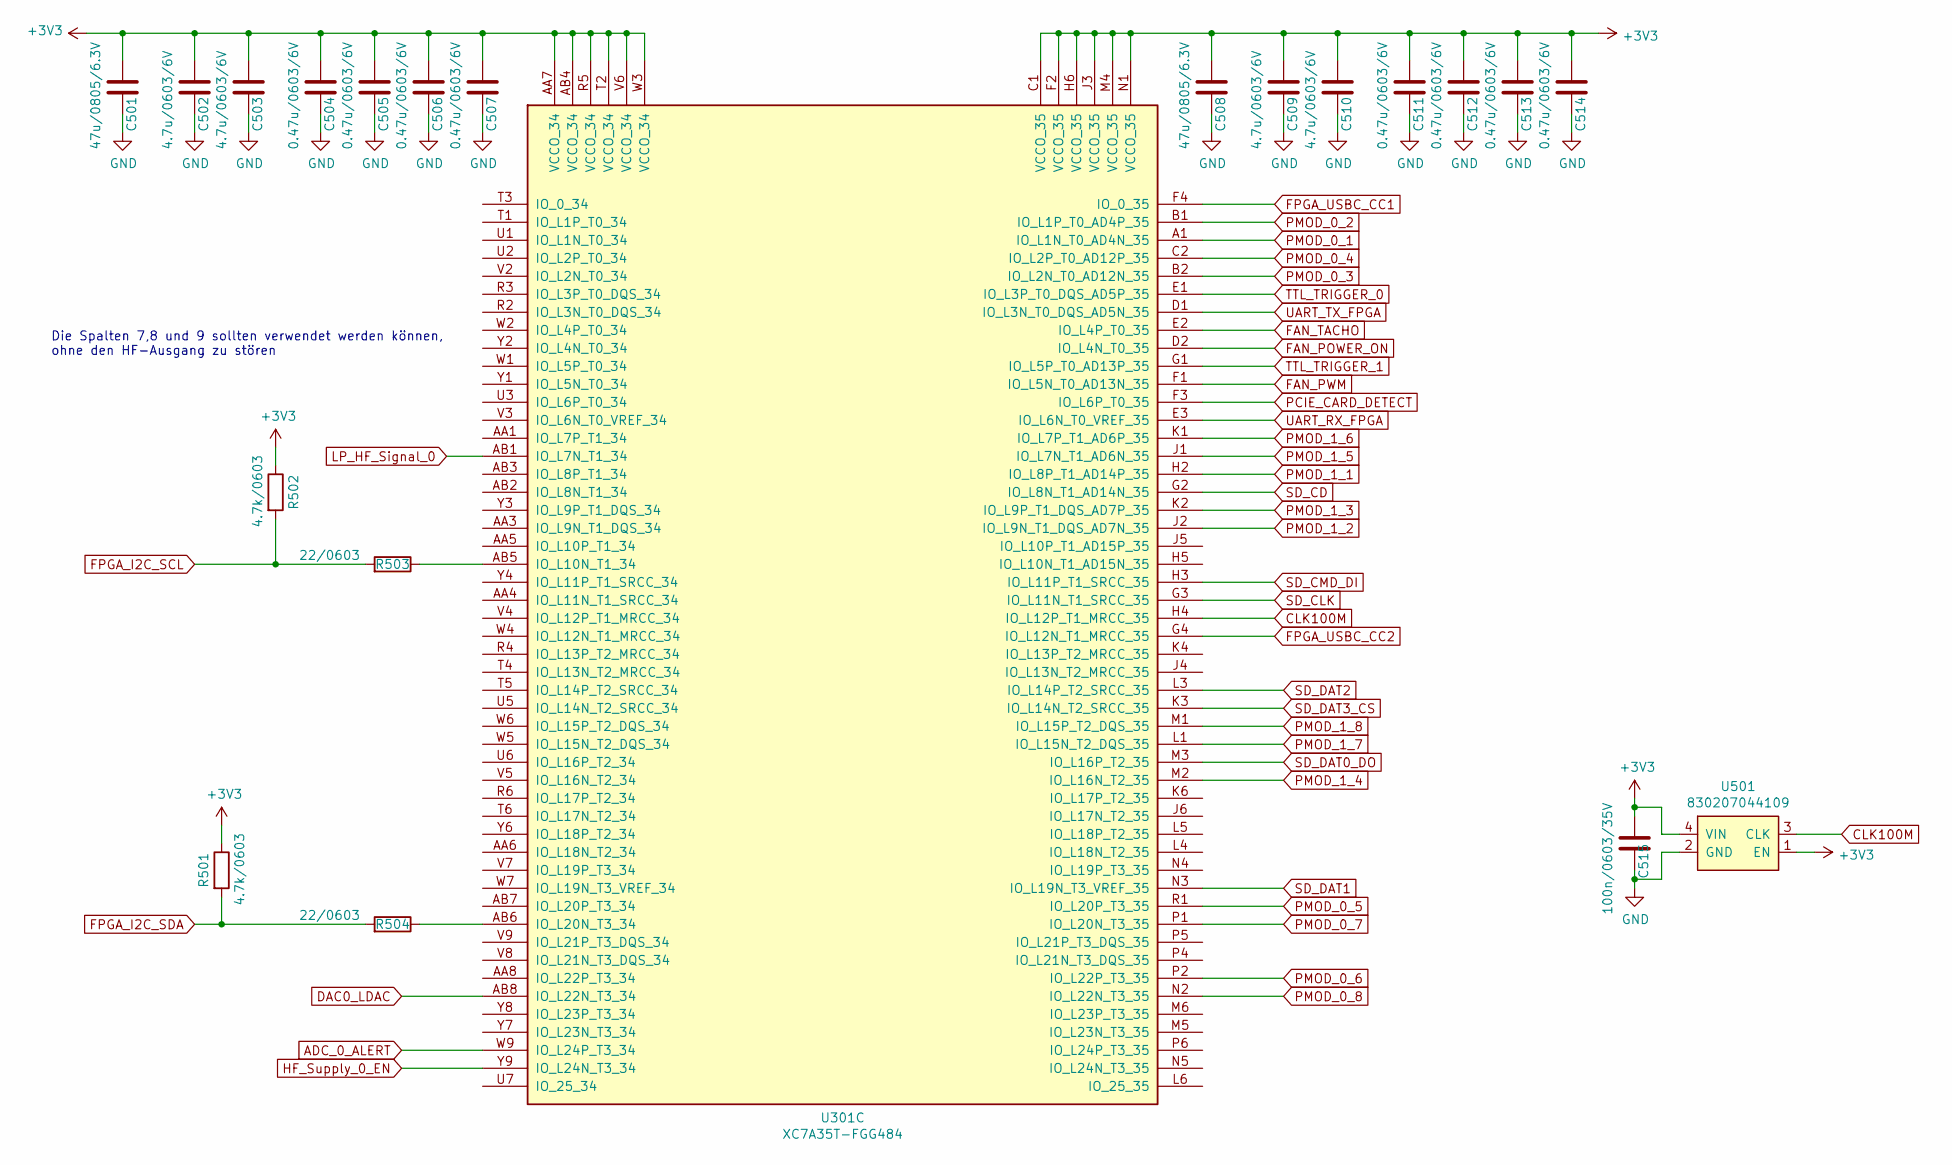
[picture p34: schematic FPGA_IO_C.sch]

Parts:
C501, C508: 47u/0805/6.3V; C_0805_2012Metric
C502, C503, C509, C510: 4.7u/0603/6V; C_0603_1608Metric
C504, C505, C506, C507, C511, C512, C513, C514: 0.47u/0603/6V; C_0603_1608Metric
C515: 100n/0603/35V; C_0603_1608Metric
R501, R502: 4.7k/0603; R_0603_1608Metric
R503, R504: 22/0603; R_0603_1608Metric
U301: XC7A35T-FGG484; Xilinx_FGG484
U501: 830207044109; Oscillator_SMD_Abracon_ASE-4Pin_3.2x2.5mm_HandSoldering

Connections:
+3V3: C501.1, C502.1, C503.1, C504.1, C505.1, C506.1, C507.1, C508.1, C509.1, C510.1, C511.1, C512.1, C513.1, C514.1, C515.1, R501.1, R502.1, U301.AA7 (VCCO_34), U301.AB4 (VCCO_34), U301.C1 (VCCO_35), U301.F2 (VCCO_35), U301.H6 (VCCO_35), U301.J3 (VCCO_35), U301.M4 (VCCO_35), U301.N1 (VCCO_35), U301.R5 (VCCO_34), U301.T2 (VCCO_34), U301.V6 (VCCO_34), U301.W3 (VCCO_34), U501.1 (EN), U501.4 (VIN)
ADC_0_ALERT: U301.W9 (IO_L24P_T3_34)
CLK100M: U301.H4 (IO_L12P_T1_MRCC_35), U501.3 (CLK)
DAC0_LDAC: U301.AB8 (IO_L22N_T3_34)
FAN_POWER_ON: U301.D2 (IO_L4N_T0_35)
FAN_PWM: U301.F1 (IO_L5N_T0_AD13N_35)
FAN_TACHO: U301.E2 (IO_L4P_T0_35)
FPGA_I2C_SCL: R502.2, R503.2
FPGA_I2C_SDA: R501.2, R504.2
FPGA_USBC_CC1: U301.F4 (IO_0_35)
FPGA_USBC_CC2: U301.G4 (IO_L12N_T1_MRCC_35)
GND: C501.2, C502.2, C503.2, C504.2, C505.2, C506.2, C507.2, C508.2, C509.2, C510.2, C511.2, C512.2, C513.2, C514.2, C515.2, U501.2 (GND)
HF_Supply_0_EN: U301.Y9 (IO_L24N_T3_34)
LP_HF_Signal_0: U301.AB1 (IO_L7N_T1_34)
unnamed: R503.1, U301.AB5 (IO_L10N_T1_34)
unnamed: R504.1, U301.AB6 (IO_L20N_T3_34)
PCIE_CARD_DETECT: U301.F3 (IO_L6P_T0_35)
PMOD_0_1: U301.A1 (IO_L1N_T0_AD4N_35)
PMOD_0_2: U301.B1 (IO_L1P_T0_AD4P_35)
PMOD_0_3: U301.B2 (IO_L2N_T0_AD12N_35)
PMOD_0_4: U301.C2 (IO_L2P_T0_AD12P_35)
PMOD_0_5: U301.R1 (IO_L20P_T3_35)
PMOD_0_6: U301.P2 (IO_L22P_T3_35)
PMOD_0_7: U301.P1 (IO_L20N_T3_35)
PMOD_0_8: U301.N2 (IO_L22N_T3_35)
PMOD_1_1: U301.H2 (IO_L8P_T1_AD14P_35)
PMOD_1_2: U301.J2 (IO_L9N_T1_DQS_AD7N_35)
PMOD_1_3: U301.K2 (IO_L9P_T1_DQS_AD7P_35)
PMOD_1_4: U301.M2 (IO_L16N_T2_35)
PMOD_1_5: U301.J1 (IO_L7N_T1_AD6N_35)
PMOD_1_6: U301.K1 (IO_L7P_T1_AD6P_35)
PMOD_1_7: U301.L1 (IO_L15N_T2_DQS_35)
PMOD_1_8: U301.M1 (IO_L15P_T2_DQS_35)
SD_CD: U301.G2 (IO_L8N_T1_AD14N_35)
SD_CLK: U301.G3 (IO_L11N_T1_SRCC_35)
SD_CMD_DI: U301.H3 (IO_L11P_T1_SRCC_35)
SD_DAT0_DO: U301.M3 (IO_L16P_T2_35)
SD_DAT1: U301.N3 (IO_L19N_T3_VREF_35)
SD_DAT2: U301.L3 (IO_L14P_T2_SRCC_35)
SD_DAT3_CS: U301.K3 (IO_L14N_T2_SRCC_35)
TTL_TRIGGER_0: U301.E1 (IO_L3P_T0_DQS_AD5P_35)
TTL_TRIGGER_1: U301.G1 (IO_L5P_T0_AD13P_35)
UART_RX_FPGA: U301.E3 (IO_L6N_T0_VREF_35)
UART_TX_FPGA: U301.D1 (IO_L3N_T0_DQS_AD5N_35)

Notes on the sheet:
Die Spalten 7,8 und 9 sollten verwendet werden können, ohne den HF-Ausgang zu stören
