ArneAlberts/Bachelorarbeit_Anhang/Schaltung_Layout/FTDI_RISC_V.sch

## KiCad design Schaltung_Layout/FTDI_RISC_V.sch (2021-09-20)

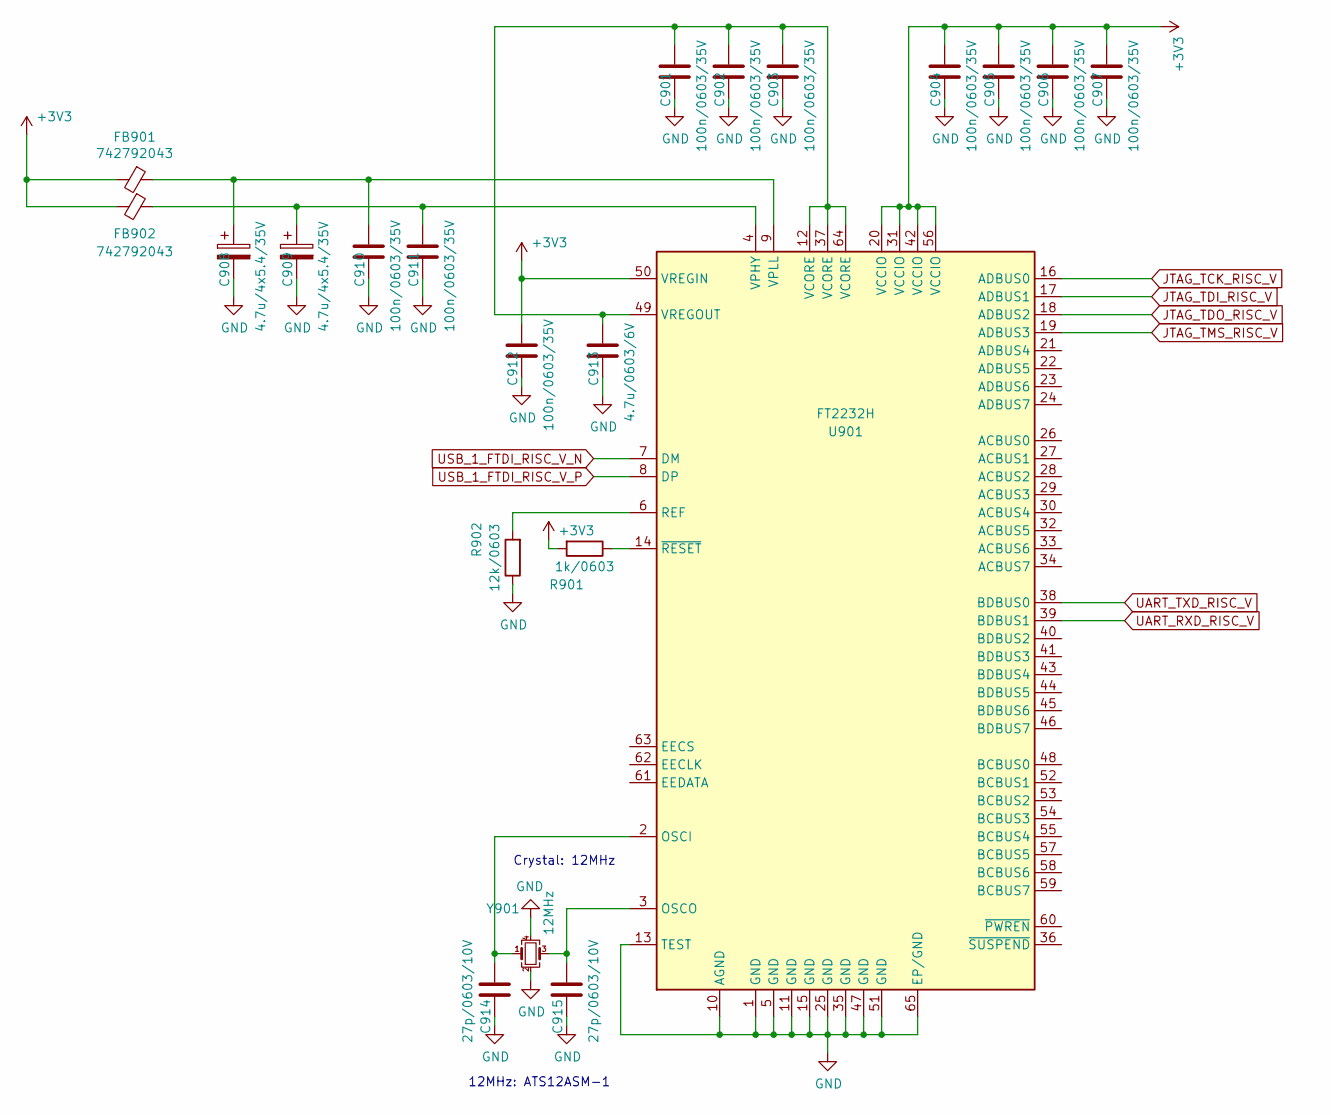
[picture p35: schematic FTDI_RISC_V.sch]

Parts:
C901, C902, C903, C904, C905, C906, C907, C910, C911, C912: 100n/0603/35V; C_0603_1608Metric
C908, C909: 4.7u/4x5.4/35V; CP_Elec_4x5.4
C913: 4.7u/0603/6V; C_0603_1608Metric
C914, C915: 27p/0603/10V; C_0603_1608Metric
FB901, FB902: 742792043; C_0805_2012Metric
R901: 1k/0603; R_0603_1608Metric
R902: 12k/0603; R_0603_1608Metric
U901: FT2232H; QFN-64-1EP_9x9mm_P0.5mm_EP4.35x4.35mm
Y901: 12MHz; Crystal_SMD_3225-4Pin_3.2x2.5mm

Connections:
+3V3: C904.1, C905.1, C906.1, C907.1, C912.1, FB901.2, FB902.2, R901.2, U901.20 (VCCIO), U901.31 (VCCIO), U901.42 (VCCIO), U901.50 (VREGIN), U901.56 (VCCIO)
GND: C901.2, C902.2, C903.2, C904.2, C905.2, C906.2, C907.2, C908.2, C909.2, C910.2, C911.2, C912.2, C913.2, C914.2, C915.2, R902.1, U901.1 (GND), U901.5 (GND), U901.10 (AGND), U901.11 (GND), U901.13 (TEST), U901.15 (GND), U901.25 (GND), U901.35 (GND), U901.47 (GND), U901.51 (GND), U901.65 (EP/GND), Y901.2, Y901.4
JTAG_TCK_RISC_V: U901.16 (ADBUS0)
JTAG_TDI_RISC_V: U901.17 (ADBUS1)
JTAG_TDO_RISC_V: U901.18 (ADBUS2)
JTAG_TMS_RISC_V: U901.19 (ADBUS3)
unnamed: C901.1, C902.1, C903.1, C913.1, U901.12 (VCORE), U901.37 (VCORE), U901.49 (VREGOUT), U901.64 (VCORE)
unnamed: C908.1, C910.1, FB901.1, U901.9 (VPLL)
unnamed: C909.1, C911.1, FB902.1, U901.4 (VPHY)
unnamed: C914.1, U901.2 (OSCI), Y901.1
unnamed: C915.1, U901.3 (OSCO), Y901.3
unnamed: R901.1, U901.14 (~RESET)
unnamed: R902.2, U901.6 (REF)
UART_RXD_RISC_V: U901.39 (BDBUS1)
UART_TXD_RISC_V: U901.38 (BDBUS0)
USB_1_FTDI_RISC_V_N: U901.7 (DM)
USB_1_FTDI_RISC_V_P: U901.8 (DP)

Notes on the sheet:
Crystal: 12MHz
12MHz: ATS12ASM-1
