ArneAlberts/Bachelorarbeit_Anhang/Schaltung_Layout/PMIC.sch

## KiCad design Schaltung_Layout/PMIC.sch (2021-09-20)

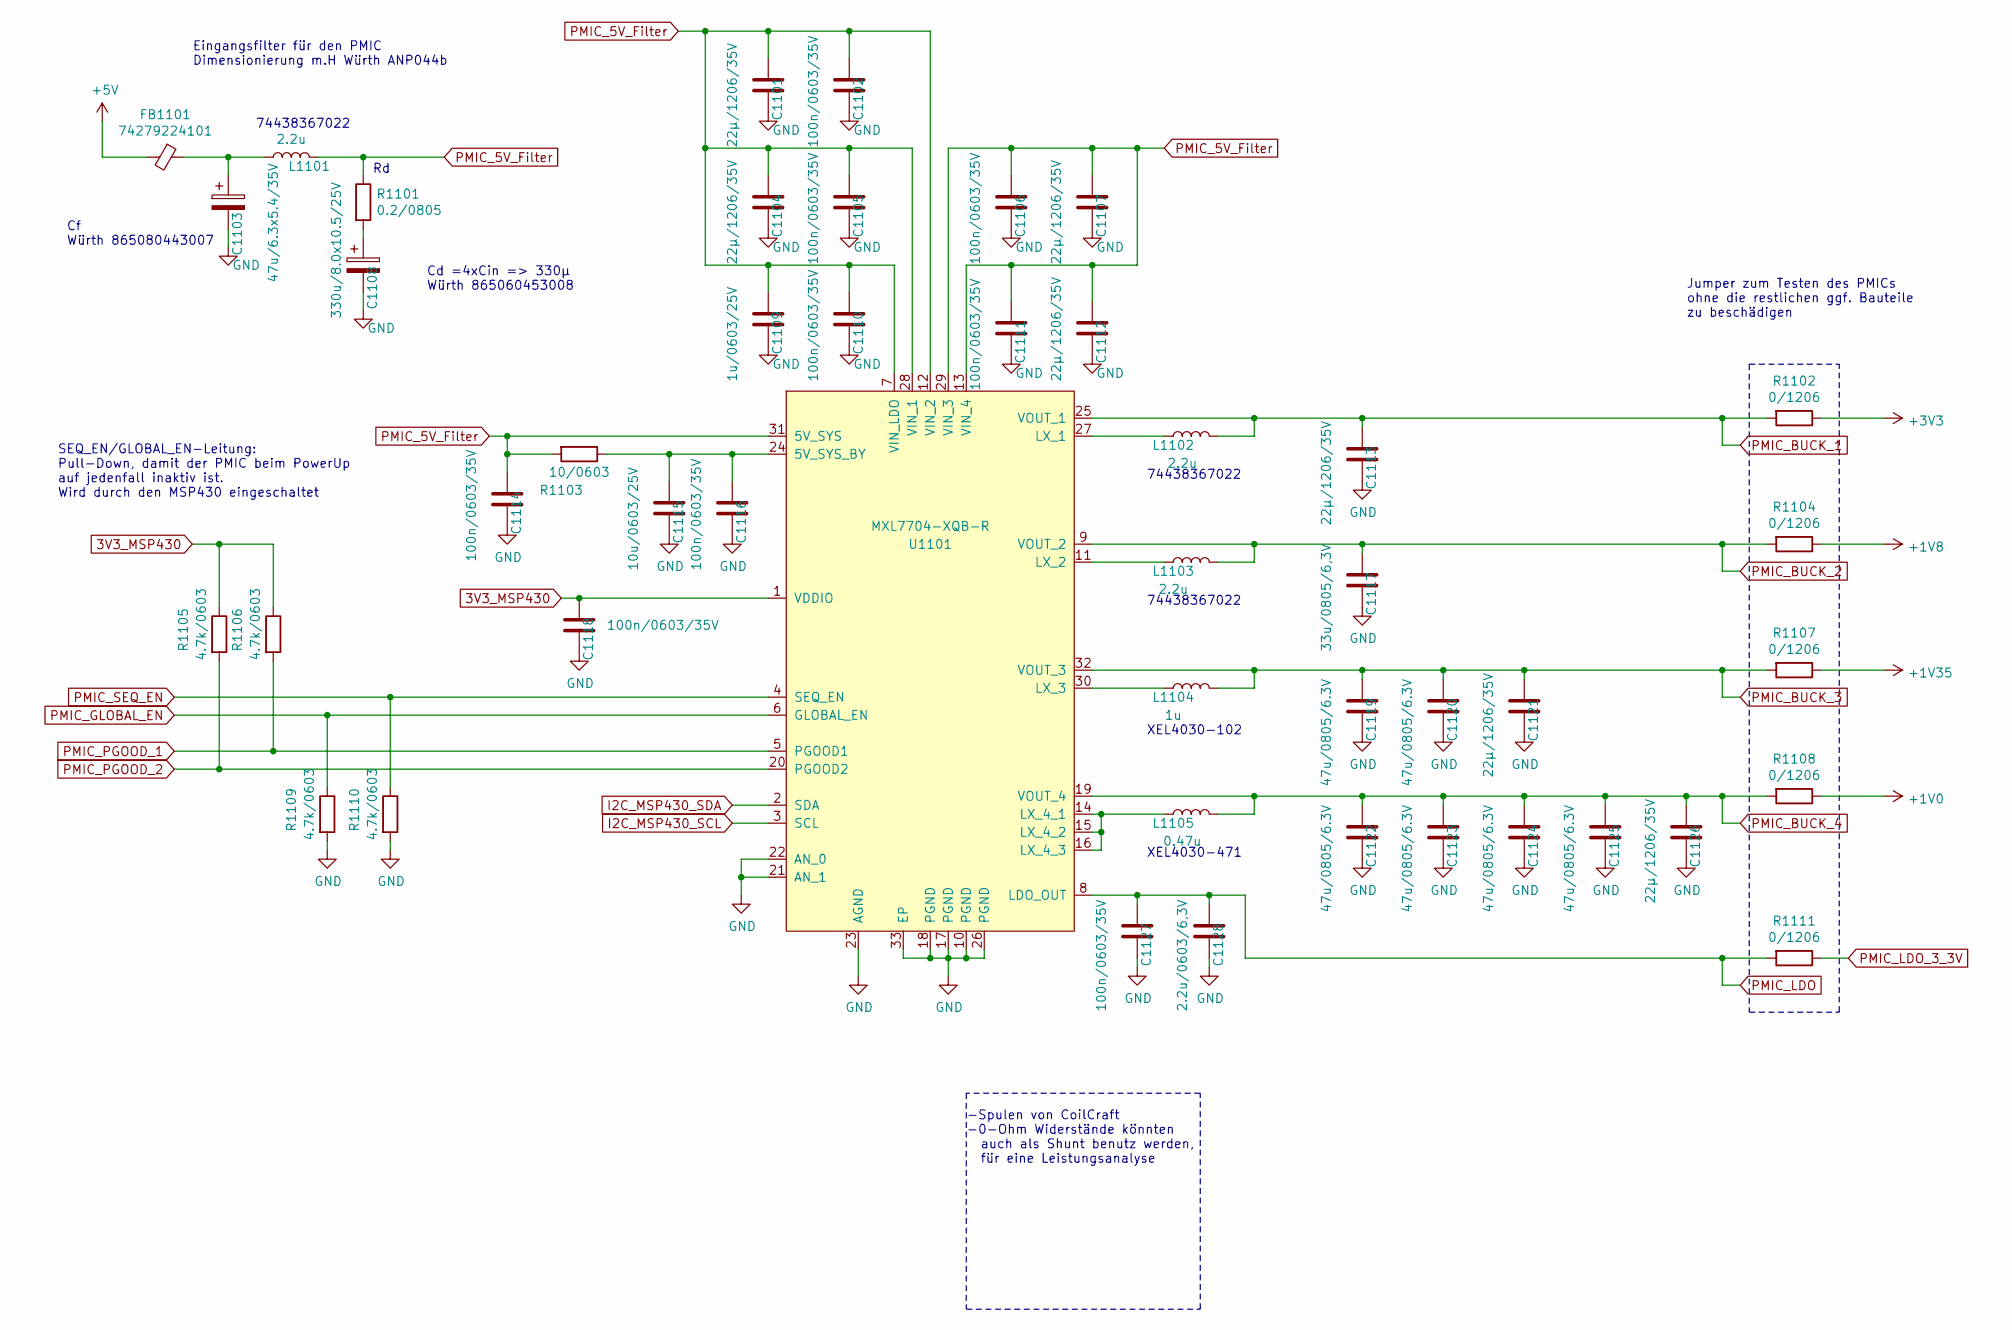
[picture p36: schematic PMIC.sch]

Parts:
C1101, C1104, C1107, C1112, C1113, C1121, C1126: 22µ/1206/35V; C_1206_3216Metric
C1102, C1105, C1106, C1110, C1111, C1114, C1116, C1118, C1127: 100n/0603/35V; C_0603_1608Metric
C1103: 47u/6.3x5.4/35V; CP_Elec_6.3x5.4
C1108: 330u/8.0x10.5/25V; CP_Elec_8x10.5
C1109: 1u/0603/25V; C_0603_1608Metric
C1115: 10u/0603/25V; C_0603_1608Metric
C1117: 33u/0805/6,3V; C_0805_2012Metric
C1119, C1120, C1122, C1123, C1124, C1125: 47u/0805/6.3V; C_0805_2012Metric
C1128: 2.2u/0603/6,3V; C_0603_1608Metric
FB1101: 74279224101; C_2220_5650Metric
L1101, L1102, L1103: 2.2u; L_Wuerth_MAPI-5030
L1104: 1u; L_Coilcraft_XxL4030
L1105: 0.47u; L_Coilcraft_XxL4030
R1101: 0.2/0805; R_0805_2012Metric
R1102, R1104, R1107, R1108, R1111: 0/1206; R_1206_3216Metric
R1103: 10/0603; R_0603_1608Metric
R1105, R1106, R1109, R1110: 4.7k/0603; R_0603_1608Metric
U1101: MXL7704-XQB-R; QFN-32-1EP_5x5mm_P0.5mm_EP3.65x3.65mm_ThermalVias

Connections:
3V3_MSP430: C1118.1, R1105.1, R1106.1, U1101.1 (VDDIO)
+1V0: R1108.1
+1V8: R1104.1
+1V35: R1107.1
+3V3: R1102.1
+5V: FB1101.2
GND: C1101.2, C1102.2, C1103.2, C1104.2, C1105.2, C1106.2, C1107.2, C1108.2, C1109.2, C1110.2, C1111.2, C1112.2, C1113.2, C1114.2, C1115.2, C1116.2, C1117.2, C1118.2, C1119.2, C1120.2, C1121.2, C1122.2, C1123.2, C1124.2, C1125.2, C1126.2, C1127.2, C1128.2, R1109.2, R1110.2, U1101.10 (PGND), U1101.17 (PGND), U1101.18 (PGND), U1101.21 (AN_1), U1101.22 (AN_0), U1101.23 (AGND), U1101.26 (PGND), U1101.33 (EP)
I2C_MSP430_SCL: U1101.3 (SCL)
I2C_MSP430_SDA: U1101.2 (SDA)
unnamed: C1103.1, FB1101.1, L1101.1
unnamed: C1108.1, R1101.2
unnamed: C1115.1, C1116.1, R1103.1, U1101.24 (5V_SYS_BY)
unnamed: L1102.1, U1101.27 (LX_1)
unnamed: L1103.1, U1101.11 (LX_2)
unnamed: L1104.1, U1101.30 (LX_3)
unnamed: L1105.1, U1101.14 (LX_4_1), U1101.15 (LX_4_2), U1101.16 (LX_4_3)
PMIC_5V_Filter: C1101.1, C1102.1, C1104.1, C1105.1, C1106.1, C1107.1, C1109.1, C1110.1, C1111.1, C1112.1, C1114.1, L1101.2, R1101.1, R1103.2, U1101.7 (VIN_LDO), U1101.12 (VIN_2), U1101.13 (VIN_4), U1101.28 (VIN_1), U1101.29 (VIN_3), U1101.31 (5V_SYS)
PMIC_BUCK_1: C1113.1, L1102.2, R1102.2, U1101.25 (VOUT_1)
PMIC_BUCK_2: C1117.1, L1103.2, R1104.2, U1101.9 (VOUT_2)
PMIC_BUCK_3: C1119.1, C1120.1, C1121.1, L1104.2, R1107.2, U1101.32 (VOUT_3)
PMIC_BUCK_4: C1122.1, C1123.1, C1124.1, C1125.1, C1126.1, L1105.2, R1108.2, U1101.19 (VOUT_4)
PMIC_GLOBAL_EN: R1109.1, U1101.6 (GLOBAL_EN)
PMIC_LDO: C1127.1, C1128.1, R1111.2, U1101.8 (LDO_OUT)
PMIC_LDO_3_3V: R1111.1
PMIC_PGOOD_1: R1106.2, U1101.5 (PGOOD1)
PMIC_PGOOD_2: R1105.2, U1101.20 (PGOOD2)
PMIC_SEQ_EN: R1110.1, U1101.4 (SEQ_EN)

Notes on the sheet:
Eingangsfilter für den PMIC Dimensionierung m.H Würth ANP044b
74438367022
XEL4030-102
XEL4030-471
-Spulen von CoilCraft -0-Ohm Widerstände könnten auch als Shunt benutz werden, für eine Leistungsanalyse
Cd =4xCin => 330µ Würth 865060453008
Cf Würth 865080443007
SEQ_EN/GLOBAL_EN-Leitung: Pull-Down, damit der PMIC beim PowerUp auf jedenfall inaktiv ist. Wird durch den MSP430 eingeschaltet
Jumper zum Testen des PMICs ohne die restlichen ggf. Bauteile zu beschädigen
