ArneAlberts/Bachelorarbeit_Anhang/Schaltung_Layout/connector.sch

## KiCad design Schaltung_Layout/connector.sch (2021-09-20)

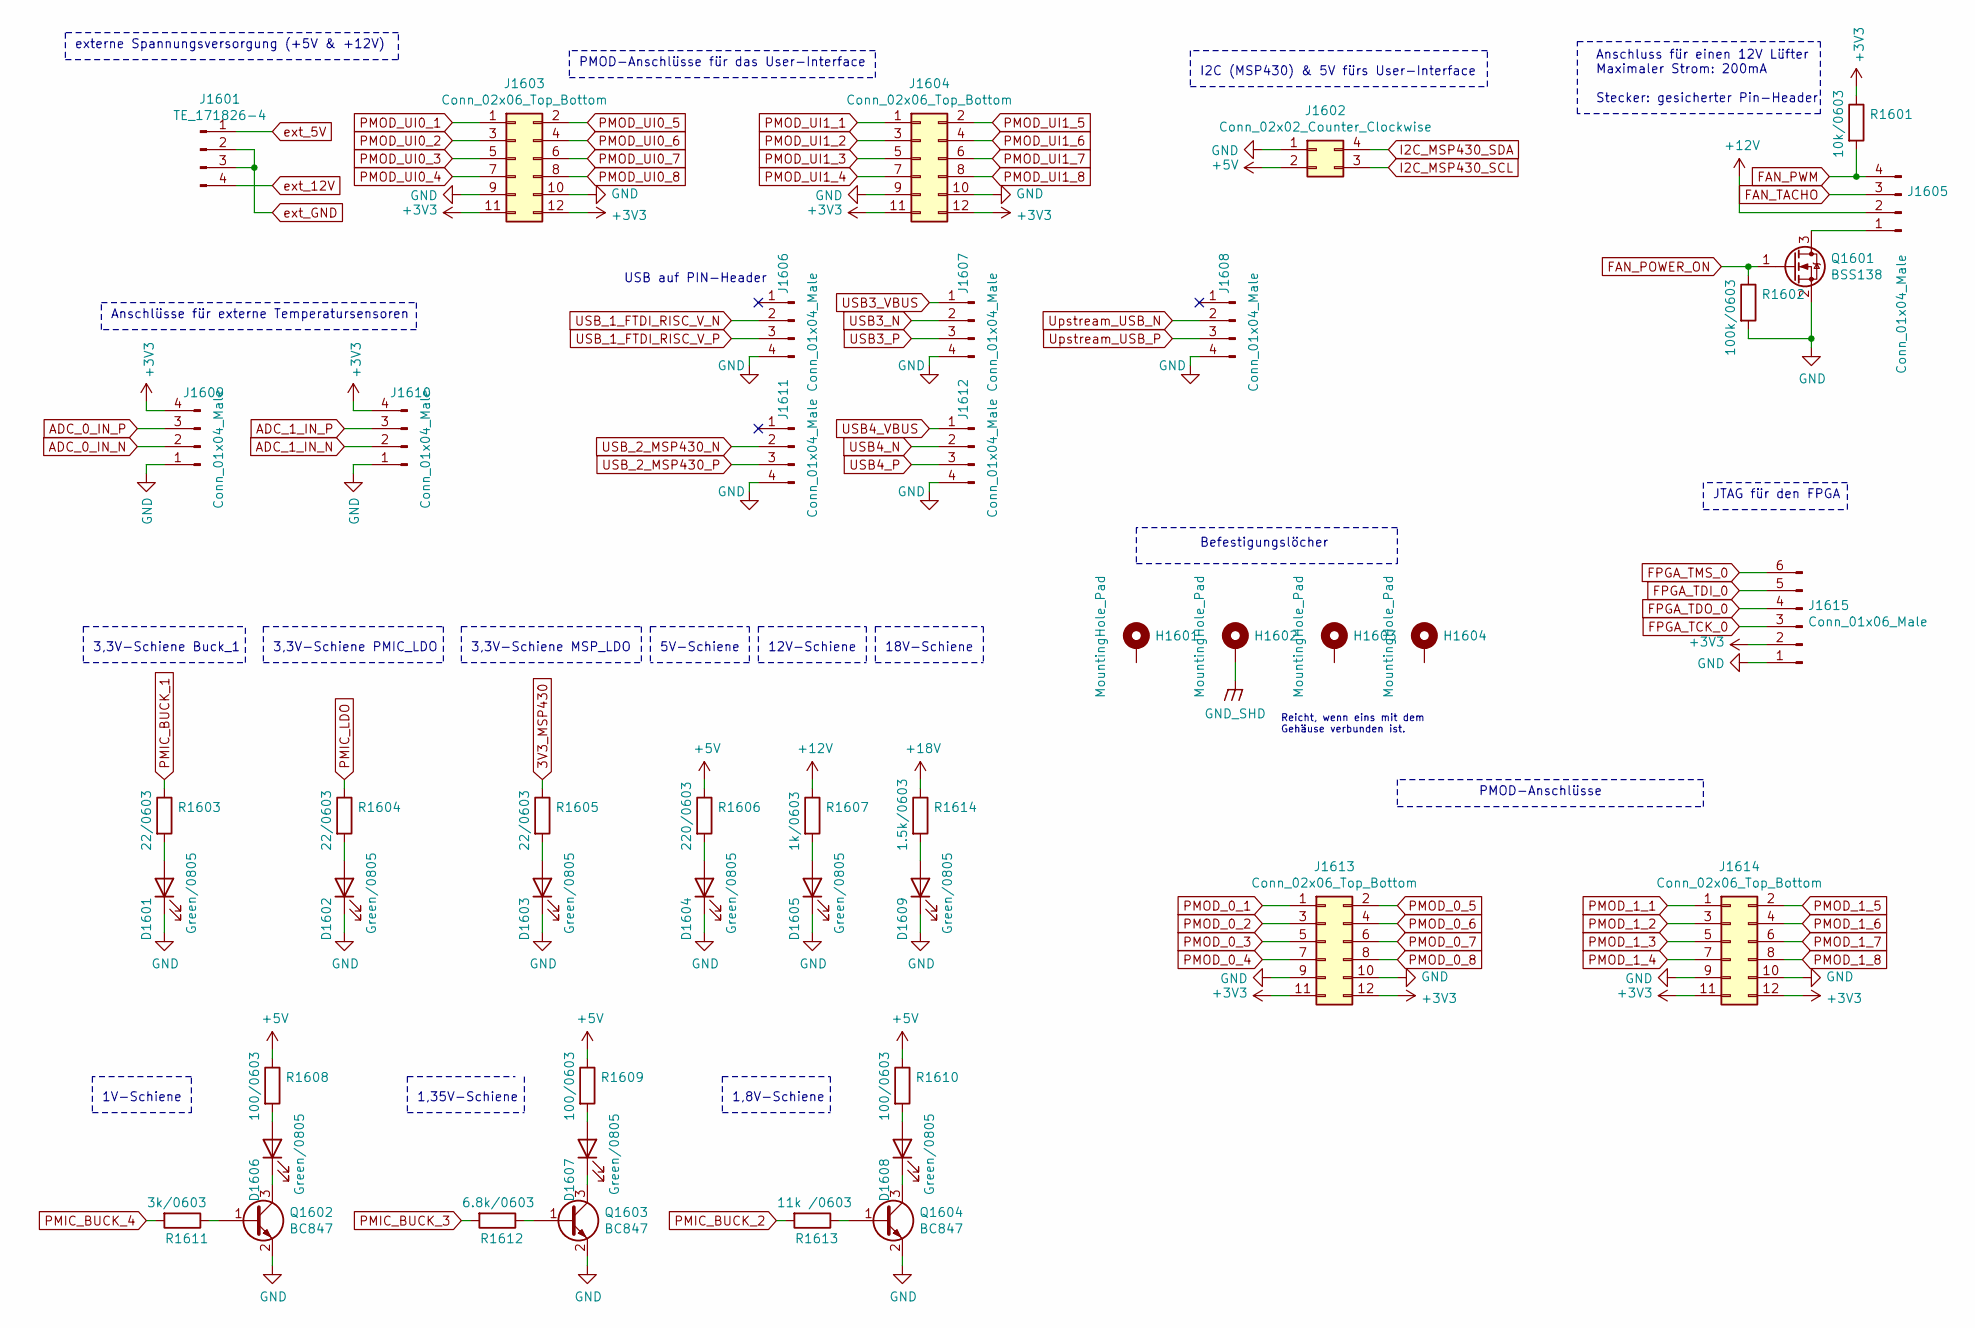
[picture p37: schematic connector.sch]

Parts:
D1601, D1602, D1603, D1604, D1605, D1606, D1607, D1608, D1609: Green/0805; LED_0805_2012Metric
H1601, H1602, H1603, H1604: MountingHole_Pad; MountingHole_3.5mm_Pad_Via
J1601: TE_171826-4; SHDRRA4W69P0X250_1X4_1000X1350X670P
J1602: Conn_02x02_Counter_Clockwise; PinSocket_2x02_P2.54mm_Horizontal
J1603, J1604, J1613, J1614: Conn_02x06_Top_Bottom; PinSocket_2x06_P2.54mm_Horizontal
J1605: Conn_01x04_Male; FanPinHeader_1x04_P2.54mm_Vertical
J1606, J1607, J1608, J1611, J1612: Conn_01x04_Male; PinHeader_1x04_P2.00mm_Vertical
J1609, J1610: Conn_01x04_Male; PinHeader_1x04_P2.54mm_Vertical
J1615: Conn_01x06_Male; PinHeader_1x06_P2.54mm_Vertical_versetzt
Q1601: BSS138; SOT-23
Q1602, Q1603, Q1604: BC847; SOT-23
R1601: 10k/0603; R_0603_1608Metric
R1602: 100k/0603; R_0603_1608Metric
R1603, R1604, R1605: 22/0603; R_0603_1608Metric
R1606: 220/0603; R_0603_1608Metric
R1607: 1k/0603; R_0603_1608Metric
R1608, R1609, R1610: 100/0603; R_0603_1608Metric
R1611: 3k/0603; R_0603_1608Metric
R1612: 6.8k/0603; R_0603_1608Metric
R1613: 11k /0603; R_0603_1608Metric
R1614: 1.5k/0603; R_0603_1608Metric

Connections:
3V3_MSP430: R1605.1
+3V3: J1603.11, J1603.12, J1604.11, J1604.12, J1609.4, J1610.4, J1613.11, J1613.12, J1614.11, J1614.12, J1615.2, R1601.1
+5V: J1602.2, R1606.1, R1608.1, R1609.1, R1610.1
+12V: J1605.2, R1607.1
+18V: R1614.1
ADC_0_IN_N: J1609.2
ADC_0_IN_P: J1609.3
ADC_1_IN_N: J1610.2
ADC_1_IN_P: J1610.3
FAN_POWER_ON: Q1601.1 (G), R1602.1
FAN_PWM: J1605.4, R1601.2
FAN_TACHO: J1605.3
FPGA_TCK_0: J1615.3
FPGA_TDI_0: J1615.5
FPGA_TDO_0: J1615.4
FPGA_TMS_0: J1615.6
GND: D1601.1 (K), D1602.1 (K), D1603.1 (K), D1604.1 (K), D1605.1 (K), D1609.1 (K), J1602.1, J1603.9, J1603.10, J1604.9, J1604.10, J1606.4, J1607.4, J1608.4, J1609.1, J1610.1, J1611.4, J1612.4, J1613.9, J1613.10, J1614.9, J1614.10, J1615.1, Q1601.2 (S), Q1602.2 (E), Q1603.2 (E), Q1604.2 (E), R1602.2
GND_SHD: H1602.1
I2C_MSP430_SCL: J1602.3
I2C_MSP430_SDA: J1602.4
unnamed: D1601.2 (A), R1603.2
unnamed: D1602.2 (A), R1604.2
unnamed: D1603.2 (A), R1605.2
unnamed: D1604.2 (A), R1606.2
unnamed: D1605.2 (A), R1607.2
unnamed: D1606.1 (K), Q1602.3 (C)
unnamed: D1606.2 (A), R1608.2
unnamed: D1607.1 (K), Q1603.3 (C)
unnamed: D1607.2 (A), R1609.2
unnamed: D1608.1 (K), Q1604.3 (C)
unnamed: D1608.2 (A), R1610.2
unnamed: D1609.2 (A), R1614.2
unnamed: J1605.1, Q1601.3 (D)
unnamed: Q1602.1 (B), R1611.1
unnamed: Q1603.1 (B), R1612.1
unnamed: Q1604.1 (B), R1613.1
PMIC_BUCK_1: R1603.1
PMIC_BUCK_2: R1613.2
PMIC_BUCK_3: R1612.2
PMIC_BUCK_4: R1611.2
PMIC_LDO: R1604.1
PMOD_0_1: J1613.1
PMOD_0_2: J1613.3
PMOD_0_3: J1613.5
PMOD_0_4: J1613.7
PMOD_0_5: J1613.2
PMOD_0_6: J1613.4
PMOD_0_7: J1613.6
PMOD_0_8: J1613.8
PMOD_1_1: J1614.1
PMOD_1_2: J1614.3
PMOD_1_3: J1614.5
PMOD_1_4: J1614.7
PMOD_1_5: J1614.2
PMOD_1_6: J1614.4
PMOD_1_7: J1614.6
PMOD_1_8: J1614.8
PMOD_UI0_1: J1603.1
PMOD_UI0_2: J1603.3
PMOD_UI0_3: J1603.5
PMOD_UI0_4: J1603.7
PMOD_UI0_5: J1603.2
PMOD_UI0_6: J1603.4
PMOD_UI0_7: J1603.6
PMOD_UI0_8: J1603.8
PMOD_UI1_1: J1604.1
PMOD_UI1_2: J1604.3
PMOD_UI1_3: J1604.5
PMOD_UI1_4: J1604.7
PMOD_UI1_5: J1604.2
PMOD_UI1_6: J1604.4
PMOD_UI1_7: J1604.6
PMOD_UI1_8: J1604.8
USB3_N: J1607.2
USB3_P: J1607.3
USB3_VBUS: J1607.1
USB4_N: J1612.2
USB4_P: J1612.3
USB4_VBUS: J1612.1
USB_1_FTDI_RISC_V_N: J1606.2
USB_1_FTDI_RISC_V_P: J1606.3
USB_2_MSP430_N: J1611.2
USB_2_MSP430_P: J1611.3
Upstream_USB_N: J1608.2
Upstream_USB_P: J1608.3
ext_5V: J1601.1
ext_12V: J1601.4
ext_GND: J1601.2, J1601.3

Notes on the sheet:
JTAG für den FPGA
Anschluss für einen 12V Lüfter Maximaler Strom: 200mA Stecker: gesicherter Pin-Header
PMOD-Anschlüsse für das User-Interface
PMOD-Anschlüsse
I2C (MSP430) & 5V fürs User-Interface
1V-Schiene
1,35V-Schiene
1,8V-Schiene
3,3V-Schiene Buck_1
5V-Schiene
3,3V-Schiene PMIC_LDO
3,3V-Schiene MSP_LDO
12V-Schiene
Anschlüsse für externe Temperatursensoren
externe Spannungsversorgung (+5V & +12V)
USB auf PIN-Header
Befestigungslöcher
18V-Schiene
Reicht, wenn eins mit dem Gehäuse verbunden ist.
