ArneAlberts/Bachelorarbeit_Anhang/Schaltung_Layout/connector_hf.sch

## KiCad design Schaltung_Layout/connector_hf.sch (2021-09-20)

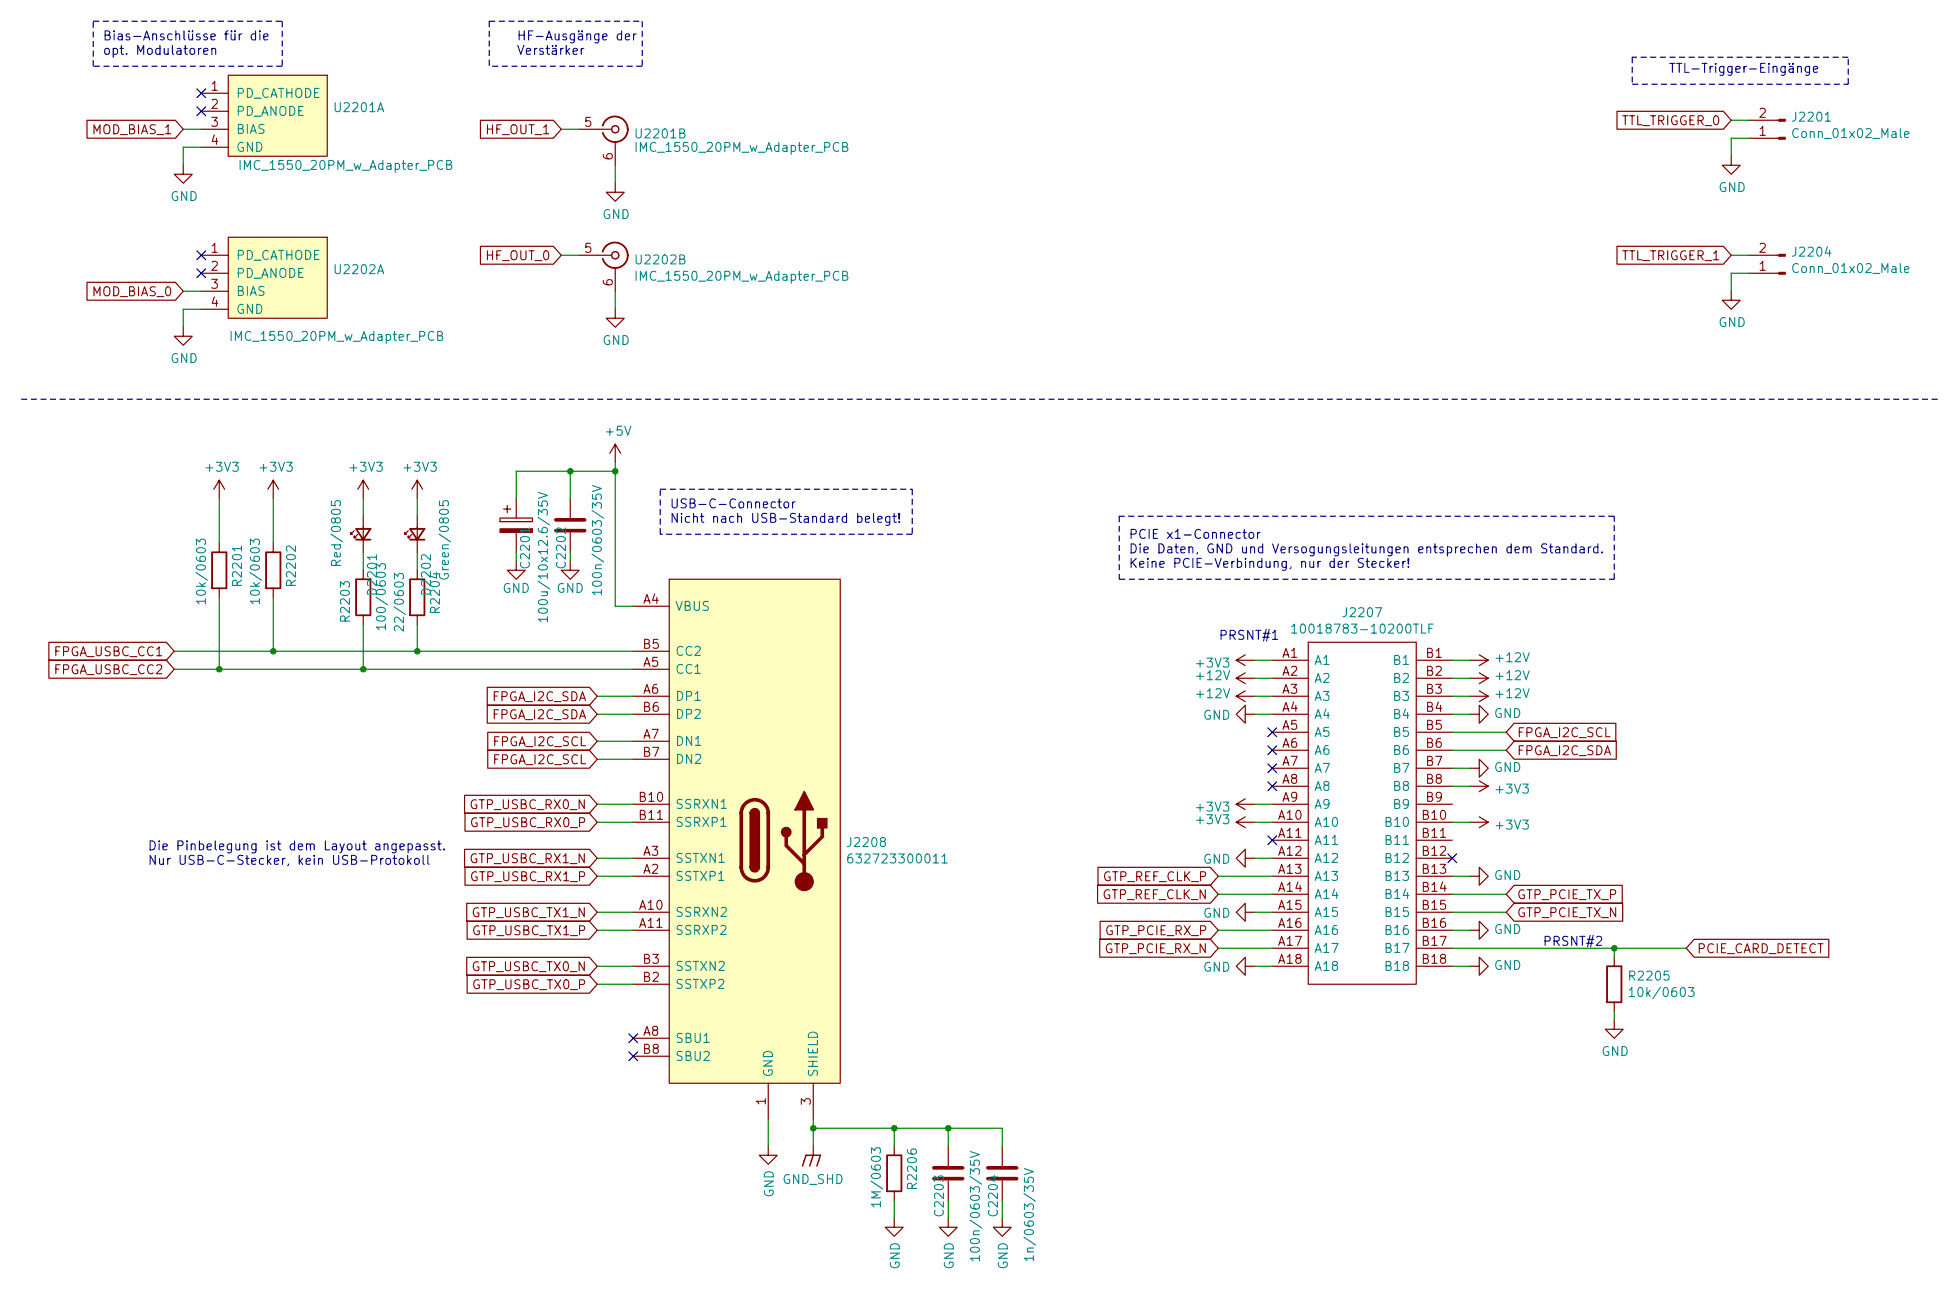
[picture p38: schematic connector_hf.sch]

Parts:
C2201: 100u/10x12.6/35V; CP_Elec_10x12.6
C2202, C2203: 100n/0603/35V; C_0603_1608Metric
C2204: 1n/0603/35V; C_0603_1608Metric
D2201: Red/0805; LED_0805_2012Metric
D2202: Green/0805; LED_0805_2012Metric
J2201, J2204: Conn_01x02_Male; SHDR2W70P0X200_1X2_600X470X635P
J2207: 10018783-10200TLF; 1001878310200TLF; Mouser Part Number 649-1001878310200TLF
J2208: 632723300011; Mouser Part Number 710-632723300011
R2201, R2202, R2205: 10k/0603; R_0603_1608Metric
R2203: 100/0603; R_0603_1608Metric
R2204: 22/0603; R_0603_1608Metric
R2206: 1M/0603; R_0603_1608Metric
U2201: IMC_1550_20PM_w_Adapter_PCB; Modulator_horizontal_HF_R
U2202: IMC_1550_20PM_w_Adapter_PCB; Modulator_horizontal_HF_L

Connections:
+3V3: D2201.2 (A), D2202.2 (A), J2207.A1, J2207.A9, J2207.A10, J2207.B8, J2207.B10, R2201.1, R2202.1
+5V: C2201.1, C2202.1, J2208.A4 (VBUS), J2208.A9 (VBUS_2), J2208.B4 (VBUS_3), J2208.B9 (VBUS_4)
+12V: J2207.A2, J2207.A3, J2207.B1, J2207.B2, J2207.B3
FPGA_I2C_SCL: J2207.B5, J2208.A7 (DN1), J2208.B7 (DN2)
FPGA_I2C_SDA: J2207.B6, J2208.A6 (DP1), J2208.B6 (DP2)
FPGA_USBC_CC1: J2208.B5 (CC2), R2202.2, R2204.2
FPGA_USBC_CC2: J2208.A5 (CC1), R2201.2, R2203.1
GND: C2201.2, C2202.2, C2203.2, C2204.2, J2201.1, J2204.1, J2207.A4, J2207.A12, J2207.A15, J2207.A18, J2207.B4, J2207.B7, J2207.B13, J2207.B16, J2207.B18, J2208.1 (GND), J2208.2 (GND_2), J2208.A1 (GND_3), J2208.A12 (GND_4), J2208.B1 (GND_5), J2208.B12 (GND_6), R2205.2, R2206.2, U2201.4 (GND), U2201.6, U2202.4 (GND), U2202.6
GND_SHD: C2203.1, C2204.1, J2208.3 (SHIELD), J2208.4, J2208.5, J2208.6, J2208.7, J2208.8, R2206.1
GTP_PCIE_RX_N: J2207.A17
GTP_PCIE_RX_P: J2207.A16
GTP_PCIE_TX_N: J2207.B15
GTP_PCIE_TX_P: J2207.B14
GTP_REF_CLK_N: J2207.A14
GTP_REF_CLK_P: J2207.A13
GTP_USBC_RX0_N: J2208.B10 (SSRXN1)
GTP_USBC_RX0_P: J2208.B11 (SSRXP1)
GTP_USBC_RX1_N: J2208.A3 (SSTXN1)
GTP_USBC_RX1_P: J2208.A2 (SSTXP1)
GTP_USBC_TX0_N: J2208.B3 (SSTXN2)
GTP_USBC_TX0_P: J2208.B2 (SSTXP2)
GTP_USBC_TX1_N: J2208.A10 (SSRXN2)
GTP_USBC_TX1_P: J2208.A11 (SSRXP2)
HF_OUT_0: U2202.5
HF_OUT_1: U2201.5
MOD_BIAS_0: U2202.3 (BIAS)
MOD_BIAS_1: U2201.3 (BIAS)
unnamed: D2201.1 (K), R2203.2
unnamed: D2202.1 (K), R2204.1
PCIE_CARD_DETECT: J2207.B17, R2205.1
TTL_TRIGGER_0: J2201.2
TTL_TRIGGER_1: J2204.2

Notes on the sheet:
Bias-Anschlüsse für die opt. Modulatoren
PCIE x1-Connector Die Daten, GND und Versogungsleitungen entsprechen dem Standard. Keine PCIE-Verbindung, nur der Stecker!
TTL-Trigger-Eingänge
USB-C-Connector Nicht nach USB-Standard belegt!
HF-Ausgänge der Verstärker
PRSNT#1
PRSNT#2
Die Pinbelegung ist dem Layout angepasst. Nur USB-C-Stecker, kein USB-Protokoll
