ArneAlberts/Bachelorarbeit_Anhang/Schaltung_Layout/ethernet.sch

## KiCad design Schaltung_Layout/ethernet.sch (2021-09-20)

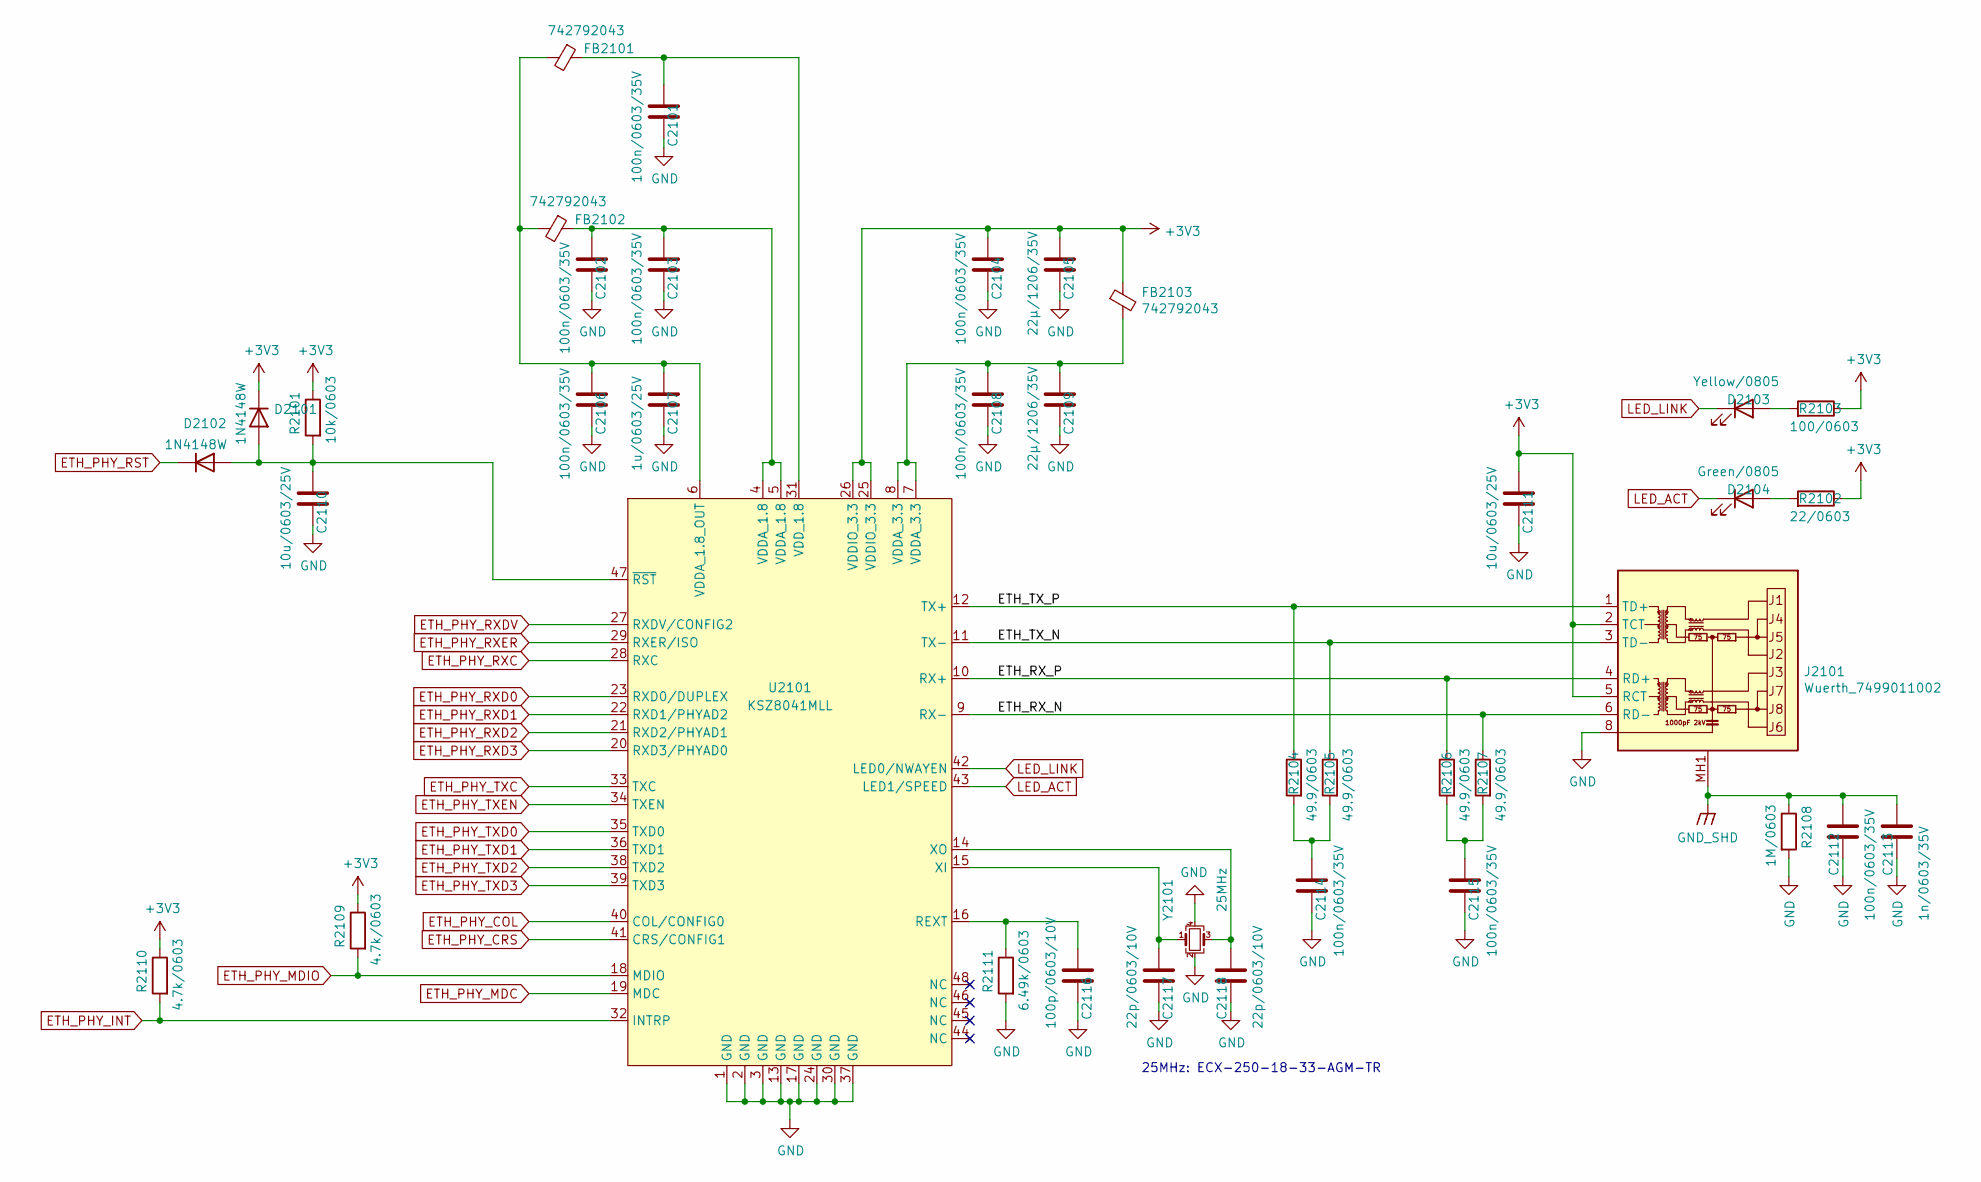
[picture p39: schematic ethernet.sch]

Parts:
C2101, C2102, C2103, C2104, C2106, C2108, C2112, C2114, C2115: 100n/0603/35V; C_0603_1608Metric
C2105, C2109: 22µ/1206/35V; C_1206_3216Metric
C2107: 1u/0603/25V; C_0603_1608Metric
C2110, C2111: 10u/0603/25V; C_0603_1608Metric
C2113: 1n/0603/35V; C_0603_1608Metric
C2116: 100p/0603/10V; C_0603_1608Metric
C2117, C2118: 22p/0603/10V; C_0603_1608Metric
D2101, D2102: 1N4148W; D_SOD-123
D2103: Yellow/0805; LED_0805_2012Metric
D2104: Green/0805; LED_0805_2012Metric
FB2101, FB2102, FB2103: 742792043; C_0805_2012Metric
J2101: Wuerth_7499011002; 7499011002
R2101: 10k/0603; R_0603_1608Metric
R2102: 22/0603; R_0603_1608Metric
R2103: 100/0603; R_0603_1608Metric
R2104, R2105, R2106, R2107: 49.9/0603; R_0603_1608Metric
R2108: 1M/0603; R_0603_1608Metric
R2109, R2110: 4.7k/0603; R_0603_1608Metric
R2111: 6.49k/0603; R_0603_1608Metric
U2101: KSZ8041MLL; LQFP-48_7x7mm_P0.5mm
Y2101: 25MHz; Crystal_SMD_3225-4Pin_3.2x2.5mm

Connections:
+3V3: C2104.1, C2105.1, C2111.1, D2101.1 (K), FB2103.1, J2101.2 (TCT), J2101.5 (RCT), R2101.1, R2102.1, R2103.1, R2109.1, R2110.1, U2101.25 (VDDIO_3.3), U2101.26 (VDDIO_3.3)
ETH_PHY_COL: U2101.40 (COL/CONFIG0)
ETH_PHY_CRS: U2101.41 (CRS/CONFIG1)
ETH_PHY_INT: R2110.2, U2101.32 (INTRP)
ETH_PHY_MDC: U2101.19 (MDC)
ETH_PHY_MDIO: R2109.2, U2101.18 (MDIO)
ETH_PHY_RST: D2102.1 (K)
ETH_PHY_RXC: U2101.28 (RXC)
ETH_PHY_RXD0: U2101.23 (RXD0/DUPLEX)
ETH_PHY_RXD1: U2101.22 (RXD1/PHYAD2)
ETH_PHY_RXD2: U2101.21 (RXD2/PHYAD1)
ETH_PHY_RXD3: U2101.20 (RXD3/PHYAD0)
ETH_PHY_RXDV: U2101.27 (RXDV/CONFIG2)
ETH_PHY_RXER: U2101.29 (RXER/ISO)
ETH_PHY_TXC: U2101.33 (TXC)
ETH_PHY_TXD0: U2101.35 (TXD0)
ETH_PHY_TXD1: U2101.36 (TXD1)
ETH_PHY_TXD2: U2101.38 (TXD2)
ETH_PHY_TXD3: U2101.39 (TXD3)
ETH_PHY_TXEN: U2101.34 (TXEN)
ETH_RX_N: J2101.6 (RD-), R2107.1, U2101.9 (RX-)
ETH_RX_P: J2101.4 (RD+), R2106.1, U2101.10 (RX+)
ETH_TX_N: J2101.3 (TD-), R2105.1, U2101.11 (TX-)
ETH_TX_P: J2101.1 (TD+), R2104.1, U2101.12 (TX+)
GND: C2101.2, C2102.2, C2103.2, C2104.2, C2105.2, C2106.2, C2107.2, C2108.2, C2109.2, C2110.2, C2111.2, C2112.2, C2113.2, C2114.2, C2115.2, C2116.2, C2117.2, C2118.2, J2101.8, R2108.2, R2111.2, U2101.1 (GND), U2101.2 (GND), U2101.3 (GND), U2101.13 (GND), U2101.17 (GND), U2101.24 (GND), U2101.30 (GND), U2101.37 (GND), Y2101.2, Y2101.4
GND_SHD: C2112.1, C2113.1, J2101.MH1, R2108.1
LED_ACT: D2104.1 (K), U2101.43 (LED1/SPEED)
LED_LINK: D2103.1 (K), U2101.42 (LED0/NWAYEN)
unnamed: C2101.1, FB2101.1, U2101.31 (VDD_1.8)
unnamed: C2102.1, C2103.1, FB2102.1, U2101.4 (VDDA_1.8), U2101.5 (VDDA_1.8)
unnamed: C2106.1, C2107.1, FB2101.2, FB2102.2, U2101.6 (VDDA_1.8_OUT)
unnamed: C2108.1, C2109.1, FB2103.2, U2101.7 (VDDA_3.3), U2101.8 (VDDA_3.3)
unnamed: C2110.1, D2101.2 (A), D2102.2 (A), R2101.2, U2101.47 (~RST)
unnamed: C2114.1, R2104.2, R2105.2
unnamed: C2115.1, R2106.2, R2107.2
unnamed: C2116.1, R2111.1, U2101.16 (REXT)
unnamed: C2117.1, U2101.15 (XI), Y2101.1
unnamed: C2118.1, U2101.14 (XO), Y2101.3
unnamed: D2103.2 (A), R2103.2
unnamed: D2104.2 (A), R2102.2

Notes on the sheet:
25MHz: ECX-250-18-33-AGM-TR
