ArneAlberts/Bachelorarbeit_Anhang/Schaltung_Layout/hf_out.sch

## KiCad design Schaltung_Layout/hf_out.sch (2021-09-20)

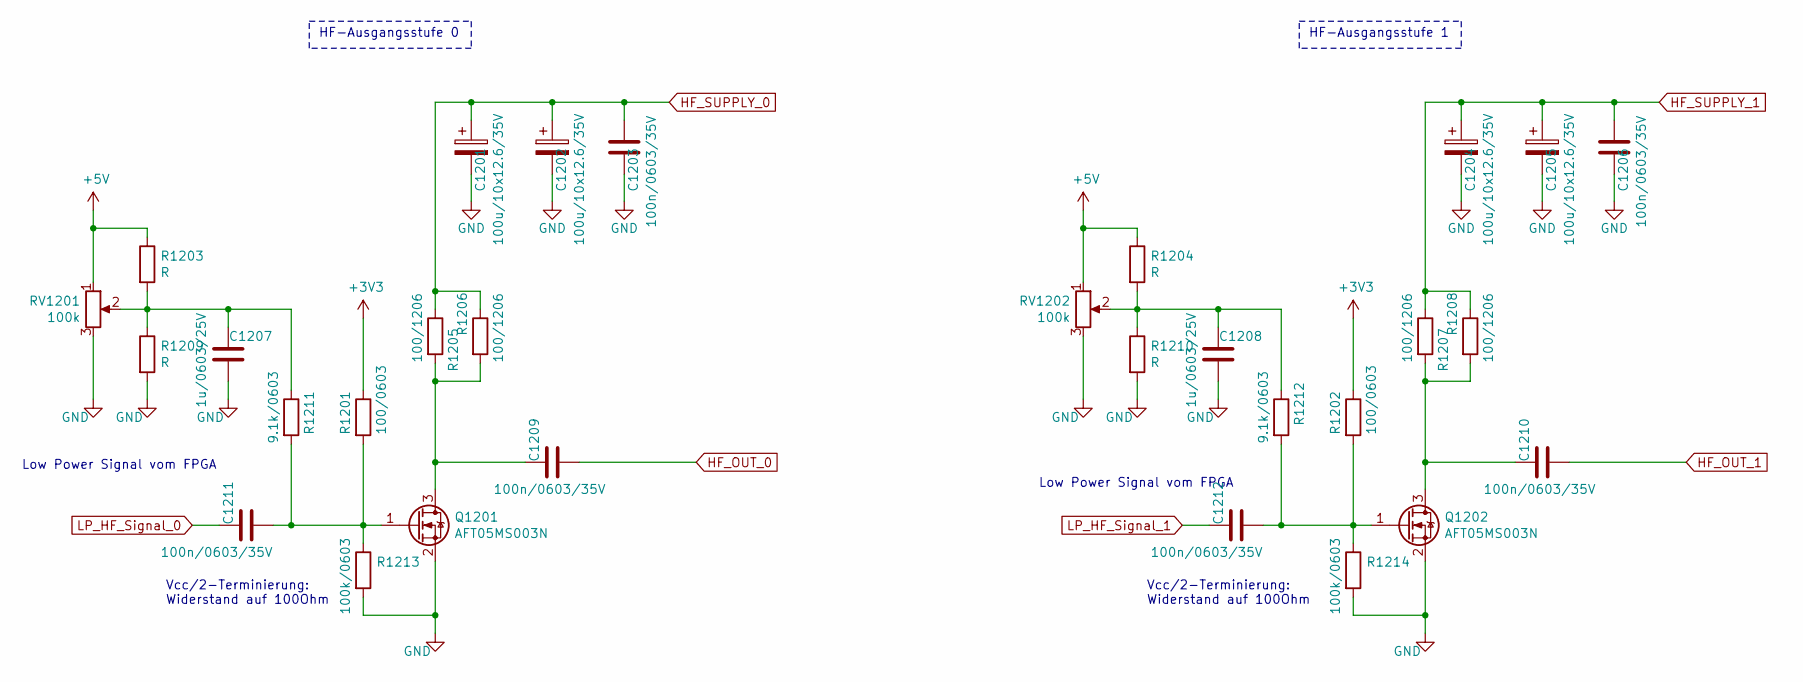
[picture p40: schematic hf_out.sch]

Parts:
C1201, C1202, C1204, C1205: 100u/10x12.6/35V; CP_Elec_10x12.6
C1203, C1206, C1209, C1210, C1211, C1212: 100n/0603/35V; C_0603_1608Metric
C1207, C1208: 1u/0603/25V; C_0603_1608Metric
Q1201, Q1202: AFT05MS003N; SOT-89-3
R1201, R1202: 100/0603; R_0603_1608Metric
R1203, R1204, R1209, R1210: R; R_0603_1608Metric
R1205, R1206, R1207, R1208: 100/1206; R_1206_3216Metric
R1211, R1212: 9.1k/0603; R_0603_1608Metric
R1213, R1214: 100k/0603; R_0603_1608Metric
RV1201, RV1202: 100k; Potentiometer_Bourns_3296W_Vertical

Connections:
+3V3: R1201.1, R1202.1
+5V: R1203.1, R1204.1, RV1201.1, RV1202.1
GND: C1201.2, C1202.2, C1203.2, C1204.2, C1205.2, C1206.2, C1207.2, C1208.2, Q1201.2 (S), Q1202.2 (S), R1209.2, R1210.2, R1213.2, R1214.2, RV1201.3, RV1202.3
HF_OUT_0: C1209.2
HF_OUT_1: C1210.2
HF_SUPPLY_0: C1201.1, C1202.1, C1203.1, R1205.1, R1206.1
HF_SUPPLY_1: C1204.1, C1205.1, C1206.1, R1207.1, R1208.1
LP_HF_Signal_0: C1211.1
LP_HF_Signal_1: C1212.1
unnamed: C1207.1, R1203.2, R1209.1, R1211.1, RV1201.2
unnamed: C1208.1, R1204.2, R1210.1, R1212.1, RV1202.2
unnamed: C1209.1, Q1201.3 (D), R1205.2, R1206.2
unnamed: C1210.1, Q1202.3 (D), R1207.2, R1208.2
unnamed: C1211.2, Q1201.1 (G), R1201.2, R1211.2, R1213.1
unnamed: C1212.2, Q1202.1 (G), R1202.2, R1212.2, R1214.1

Notes on the sheet:
Low Power Signal vom FPGA
HF-Ausgangsstufe 0
HF-Ausgangsstufe 1
Vcc/2-Terminierung: Widerstand auf 100Ohm
