ArneAlberts/Bachelorarbeit_Anhang/Schaltung_Layout/memory.sch

## KiCad design Schaltung_Layout/memory.sch (2021-09-20)

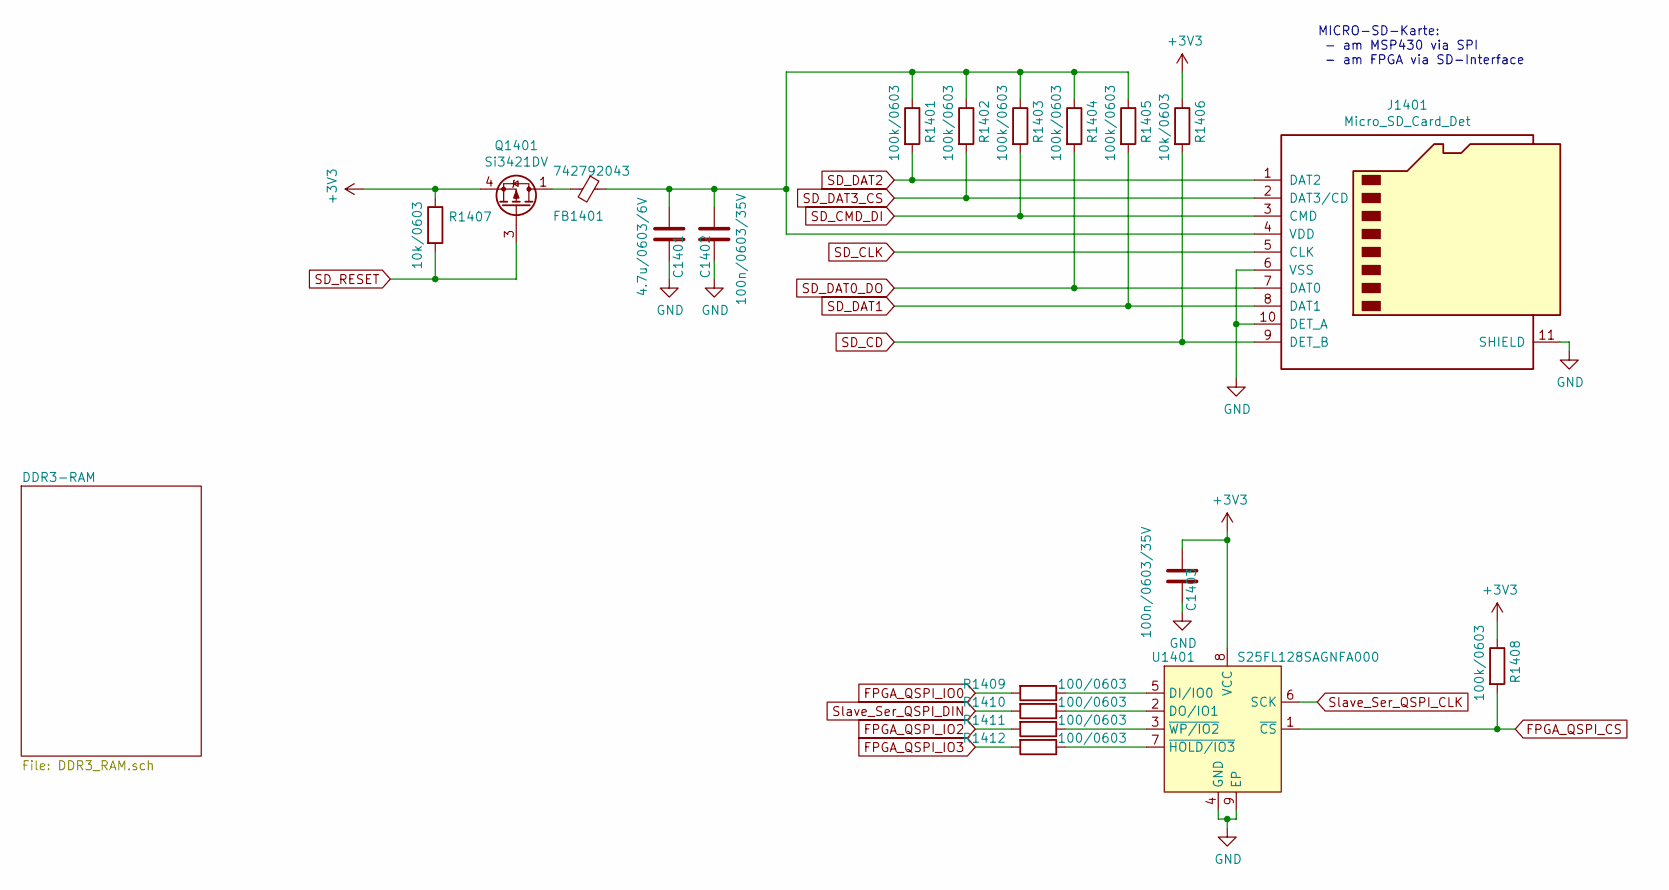
[picture p41: schematic memory.sch]

Parts:
C1401: 4.7u/0603/6V; C_0603_1608Metric
C1402, C1403: 100n/0603/35V; C_0603_1608Metric
FB1401: 742792043; C_0805_2012Metric
J1401: Micro_SD_Card_Det; microSD_HC_Hirose_DM3AT-SF-PEJM5
Q1401: Si3421DV; TSOP-6_Si3421
R1401, R1402, R1403, R1404, R1405, R1408: 100k/0603; R_0603_1608Metric
R1406, R1407: 10k/0603; R_0603_1608Metric
R1409, R1410, R1411, R1412: 100/0603; R_0603_1608Metric
U1401: S25FL128SAGNFA000; WSON-8-1EP_8x6mm_P1.27mm_EP4.65x4.8mm

Connections:
+3V3: C1403.1, Q1401.4 (S), R1406.1, R1407.1, R1408.1, U1401.8 (VCC)
FPGA_QSPI_CS: R1408.2, U1401.1 (~CS)
FPGA_QSPI_IO0: R1409.2
FPGA_QSPI_IO2: R1411.2
FPGA_QSPI_IO3: R1412.2
GND: C1401.2, C1402.2, C1403.2, J1401.6 (VSS), J1401.10 (DET_A), J1401.11 (SHIELD), U1401.4 (GND), U1401.9 (EP)
unnamed: C1401.1, C1402.1, FB1401.1, J1401.4 (VDD), R1401.1, R1402.1, R1403.1, R1404.1, R1405.1
unnamed: FB1401.2, Q1401.1 (D)
unnamed: R1409.1, U1401.5 (DI/IO0)
unnamed: R1410.1, U1401.2 (DO/IO1)
unnamed: R1411.1, U1401.3 (~WP/IO2)
unnamed: R1412.1, U1401.7 (~HOLD/IO3)
SD_CD: J1401.9 (DET_B), R1406.2
SD_CLK: J1401.5 (CLK)
SD_CMD_DI: J1401.3 (CMD), R1403.2
SD_DAT0_DO: J1401.7 (DAT0), R1404.2
SD_DAT1: J1401.8 (DAT1), R1405.2
SD_DAT2: J1401.1 (DAT2), R1401.2
SD_DAT3_CS: J1401.2 (DAT3/CD), R1402.2
SD_RESET: Q1401.3 (G), R1407.2
Slave_Ser_QSPI_CLK: U1401.6 (SCK)
Slave_Ser_QSPI_DIN: R1410.2

Notes on the sheet:
MICRO-SD-Karte: - am MSP430 via SPI - am FPGA via SD-Interface
