ArneAlberts/Bachelorarbeit_Anhang/Schaltung_Layout/msp430.sch

## KiCad design Schaltung_Layout/msp430.sch (2021-09-20)

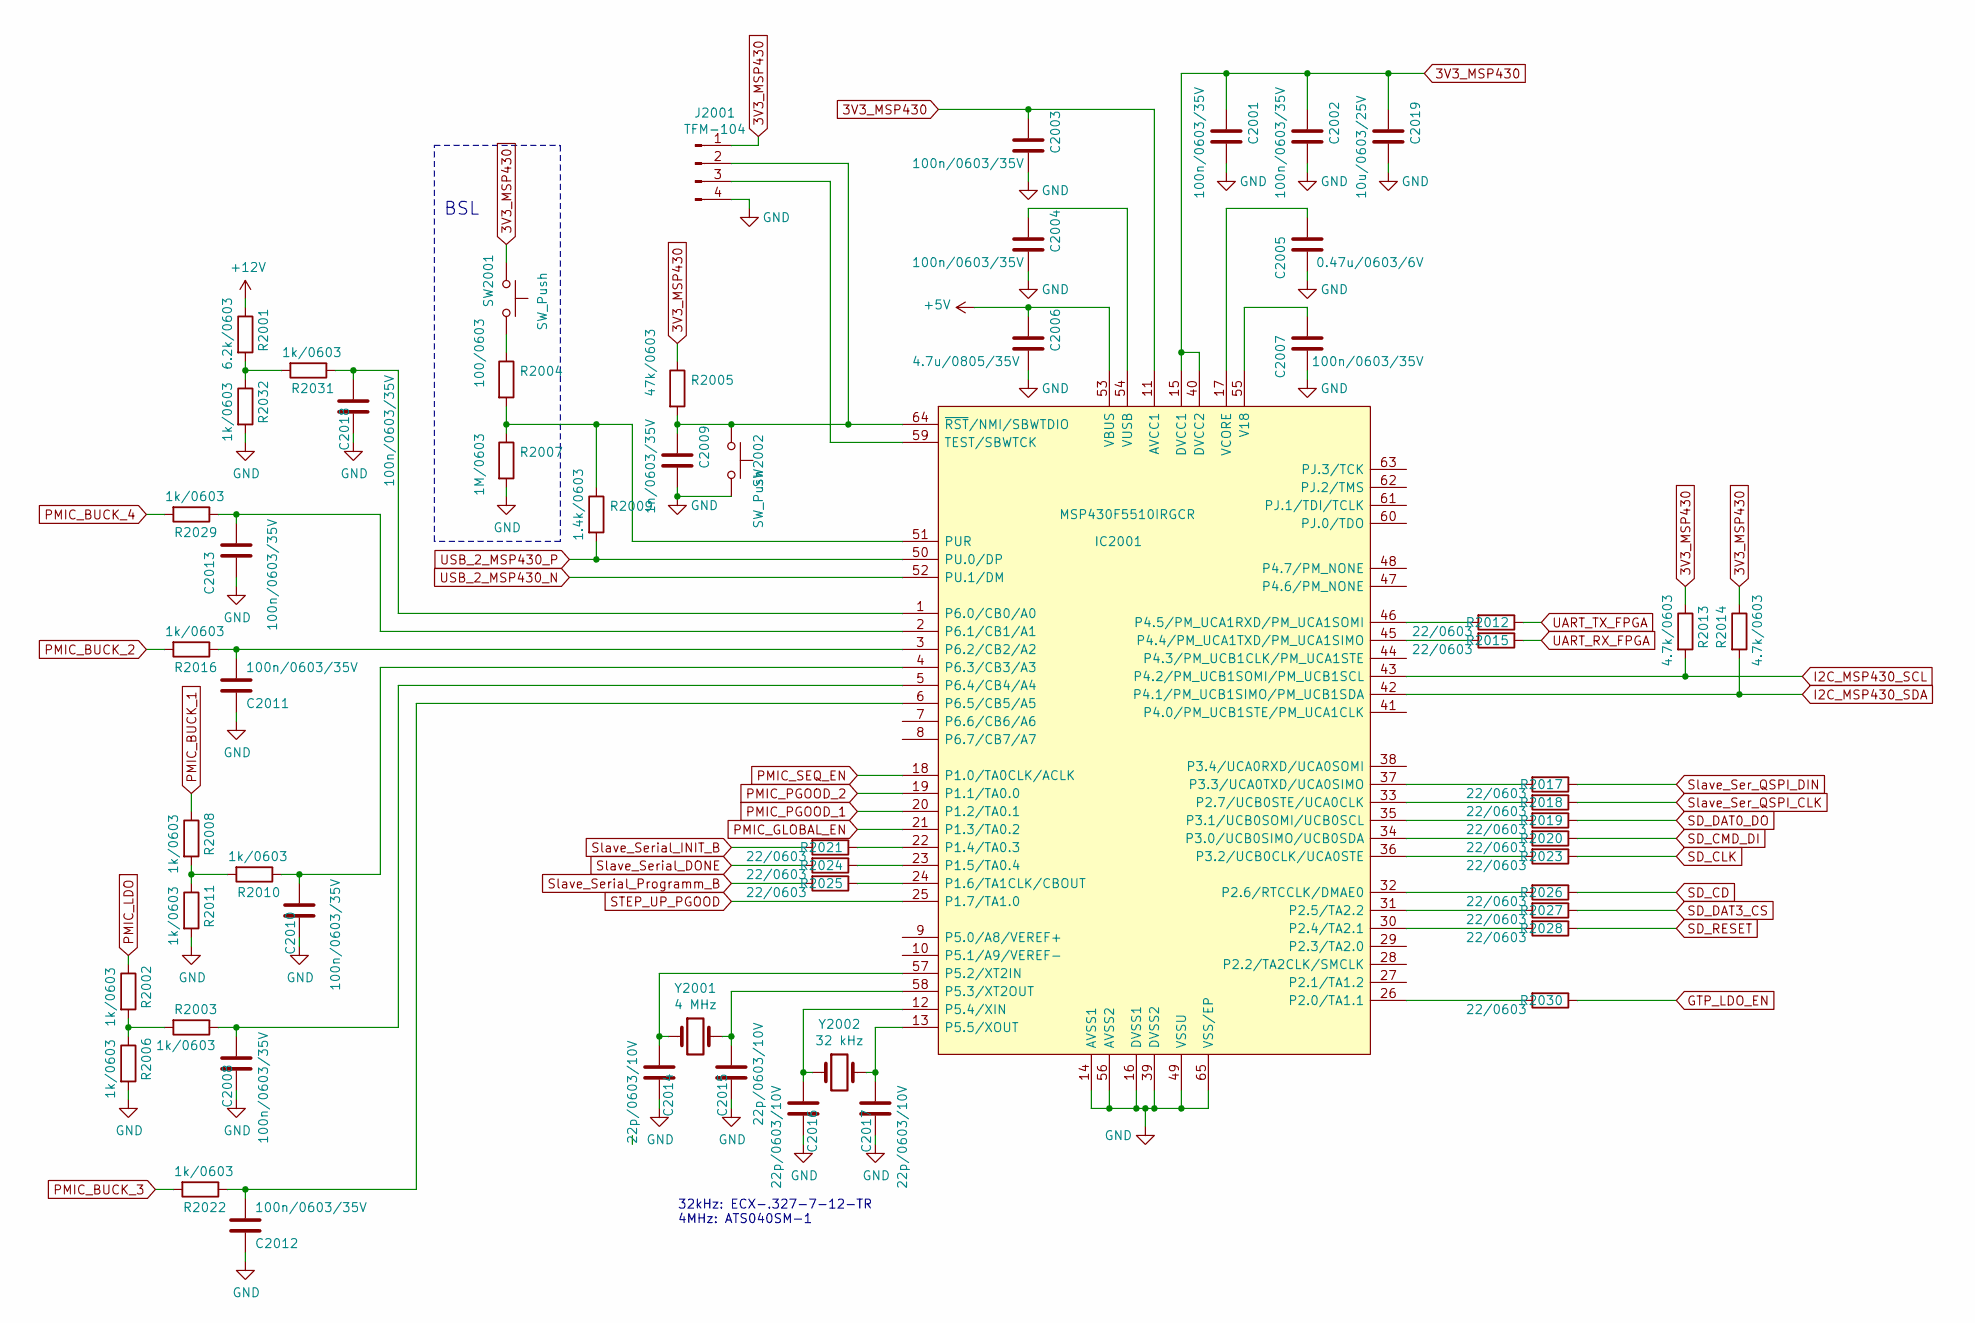
[picture p42: schematic msp430.sch]

Parts:
C2001, C2002, C2003, C2004, C2007, C2008, C2010, C2011, C2012, C2013, C2018: 100n/0603/35V; C_0603_1608Metric
C2005: 0.47u/0603/6V; C_0603_1608Metric
C2006: 4.7u/0805/35V; C_0805_2012Metric
C2009: 1n/0603/35V; C_0603_1608Metric
C2014, C2015, C2016, C2017: 22p/0603/10V; C_0603_1608Metric
C2019: 10u/0603/25V; C_0603_1608Metric
IC2001: MSP430F5510IRGCR; QFN50P900X900X100-65N-D; Mouser Part Number 595-MSP430F5510IRGCR
J2001: TFM-104; PinHeader_1x04_P1.27mm_Horizontal
R2001: 6.2k/0603; R_0603_1608Metric
R2002, R2003, R2006, R2008, R2010, R2011, R2016, R2022, R2029, R2031, R2032: 1k/0603; R_0603_1608Metric
R2004: 100/0603; R_0603_1608Metric
R2005: 47k/0603; R_0603_1608Metric
R2007: 1M/0603; R_0603_1608Metric
R2009: 1.4k/0603; R_0603_1608Metric
R2012, R2015, R2017, R2018, R2019, R2020, R2021, R2023, R2024, R2025, R2026, R2027, R2028, R2030: 22/0603; R_0603_1608Metric
R2013, R2014: 4.7k/0603; R_0603_1608Metric
SW2001, SW2002: SW_Push; SW_SPST_B3U-1100P-B
Y2001: 4 MHz; Crystal_SMD_HC49-SD
Y2002: 32 kHz; Crystal_SMD_2012-2Pin_2.0x1.2mm_HandSoldering

Connections:
3V3_MSP430: C2001.2, C2002.2, C2003.2, C2019.1, IC2001.11 (AVCC1), IC2001.15 (DVCC1), IC2001.40 (DVCC2), J2001.1, R2005.1, R2013.1, R2014.1, SW2001.1
+5V: C2006.2, IC2001.53 (VBUS)
+12V: R2001.1
GND: C2001.1, C2002.1, C2003.1, C2004.1, C2005.2, C2006.1, C2007.2, C2008.1, C2009.1, C2010.1, C2011.1, C2012.1, C2013.1, C2014.2, C2015.2, C2016.2, C2017.2, C2018.1, C2019.2, IC2001.14 (AVSS1), IC2001.16 (DVSS1), IC2001.39 (DVSS2), IC2001.49 (VSSU), IC2001.56 (AVSS2), IC2001.65 (VSS/EP), J2001.4, R2006.2, R2007.2, R2011.2, R2032.2, SW2002.2
GTP_LDO_EN: R2030.1
I2C_MSP430_SCL: IC2001.43 (P4.2/PM_UCB1SOMI/PM_UCB1SCL), R2013.2
I2C_MSP430_SDA: IC2001.42 (P4.1/PM_UCB1SIMO/PM_UCB1SDA), R2014.2
unnamed: C2004.2, IC2001.54 (VUSB)
unnamed: C2005.1, IC2001.17 (VCORE)
unnamed: C2007.1, IC2001.55 (V18)
unnamed: C2008.2, IC2001.5 (P6.4/CB4/A4), R2003.1
unnamed: C2009.2, IC2001.64 (~RST~/NMI/SBWTDIO), J2001.2, R2005.2, SW2002.1
unnamed: C2010.2, IC2001.4 (P6.3/CB3/A3), R2010.1
unnamed: C2011.2, IC2001.3 (P6.2/CB2/A2), R2016.1
unnamed: C2012.2, IC2001.6 (P6.5/CB5/A5), R2022.1
unnamed: C2013.2, IC2001.2 (P6.1/CB1/A1), R2029.1
unnamed: C2014.1, IC2001.57 (P5.2/XT2IN), Y2001.1
unnamed: C2015.1, IC2001.58 (P5.3/XT2OUT), Y2001.2
unnamed: C2016.1, IC2001.12 (P5.4/XIN), Y2002.1
unnamed: C2017.1, IC2001.13 (P5.5/XOUT), Y2002.2
unnamed: C2018.2, IC2001.1 (P6.0/CB0/A0), R2031.1
unnamed: IC2001.22 (P1.4/TA0.3), R2021.1
unnamed: IC2001.23 (P1.5/TA0.4), R2024.1
unnamed: IC2001.24 (P1.6/TA1CLK/CBOUT), R2025.1
unnamed: IC2001.26 (P2.0/TA1.1), R2030.2
unnamed: IC2001.30 (P2.4/TA2.1), R2028.2
unnamed: IC2001.31 (P2.5/TA2.2), R2027.2
unnamed: IC2001.32 (P2.6/RTCCLK/DMAE0), R2026.2
unnamed: IC2001.33 (P2.7/UCB0STE/UCA0CLK), R2018.2
unnamed: IC2001.34 (P3.0/UCB0SIMO/UCB0SDA), R2020.2
unnamed: IC2001.35 (P3.1/UCB0SOMI/UCB0SCL), R2019.2
unnamed: IC2001.36 (P3.2/UCB0CLK/UCA0STE), R2023.2
unnamed: IC2001.37 (P3.3/UCA0TXD/UCA0SIMO), R2017.2
unnamed: IC2001.45 (P4.4/PM_UCA1TXD/PM_UCA1SIMO), R2015.2
unnamed: IC2001.46 (P4.5/PM_UCA1RXD/PM_UCA1SOMI), R2012.2
unnamed: IC2001.51 (PUR), R2004.2, R2007.1, R2009.1
unnamed: IC2001.59 (TEST/SBWTCK), J2001.3
unnamed: R2001.2, R2031.2, R2032.1
unnamed: R2002.2, R2003.2, R2006.1
unnamed: R2004.1, SW2001.2
unnamed: R2008.2, R2010.2, R2011.1
PMIC_BUCK_1: R2008.1
PMIC_BUCK_2: R2016.2
PMIC_BUCK_3: R2022.2
PMIC_BUCK_4: R2029.2
PMIC_GLOBAL_EN: IC2001.21 (P1.3/TA0.2)
PMIC_LDO: R2002.1
PMIC_PGOOD_1: IC2001.20 (P1.2/TA0.1)
PMIC_PGOOD_2: IC2001.19 (P1.1/TA0.0)
PMIC_SEQ_EN: IC2001.18 (P1.0/TA0CLK/ACLK)
SD_CD: R2026.1
SD_CLK: R2023.1
SD_CMD_DI: R2020.1
SD_DAT0_DO: R2019.1
SD_DAT3_CS: R2027.1
SD_RESET: R2028.1
STEP_UP_PGOOD: IC2001.25 (P1.7/TA1.0)
Slave_Ser_QSPI_CLK: R2018.1
Slave_Ser_QSPI_DIN: R2017.1
Slave_Serial_DONE: R2024.2
Slave_Serial_INIT_B: R2021.2
Slave_Serial_Programm_B: R2025.2
UART_RX_FPGA: R2015.1
UART_TX_FPGA: R2012.1
USB_2_MSP430_N: IC2001.52 (PU.1/DM)
USB_2_MSP430_P: IC2001.50 (PU.0/DP), R2009.2

Notes on the sheet:
BSL
32kHz: ECX-.327-7-12-TR 4MHz: ATS040SM-1
