ArneAlberts/Bachelorarbeit_Anhang/Schaltung_Layout/power_supply.sch

## KiCad design Schaltung_Layout/power_supply.sch (2021-09-20)

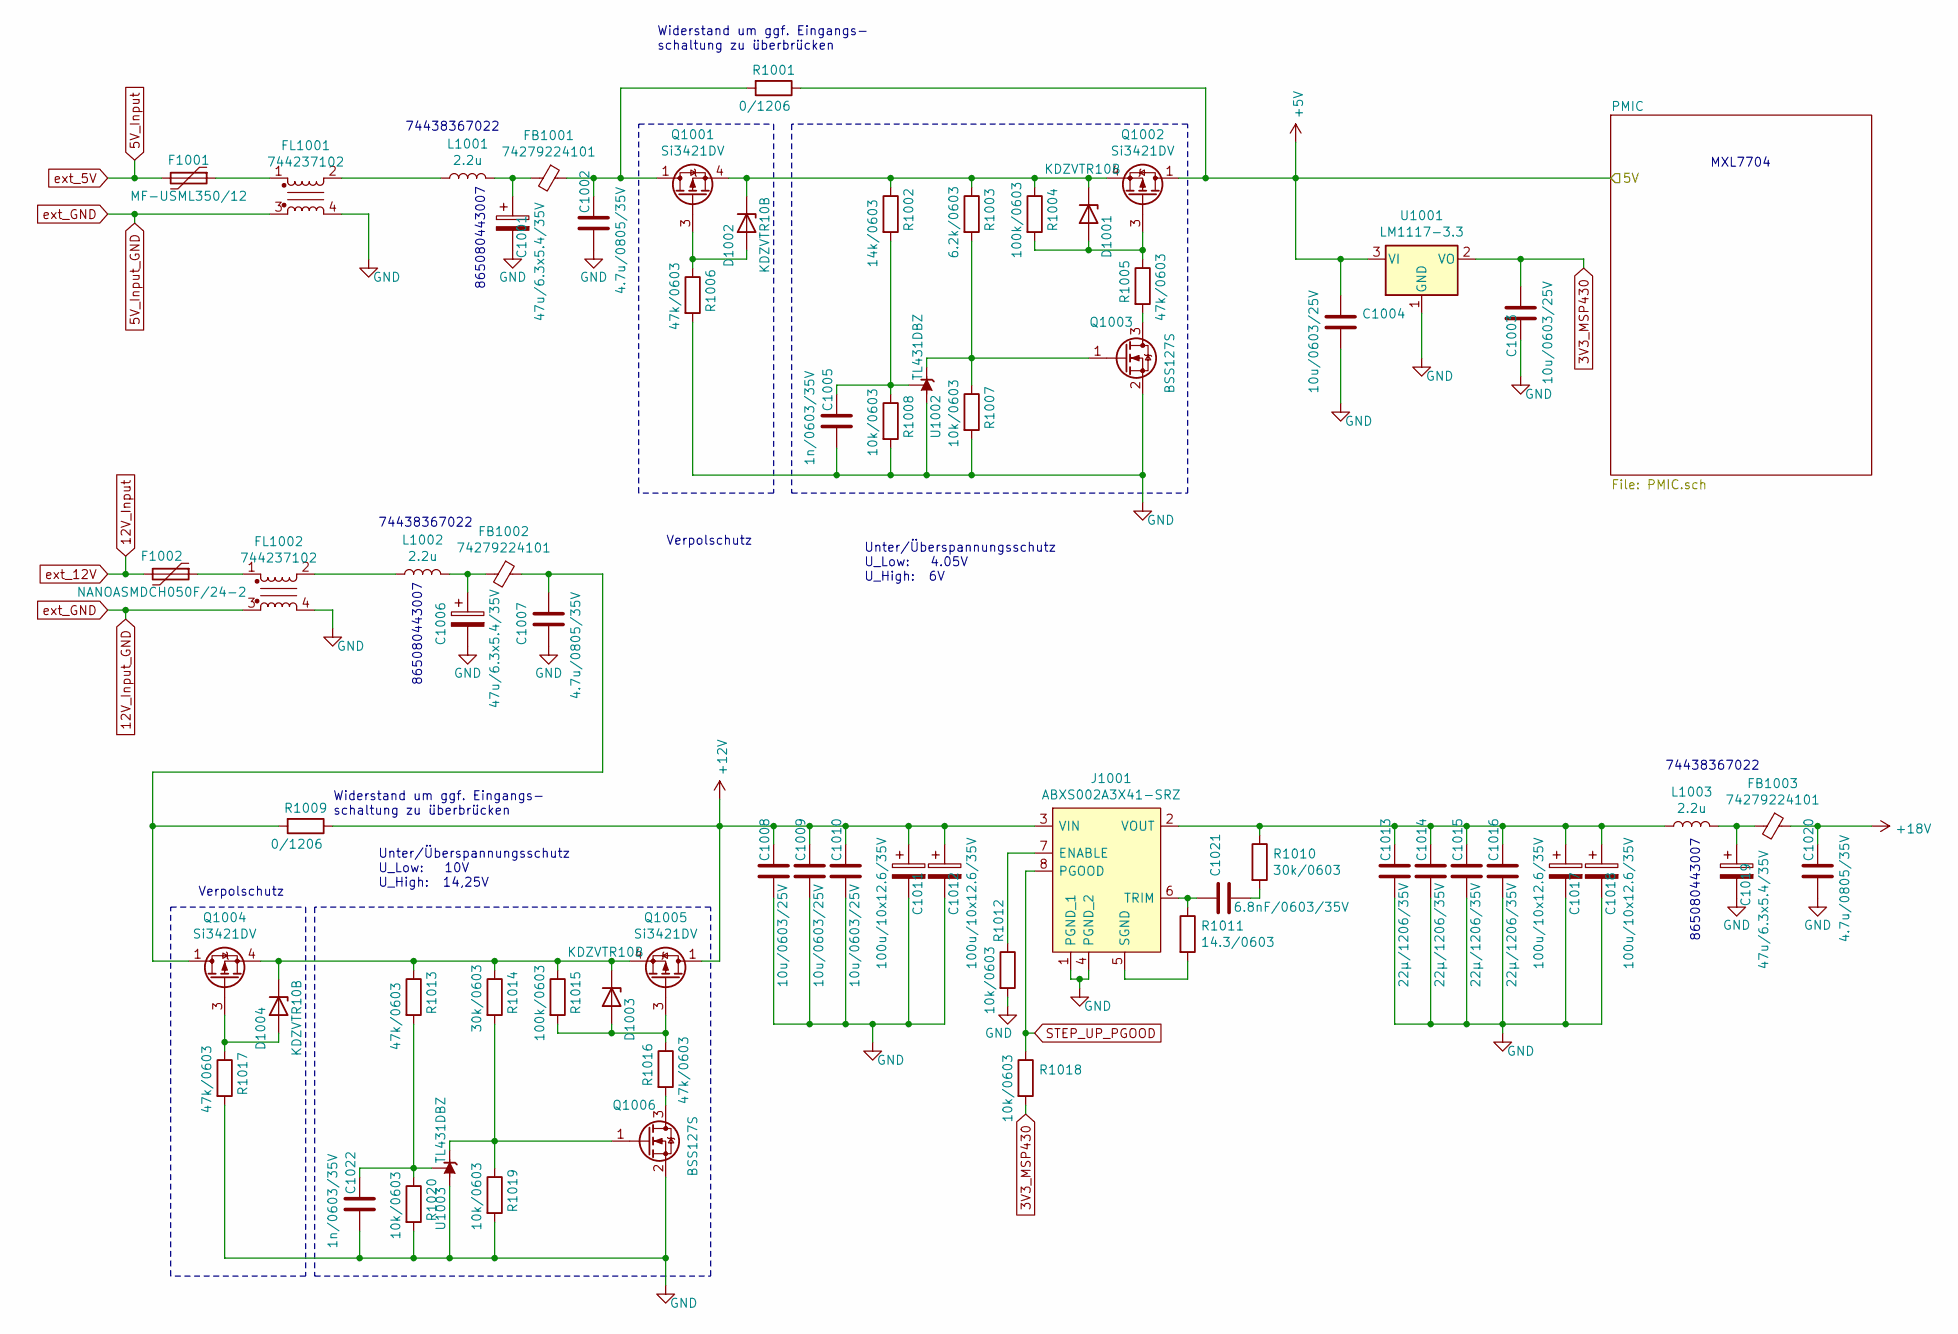
[picture p43: schematic power_supply.sch]

Parts:
C1001, C1006, C1019: 47u/6.3x5.4/35V; CP_Elec_6.3x5.4
C1002, C1007, C1020: 4.7u/0805/35V; C_0805_2012Metric
C1003, C1004, C1008, C1009, C1010: 10u/0603/25V; C_0603_1608Metric
C1005, C1022: 1n/0603/35V; C_0603_1608Metric
C1011, C1012, C1017, C1018: 100u/10x12.6/35V; CP_Elec_10x12.6
C1013, C1014, C1015, C1016: 22µ/1206/35V; C_1206_3216Metric
C1021: 6.8nF/0603/35V; C_0603_1608Metric
D1001, D1002, D1003, D1004: KDZVTR10B; D_SOD-123F
F1001: MF-USML350/12; Fuse_1210_3225Metric
F1002: NANOASMDCH050F/24-2; Fuse_1206_3216Metric
FB1001, FB1002, FB1003: 74279224101; C_2220_5650Metric
FL1001, FL1002: 744237102
J1001: ABXS002A3X41-SRZ; ABXS002A3X41SRZ; Manufacturer_Part_Number ABXS002A3X41-SRZ
L1001, L1002, L1003: 2.2u; L_Wuerth_MAPI-5030
Q1001, Q1002, Q1004, Q1005: Si3421DV; TSOP-6_Si3421
Q1003, Q1006: BSS127S; SOT-23
R1001, R1009: 0/1206; R_1206_3216Metric
R1002: 14k/0603; R_0603_1608Metric
R1003: 6.2k/0603; R_0603_1608Metric
R1004, R1015: 100k/0603; R_0603_1608Metric
R1005, R1006, R1013, R1016, R1017: 47k/0603; R_0603_1608Metric
R1007, R1008, R1012, R1018, R1019, R1020: 10k/0603; R_0603_1608Metric
R1010, R1014: 30k/0603; R_0603_1608Metric
R1011: 14.3/0603; R_0603_1608Metric
U1001: LM1117-3.3; SOT-223-3_TabPin2
U1002, U1003: TL431DBZ; SOT-23

Connections:
3V3_MSP430: C1003.1, R1018.2, U1001.2 (VO)
5V_Input: F1001.2
12V_Input: F1002.2
12V_Input_GND: FL1001.3, FL1002.3
+5V: C1004.1, Q1002.1 (D), R1001.1, U1001.3 (VI)
+12V: C1008.1, C1009.1, C1010.1, C1011.1, C1012.1, J1001.3 (VIN), Q1005.1 (D), R1009.1
+18V: C1020.1, FB1003.1
GND: C1001.2, C1002.2, C1003.2, C1004.2, C1005.2, C1006.2, C1007.2, C1008.2, C1009.2, C1010.2, C1011.2, C1012.2, C1013.2, C1014.2, C1015.2, C1016.2, C1017.2, C1018.2, C1019.2, C1020.2, C1022.2, FL1001.4, FL1002.4, J1001.1 (PGND_1), J1001.4 (PGND_2), Q1003.2 (S), Q1006.2 (S), R1006.2, R1007.2, R1008.2, R1012.2, R1017.2, R1019.2, R1020.2, U1001.1 (GND), U1002.3 (A), U1003.3 (A)
unnamed: C1001.1, FB1001.2, L1001.2
unnamed: C1002.1, FB1001.1, Q1001.1 (D), R1001.2
unnamed: C1005.1, R1002.2, R1008.1, U1002.2 (REF)
unnamed: C1006.1, FB1002.2, L1002.2
unnamed: C1007.1, FB1002.1, Q1004.1 (D), R1009.2
unnamed: C1013.1, C1014.1, C1015.1, C1016.1, C1017.1, C1018.1, J1001.2 (VOUT), L1003.1, R1010.1
unnamed: C1019.1, FB1003.2, L1003.2
unnamed: C1021.1, J1001.6 (TRIM), R1011.1
unnamed: C1021.2, R1010.2
unnamed: C1022.1, R1013.2, R1020.1, U1003.2 (REF)
unnamed: D1001.1 (K), D1002.1 (K), Q1001.4 (S), Q1002.4 (S), R1002.1, R1003.1, R1004.1
unnamed: D1001.2 (A), Q1002.3 (G), R1004.2, R1005.1
unnamed: D1002.2 (A), Q1001.3 (G), R1006.1
unnamed: D1003.1 (K), D1004.1 (K), Q1004.4 (S), Q1005.4 (S), R1013.1, R1014.1, R1015.1
unnamed: D1003.2 (A), Q1005.3 (G), R1015.2, R1016.1
unnamed: D1004.2 (A), Q1004.3 (G), R1017.1
unnamed: F1001.1, FL1001.1
unnamed: F1002.1, FL1002.1
unnamed: FL1001.2, L1001.1
unnamed: FL1002.2, L1002.1
unnamed: J1001.5 (SGND), R1011.2
unnamed: J1001.7 (ENABLE), R1012.1
unnamed: Q1003.1 (G), R1003.2, R1007.1, U1002.1 (K)
unnamed: Q1003.3 (D), R1005.2
unnamed: Q1006.1 (G), R1014.2, R1019.1, U1003.1 (K)
unnamed: Q1006.3 (D), R1016.2
STEP_UP_PGOOD: J1001.8 (PGOOD), R1018.1

Notes on the sheet:
MXL7704
Unter/Überspannungsschutz U_Low: 10V U_High: 14,25V
Verpolschutz
Unter/Überspannungsschutz U_Low: 4.05V U_High: 6V
Widerstand um ggf. Eingangs- schaltung zu überbrücken
865080443007
74438367022
