ArneAlberts/Bachelorarbeit_Anhang/Schaltung_Layout/test_points.sch

## KiCad design Schaltung_Layout/test_points.sch (2021-09-20)

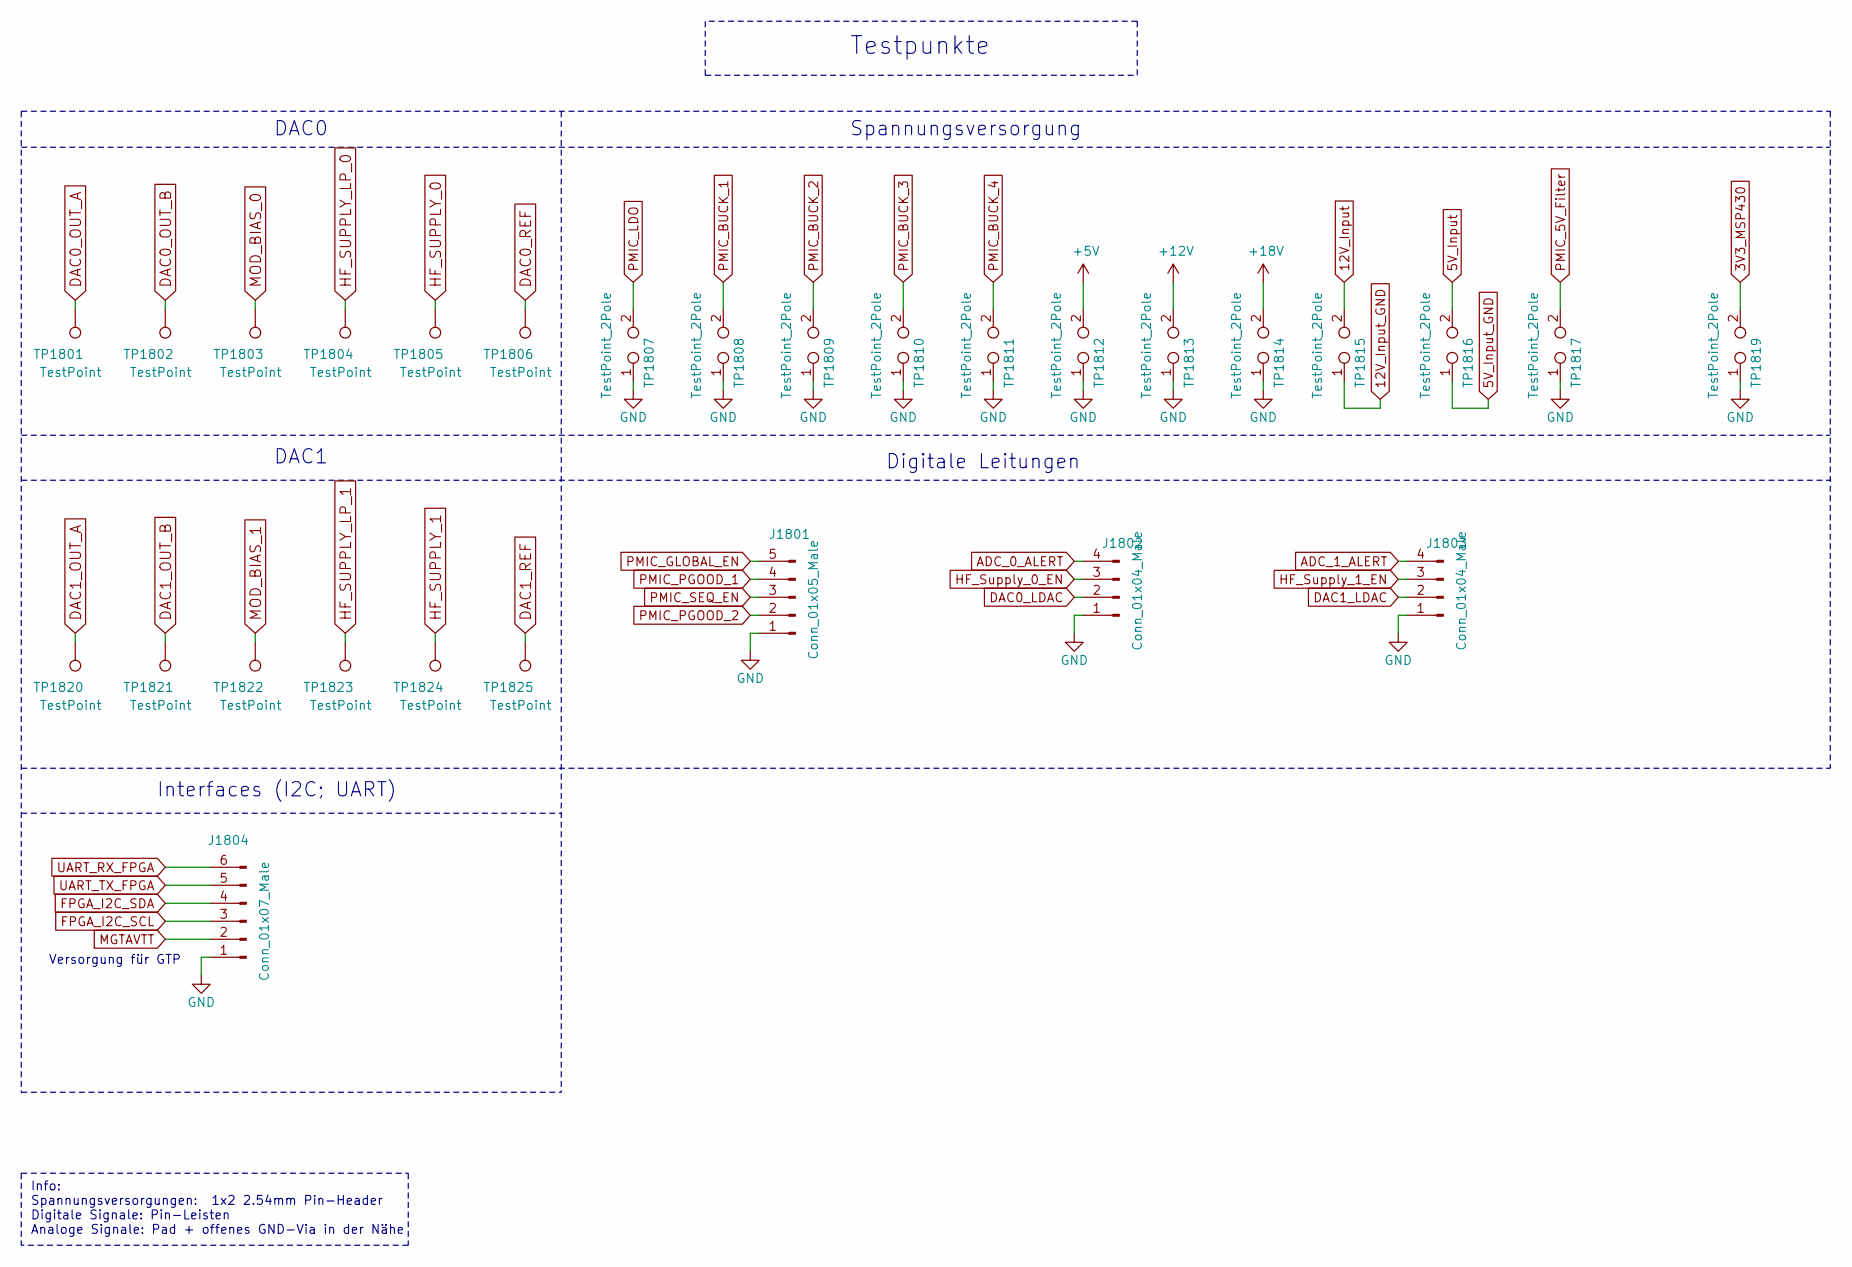
[picture p44: schematic test_points.sch]

Parts:
J1801: Conn_01x05_Male; PinHeader_1x05_P2.54mm_Vertical
J1802, J1803: Conn_01x04_Male; PinHeader_1x04_P2.54mm_Vertical
J1804: Conn_01x07_Male; PinHeader_2x03_P2.54mm_Vertical
TP1801, TP1802, TP1803, TP1804, TP1805, TP1806, TP1820, TP1821, TP1822, TP1823, TP1824, TP1825: TestPoint; TestPoint_Pad_D1.5mm
TP1807, TP1808, TP1809, TP1810, TP1811, TP1812, TP1813, TP1814, TP1815, TP1816, TP1817, TP1819: TestPoint_2Pole; PinHeader_1x02_P2.54mm_Vertical

Connections:
3V3_MSP430: TP1819.2
5V_Input: TP1816.2
5V_Input_GND: TP1816.1
12V_Input: TP1815.2
12V_Input_GND: TP1815.1
+5V: TP1812.2
+12V: TP1813.2
+18V: TP1814.2
ADC_0_ALERT: J1802.4
ADC_1_ALERT: J1803.4
DAC0_LDAC: J1802.2
DAC0_OUT_A: TP1801.1
DAC0_OUT_B: TP1802.1
DAC0_REF: TP1806.1
DAC1_LDAC: J1803.2
DAC1_OUT_A: TP1820.1
DAC1_OUT_B: TP1821.1
DAC1_REF: TP1825.1
FPGA_I2C_SCL: J1804.3
FPGA_I2C_SDA: J1804.4
GND: J1801.1, J1802.1, J1803.1, J1804.1, TP1807.1, TP1808.1, TP1809.1, TP1810.1, TP1811.1, TP1812.1, TP1813.1, TP1814.1, TP1817.1, TP1819.1
HF_SUPPLY_0: TP1805.1
HF_SUPPLY_1: TP1824.1
HF_SUPPLY_LP_0: TP1804.1
HF_SUPPLY_LP_1: TP1823.1
HF_Supply_0_EN: J1802.3
HF_Supply_1_EN: J1803.3
MGTAVTT: J1804.2
MOD_BIAS_0: TP1803.1
MOD_BIAS_1: TP1822.1
PMIC_5V_Filter: TP1817.2
PMIC_BUCK_1: TP1808.2
PMIC_BUCK_2: TP1809.2
PMIC_BUCK_3: TP1810.2
PMIC_BUCK_4: TP1811.2
PMIC_GLOBAL_EN: J1801.5
PMIC_LDO: TP1807.2
PMIC_PGOOD_1: J1801.4
PMIC_PGOOD_2: J1801.2
PMIC_SEQ_EN: J1801.3
UART_RX_FPGA: J1804.6
UART_TX_FPGA: J1804.5

Notes on the sheet:
Testpunkte
DAC0
DAC1
Spannungsversorgung
Interfaces (I2C; UART)
Digitale Leitungen
Info: Spannungsversorgungen: 1x2 2.54mm Pin-Header Digitale Signale: Pin-Leisten Analoge Signale: Pad + offenes GND-Via in der Nähe
Versorgung für GTP
