ArneAlberts/Bachelorarbeit_Anhang/Schaltung_Layout/usb.sch

## KiCad design Schaltung_Layout/usb.sch (2021-09-20)

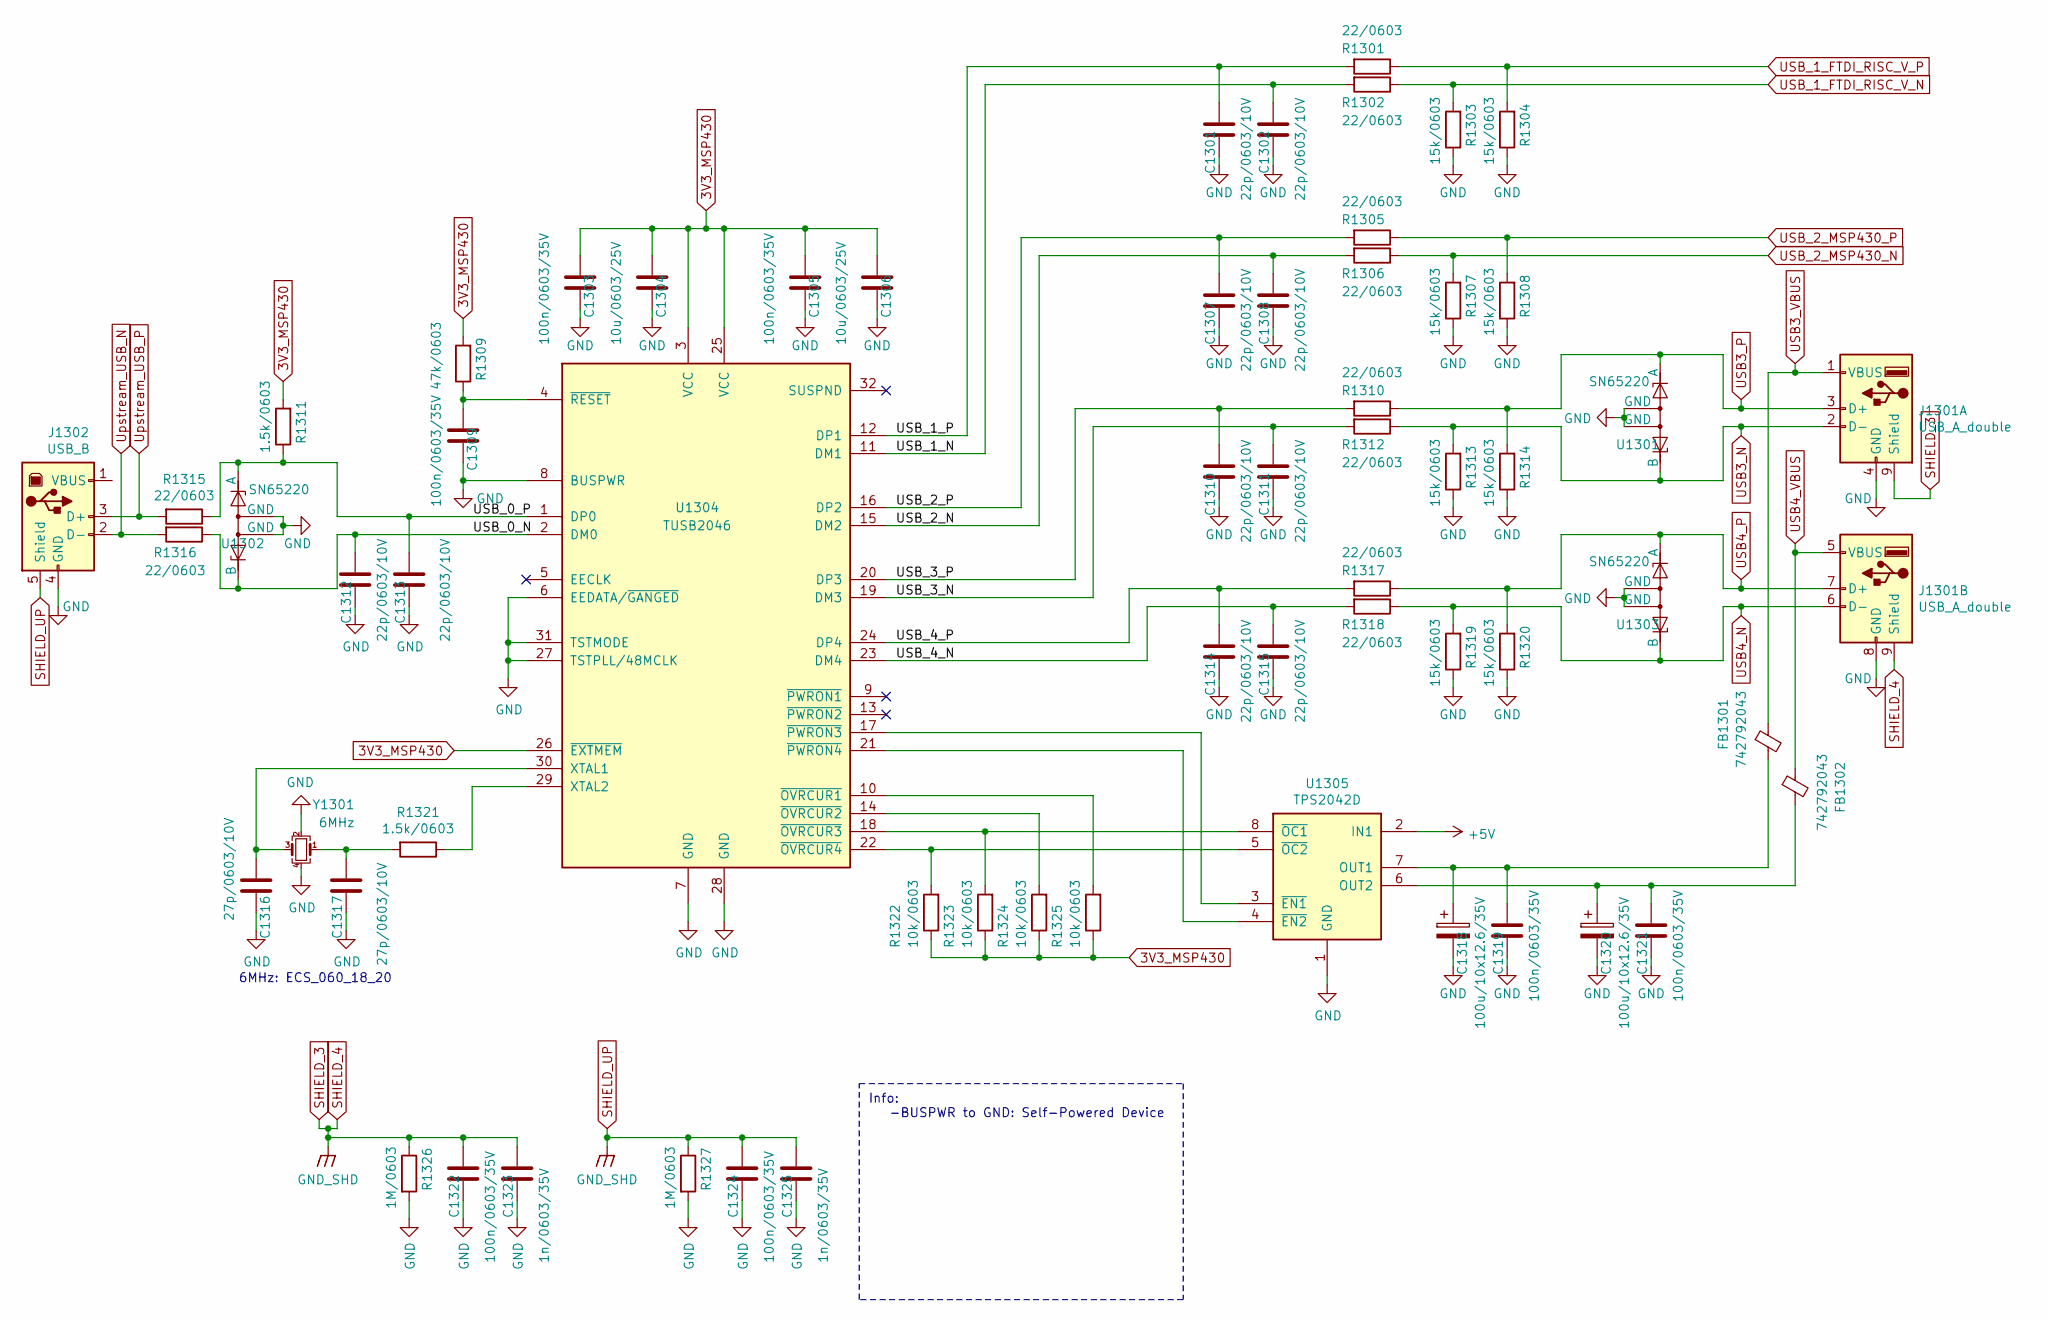
[picture p45: schematic usb.sch]

Parts:
C1301, C1302, C1307, C1308, C1310, C1311, C1312, C1313, C1314, C1315: 22p/0603/10V; C_0603_1608Metric
C1303, C1305, C1309, C1319, C1321, C1322, C1324: 100n/0603/35V; C_0603_1608Metric
C1304, C1306: 10u/0603/25V; C_0603_1608Metric
C1316, C1317: 27p/0603/10V; C_0603_1608Metric
C1318, C1320: 100u/10x12.6/35V; CP_Elec_10x12.6
C1323, C1325: 1n/0603/35V; C_0603_1608Metric
FB1301, FB1302: 742792043; C_0805_2012Metric
J1301: USB_A_double; USB_A_Wuerth_61400826021_Horizontal_Stacked
J1302: USB_B; USB_B_WE_61400416121
R1301, R1302, R1305, R1306, R1310, R1312, R1315, R1316, R1317, R1318: 22/0603; R_0603_1608Metric
R1303, R1304, R1307, R1308, R1313, R1314, R1319, R1320: 15k/0603; R_0603_1608Metric
R1309: 47k/0603; R_0603_1608Metric
R1311, R1321: 1.5k/0603; R_0603_1608Metric
R1322, R1323, R1324, R1325: 10k/0603; R_0603_1608Metric
R1326, R1327: 1M/0603; R_0603_1608Metric
U1301, U1302, U1303: SN65220; SOT-23-6
U1304: TUSB2046; LQFP-32_7x7mm_P0.8mm
U1305: TPS2042D; SOIC-8_3.9x4.9mm_P1.27mm
Y1301: 6MHz; Crystal_SMD_7050-4Pin_7.0x5.0mm

Connections:
3V3_MSP430: C1303.1, C1304.1, C1305.1, C1306.1, R1309.2, R1311.2, R1322.1, R1323.1, R1324.1, R1325.1, U1304.3 (VCC), U1304.25 (VCC), U1304.26 (~EXTMEM)
+5V: U1305.2 (IN1)
GND: C1301.2, C1302.2, C1303.2, C1304.2, C1305.2, C1306.2, C1307.2, C1308.2, C1309.2, C1310.2, C1311.2, C1312.2, C1313.2, C1314.2, C1315.2, C1316.2, C1317.2, C1318.2, C1319.2, C1320.2, C1321.2, C1322.2, C1323.2, C1324.2, C1325.2, J1301.4 (GND), J1301.8 (GND), J1302.4 (GND), R1303.1, R1304.1, R1307.1, R1308.1, R1313.1, R1314.1, R1319.1, R1320.1, R1326.2, R1327.2, U1301.2 (GND), U1301.5 (GND), U1302.2 (GND), U1302.5 (GND), U1303.2 (GND), U1303.5 (GND), U1304.6 (EEDATA/~GANGED), U1304.7 (GND), U1304.8 (BUSPWR), U1304.27 (TSTPLL/48MCLK), U1304.28 (GND), U1304.31 (TSTMODE), U1305.1 (GND), Y1301.2, Y1301.4
GND_SHD: C1322.1, C1323.1, C1324.1, C1325.1, J1301.9 (Shield), J1302.5 (Shield), R1326.1, R1327.1
unnamed: C1309.1, R1309.1, U1304.4 (~RESET)
unnamed: C1316.1, U1304.30 (XTAL1), Y1301.3
unnamed: C1317.1, R1321.2, Y1301.1
unnamed: C1318.1, C1319.1, FB1301.2, U1305.7 (OUT1)
unnamed: C1320.1, C1321.1, FB1302.2, U1305.6 (OUT2)
unnamed: R1321.1, U1304.29 (XTAL2)
unnamed: R1322.2, U1304.22 (~OVRCUR4), U1305.5 (~OC2)
unnamed: R1323.2, U1304.18 (~OVRCUR3), U1305.8 (~OC1)
unnamed: R1324.2, U1304.14 (~OVRCUR2)
unnamed: R1325.2, U1304.10 (~OVRCUR1)
unnamed: U1304.17 (~PWRON3), U1305.3 (~EN1)
unnamed: U1304.21 (~PWRON4), U1305.4 (~EN2)
USB3_N: J1301.2 (D-), R1312.1, R1313.2, U1301.4 (B)
USB3_P: J1301.3 (D+), R1310.1, R1314.2, U1301.6 (A)
USB3_VBUS: FB1301.1, J1301.1 (VBUS)
USB4_N: J1301.6 (D-), R1318.1, R1319.2, U1303.4 (B)
USB4_P: J1301.7 (D+), R1317.1, R1320.2, U1303.6 (A)
USB4_VBUS: FB1302.1, J1301.5 (VBUS)
USB_0_N: C1312.1, R1316.1, U1302.4 (B), U1304.2 (DM0)
USB_0_P: C1313.1, R1311.1, R1315.1, U1302.6 (A), U1304.1 (DP0)
USB_1_FTDI_RISC_V_N: R1302.1, R1303.2
USB_1_FTDI_RISC_V_P: R1301.1, R1304.2
USB_1_N: C1302.1, R1302.2, U1304.11 (DM1)
USB_1_P: C1301.1, R1301.2, U1304.12 (DP1)
USB_2_MSP430_N: R1306.1, R1307.2
USB_2_MSP430_P: R1305.1, R1308.2
USB_2_N: C1308.1, R1306.2, U1304.15 (DM2)
USB_2_P: C1307.1, R1305.2, U1304.16 (DP2)
USB_3_N: C1311.1, R1312.2, U1304.19 (DM3)
USB_3_P: C1310.1, R1310.2, U1304.20 (DP3)
USB_4_N: C1315.1, R1318.2, U1304.23 (DM4)
USB_4_P: C1314.1, R1317.2, U1304.24 (DP4)
Upstream_USB_N: J1302.2 (D-), R1316.2
Upstream_USB_P: J1302.3 (D+), R1315.2

Notes on the sheet:
Info: -BUSPWR to GND: Self-Powered Device
6MHz: ECS_060_18_20
