ArneAlberts/Bachelorarbeit_Anhang/Schaltung_Layout/Adapter_Modulator/Adapter_Modulator/Adapter_Modulator.sch

## KiCad design Schaltung_Layout/Adapter_Modulator/Adapter_Modulator/Adapter_Modulator.sch (2021-09-20)

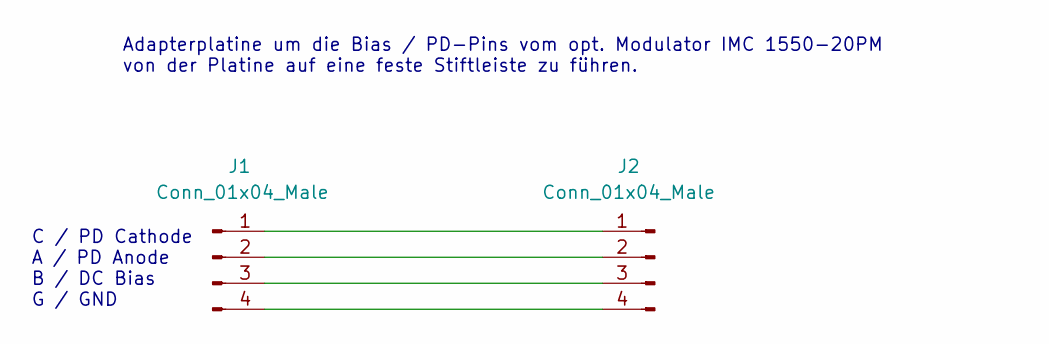
[picture p46: schematic Adapter_Modulator.sch]

Parts:
J1: Conn_01x04_Male; IMC_1550_20PM_Pin_Header
J2: Conn_01x04_Male; PinHeader_1x04_P2.54mm_Horizontal

Connections:
unnamed: J1.1, J2.1
unnamed: J1.2, J2.2
unnamed: J1.3, J2.3
unnamed: J1.4, J2.4

Notes on the sheet:
Adapterplatine um die Bias / PD-Pins vom opt. Modulator IMC 1550-20PM von der Platine auf eine feste Stiftleiste zu führen.
C / PD Cathode A / PD Anode B / DC Bias G / GND
