ArneAlberts/Bachelorarbeit_Anhang/(notices)

Notices in the files:
Schaltung_Layout/3dpackages/BSW-104-X-X-S.step:
FILE_NAME( 'e:/temp/worker_19/temp/exporttempdir_1260_784_F8Rsa/format_0/BSW-104-04-L-S.stp', '2021-07-14T10:19:05', ( 'License CC BY-ND 4.0' ), ( 'CADENAS' ), ' ', 'PARTsolutions', ' ' );
